steveamena/ManteSistemas/Nomenclatura Engranes.jpeg

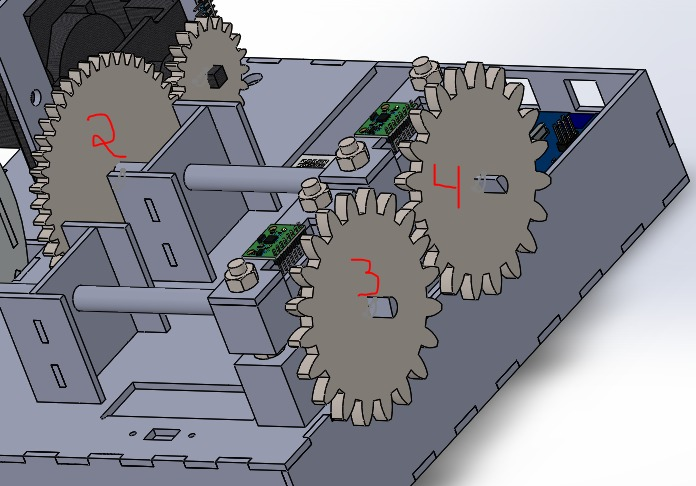
Nomenclatura Engranes.jpeg
