steveamena/ManteSistemas/Protipo_Real.jpg

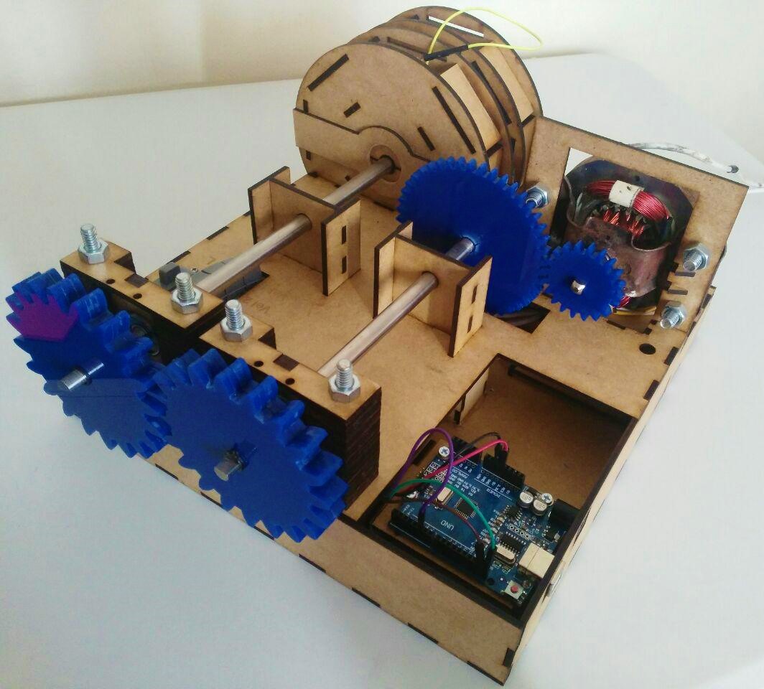
Protipo_Real.jpg
