steveamena/ManteSistemas/README.md

# ManteSistemas
Archivo en git-hub para depositar los diseños de soldworks
