steveamena/ManteSistemas/Control de Compras y amortizacion.xlsx

Sheet: Cálculos
Articulos proyectados comprar |  |  |  |  | Estimación de costos
Artículo | Cant. | Costo/unidad (CRC) | Costo CRC | Comprador | Cantidad | Rubro | Precio/unidad | Precio total | Compra
Dimmer | 1 | 3500 | 3500.00 | D | 1 | Varilla calibrada | 1500 | 1500 | 1
Roles | 6 | 2000 | 12000.00 | D | 3 | Roles 1/4 in | 2500 | 7500 | 1
Jumpers | 16 | 125 | 2000.00 | S | 4 | Acelerómetros | 2850 | 11400 | 1
Tornillos | 1 | 810 | 810.00 | S | 1 | MDF 6 mm 1/4 | 300 | 300 | 1
Acelerómetros | 4 | 2750 | 11000 | S | 1 | Acrílico 6 mm 1/8 | 660 | 660 | 1
Protoboard pequeña | 1 | 2150 | 2150 | S | 1 | Cortes MDF | 4000 | 4000 | 1
Jumpers | 12 | 125 | 1500 | S | 1 | Cortes Acrílico | 800 | 800 | 1
 |  |  |  |  | 4 | Tuercas y tornillos rol | 100 | 400 | 1
 |  |  |  |  | 16 | Tornillos sujeción de sensores | 50 | 800 | 1
 |  |  |  |  | 1 | Cable UTP | 300 | 300 | 1
 |  |  |  |  | 1 | Termocontraíble | 300 | 300 | 1
 |  |  |  |  | 2 | Anillos retención | 200 | 400 | 1
 |  |  |  |  | 1 | Soldadura estaño | 500 | 500 | 1
Total |  |  | 32960.00 |  | 1 | Dimmer | 3500 | 500 | 1
 |  |  |  |  |  |  | Total | 29360 | 1
Amortización de la deuda
Mes | Adicionales | Deuda total | Cuota Mensual | Saldo
abr |  | 29360.00 | 9786.67 | 19573.33
may |  | 19573.33 | 9786.67 | 9786.67
jun |  | 9786.67 | 9786.67 | 0.00

Sheet: Control de pagos
Mes | abr | may | jun
Monto | 0.00 | 0.00 | 0.00
Steve M | 0 | 0 | 0
Diego A | 1 | 1 | 1
 |  |  |  | Grand total
Total | 0.00 | 0.00 | 0.00 | 0.00
