steveamena/ManteSistemas/Base/EnsamblajeBase.SLDASM

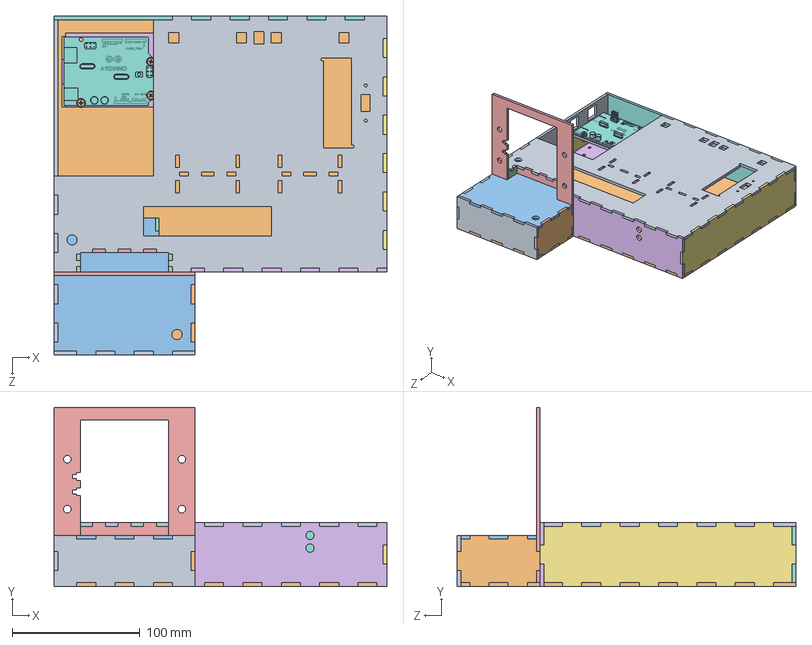
[picture p9: CAD file, 2018-06-08]
Base/EnsamblajeBase.SLDASM
260.0 x 140.0 x 265.0 mm
Base1
Base2
Base4
Bae5_2 x 2
Base6
Base7
Base8
Base9
Base10
Base12
Soporte_Arduino x 2
Lateral x 2
Arduino board
Base11
flat head screw_am x 3
hex thin nut chamfered gradeab_iso x 3
plain washer 10673 type snl_iso x 3
Base3_2
Soporte_a_base x 4
