steveamena/ManteSistemas/Carga/EnsamblajeCarga.SLDASM

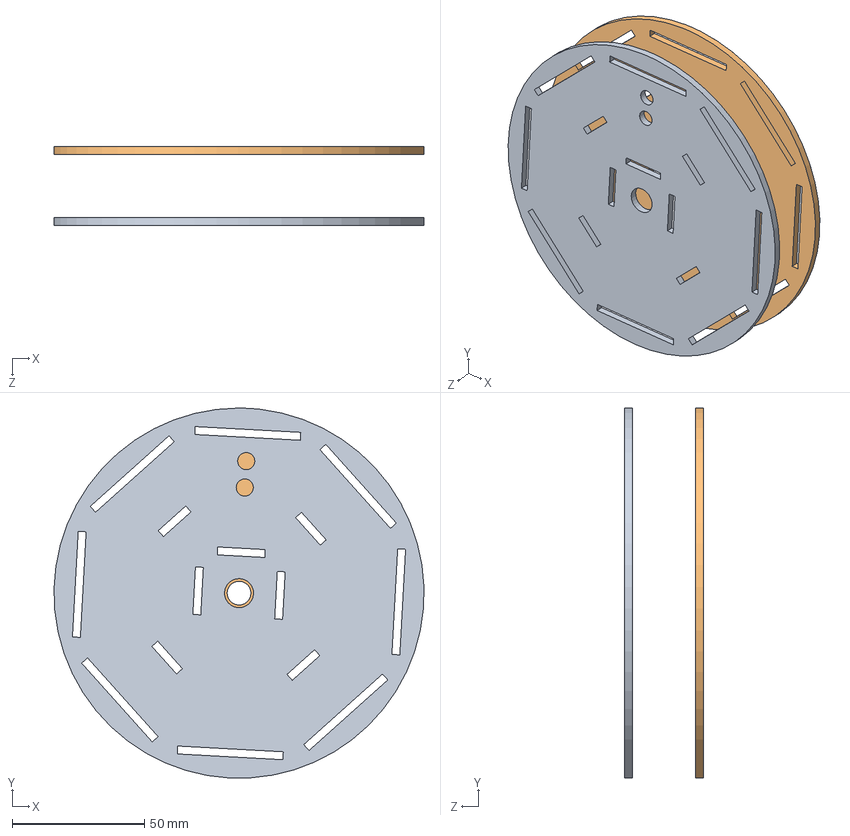
[picture p10: CAD file, 2018-06-08]
Carga/EnsamblajeCarga.SLDASM
139.9 x 139.9 x 30.0 mm
Carga3_1
Carga1
