steveamena/ManteSistemas/EnsamblajeFinal2.SLDASM

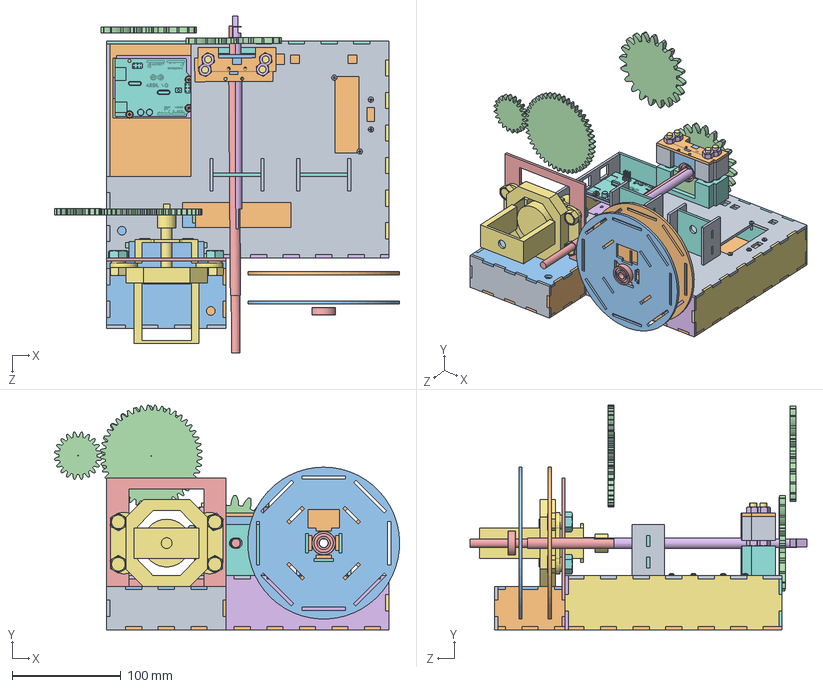
[picture p11: CAD file, 2018-06-08]
EnsamblajeFinal2.SLDASM
318.2 x 207.2 x 310.6 mm
Base1
Base2
Base4
Bae5_2 x 2
Base6
Base7
Base8
Base9
Base10
Base12
Soporte_Arduino x 2
Lateral x 2
Arduino board
Base11
flat head screw_am x 3
hex thin nut chamfered gradeab_iso x 3
plain washer 10673 type snl_iso x 3
Base3_2 x 2
Soporte_a_base x 4
Motor
Pieza_Inferior x 2
Pieza_Superior x 4
Base_Sensor x 2
Central_Pieza x 2
Central_Pieza Inferior x 2
radial ball bearing_68_skf x 3
hex nut_ai x 8
round head square neck bolt_ai x 4
SoporteEje1 x 2
SoporteEje2 x 4
Carga3_1
Carga1
spur gear_am x 4
Eje_Carga
Eje
hex screw_ai x 4
machine screw nut hex_ai x 4
pan head cross recess screw_iso x 4
basic internal retaining ring_am x 3
