steveamena/ManteSistemas/Soporte Arduino/Ensamblaje_Electronica.SLDASM

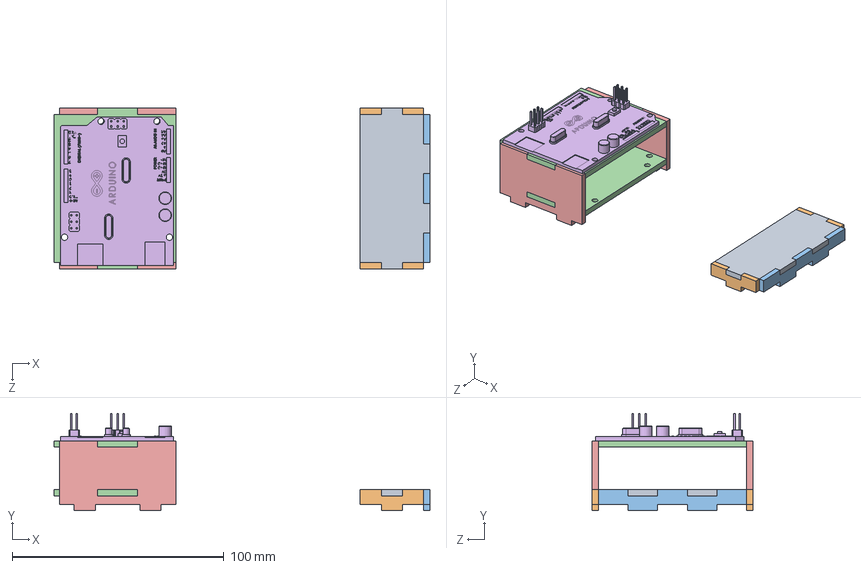
[picture p12: CAD file, 2018-06-08]
Soporte Arduino/Ensamblaje_Electronica.SLDASM
177.5 x 46.0 x 76.0 mm
Superior Derecha
Soporte Frontal x 2
Soporte Lateral
Soporte_Arduino x 2
Lateral x 2
Arduino board
