steveamena/ManteSistemas/Soporte Rol/Soporte_Rol.SLDASM

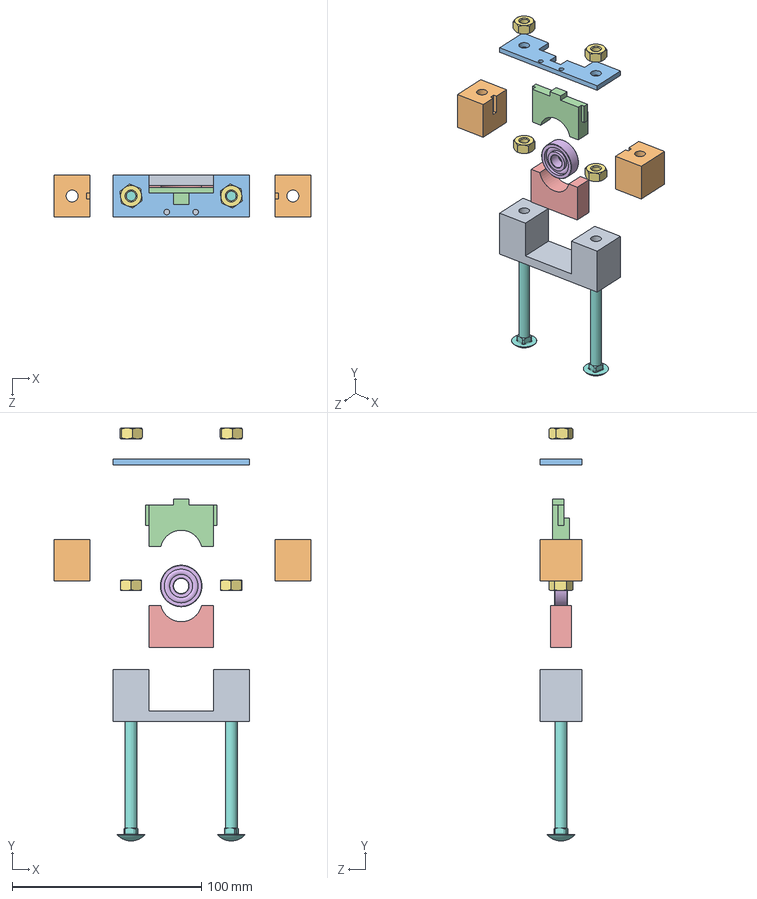
[picture p13: CAD file, 2018-06-08]
Soporte Rol/Soporte_Rol.SLDASM
135.7 x 218.4 x 22.0 mm
Pieza_Inferior
Pieza_Superior x 2
Base_Sensor
Central_Pieza
Central_Pieza Inferior
radial ball bearing_68_skf
hex nut_ai x 4
round head square neck bolt_ai x 2
