steveamena/ManteSistemas/SoporteEje/EnsamblajeSoporteEje.SLDASM

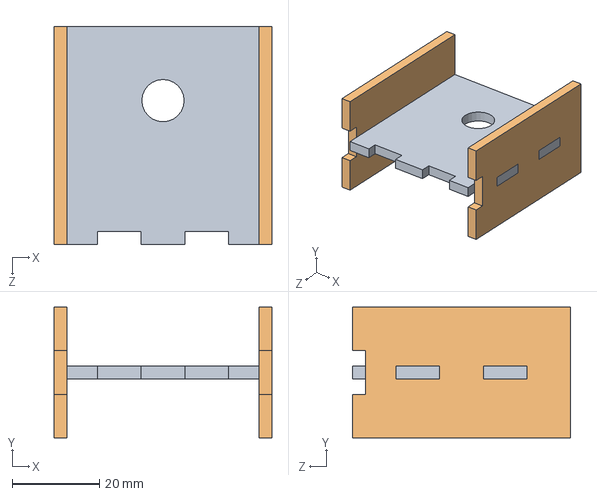
[picture p14: CAD file, 2018-04-15]
SoporteEje/EnsamblajeSoporteEje.SLDASM
50.0 x 30.0 x 50.0 mm
SoporteEje1
SoporteEje2 x 2
