steveamena/ManteSistemas/Soporte Arduino/Soporte Izquierda.SLDASM

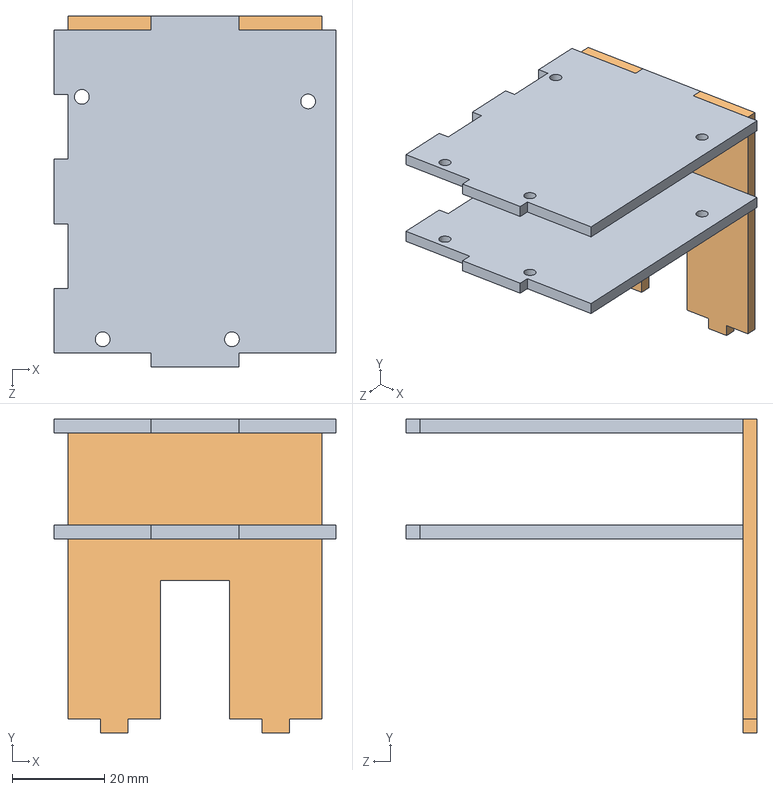
[picture p15: CAD file, 2018-05-15]
Soporte Arduino/Soporte Izquierda.SLDASM
61.0 x 68.0 x 76.0 mm
Soporte_Arduino x 2
Lateral
