steveamena/ManteSistemas/Acelerometro Lateral/Sccel_Lat.SLDASM

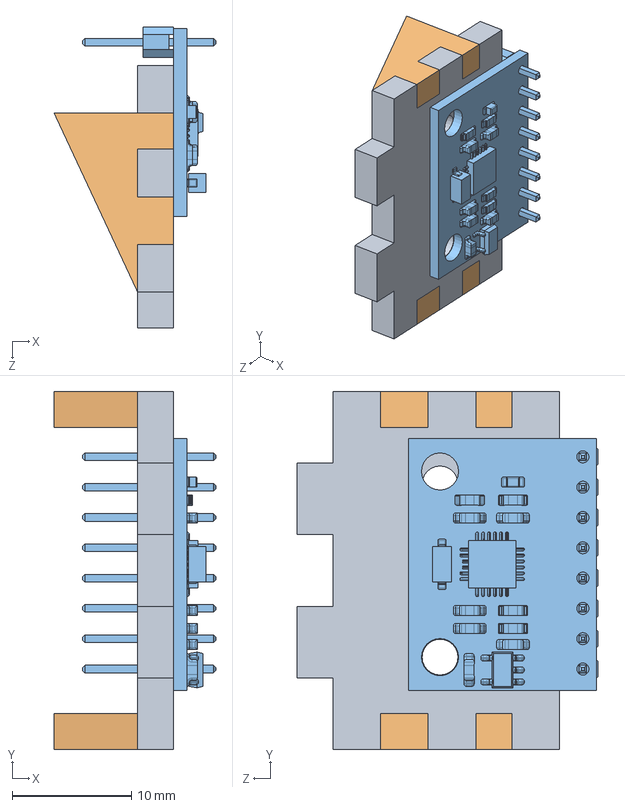
[picture p16: CAD file, 2018-04-23]
Acelerometro Lateral/Sccel_Lat.SLDASM
13.6 x 30.0 x 25.2 mm
Acelerometro_Motor_1
Acelerometro_Motor_2 x 2
Acelerometro
