steveamena/ManteSistemas/EnsamblajeFinal2 - Backup 7-06-2018.SLDASM

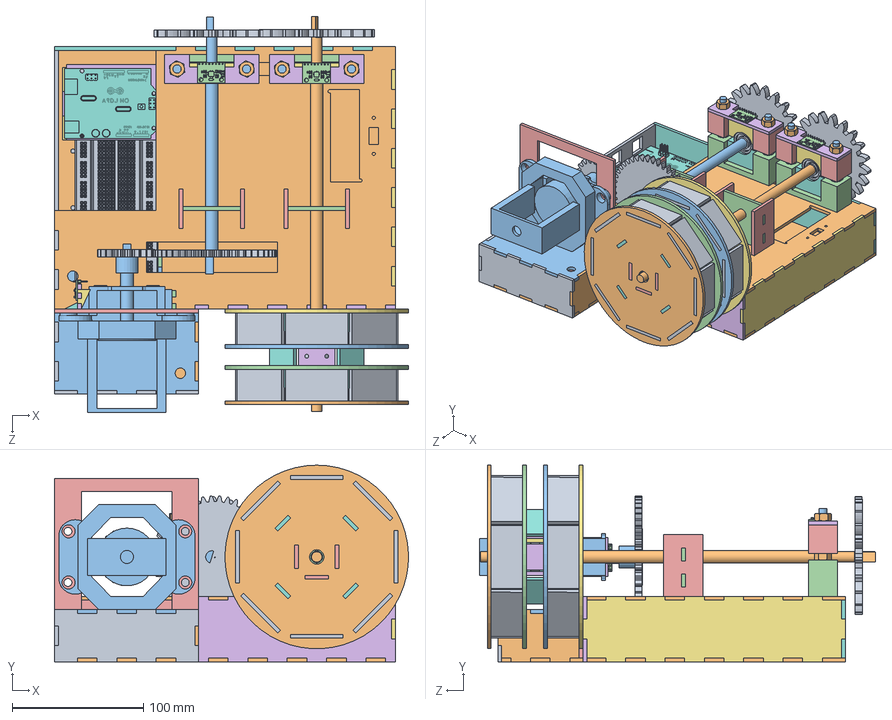
[picture p17: CAD file, 2018-05-24]
EnsamblajeFinal2 - Backup 7-06-2018.SLDASM
270.0 x 150.0 x 302.1 mm
Base1
Base2
Base4
Bae5_2 x 2
Base6
Base7
Base8
Base9
Base10
Base12
Superior Derecha
Soporte Frontal x 2
Soporte Lateral
Soporte_Arduino x 2
Lateral x 2
Arduino board
BreadBoard Large
Base11
Motor
Pieza_Inferior x 2
Pieza_Superior x 4
Base_Sensor x 2
Central_Pieza x 2
Central_Pieza Inferior x 2
radial ball bearing_68_skf x 3
hex nut_ai x 8
round head square neck bolt_ai x 4
SoporteEje1 x 2
SoporteEje2 x 4
Carga2 x 3
Carga3_1
Carga4 x 4
Carga5 x 16
Carga3
Carga1
Carga1_1
Carga6 x 6
Acelerometro_Sujecion
Carga2_Acelerometro
Sujecion_Rol_Lateral x 2
spur gear_am x 4
Eje_Carga
Eje
Acelerometro x 3
Base3_2
Acelerometro_Motor_1
Acelerometro_Motor_2 x 2
Puntal x 2
