steveamena/ManteSistemas/Soporte Arduino/Soporte Derecha.SLDASM

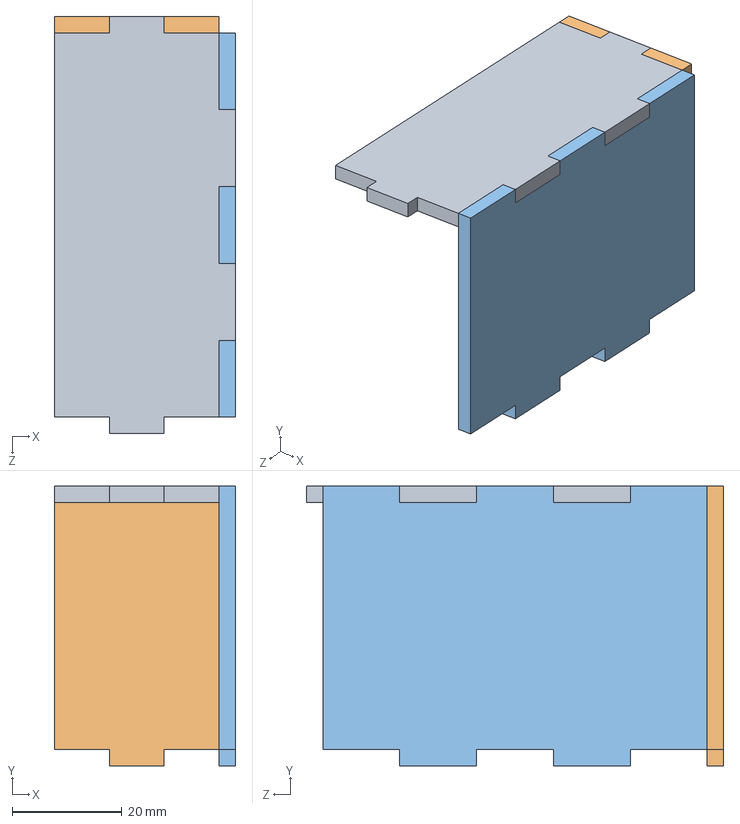
[picture p18: CAD file, 2018-04-15]
Soporte Arduino/Soporte Derecha.SLDASM
33.0 x 51.0 x 76.0 mm
Superior Derecha
Soporte Frontal
Soporte Lateral
