steveamena/ManteSistemas/Carga/EnsamblajeCarga Nuevo.SLDASM

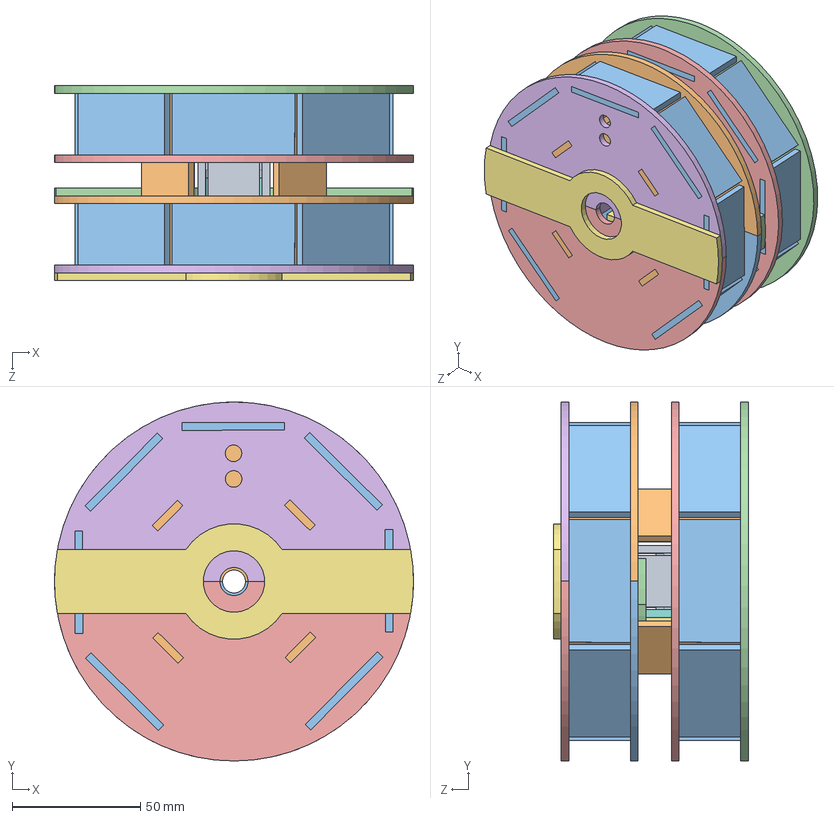
[picture p19: CAD file, 2018-06-08]
Carga/EnsamblajeCarga Nuevo.SLDASM
140.0 x 140.0 x 76.0 mm
Carga2 x 3
Carga4 x 4
Carga5 x 16
Carga3
Carga1_1
Carga6 x 6
Acelerometro_Sujecion
Carga2_Acelerometro
Sujecion_Rol_Lateral x 2
Carga1_CAMBIOS2
Carga1_CAMBIOS1
Soportepiezas2
Carga3_1_CAMBIOS
Carga3_1_CAMBIOS2
Soportepiezas1
