steveamena/ManteSistemas/EnsamblajeFinal.SLDASM

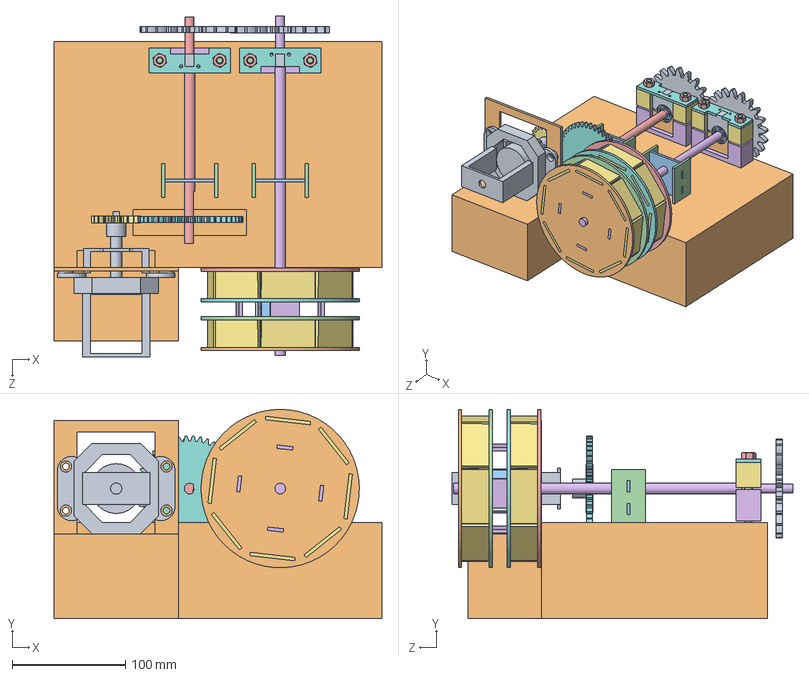
[picture p20: CAD file, 2018-04-15]
EnsamblajeFinal.SLDASM
290.0 x 185.0 x 301.3 mm
Motor
Base
Carga2 x 4
Carga1
Carga3_1
Carga4 x 4
Carga5 x 16
Carga1_1
Acelerometro_Sujecion
Carga3
SoporteEje1 x 2
SoporteEje2 x 4
Eje
Pieza_Inferior x 2
Pieza_Superior x 4
Base_Sensor x 2
Central_Pieza x 2
Central_Pieza Inferior x 2
radial ball bearing_68_skf x 3
hex bolt_ai x 4
hex nut_ai x 8
Eje_Carga
Engrane1
Engrane2
Engrane3y4 x 2
