steveamena/ManteSistemas/Carga/Ensamblaje6.SLDASM

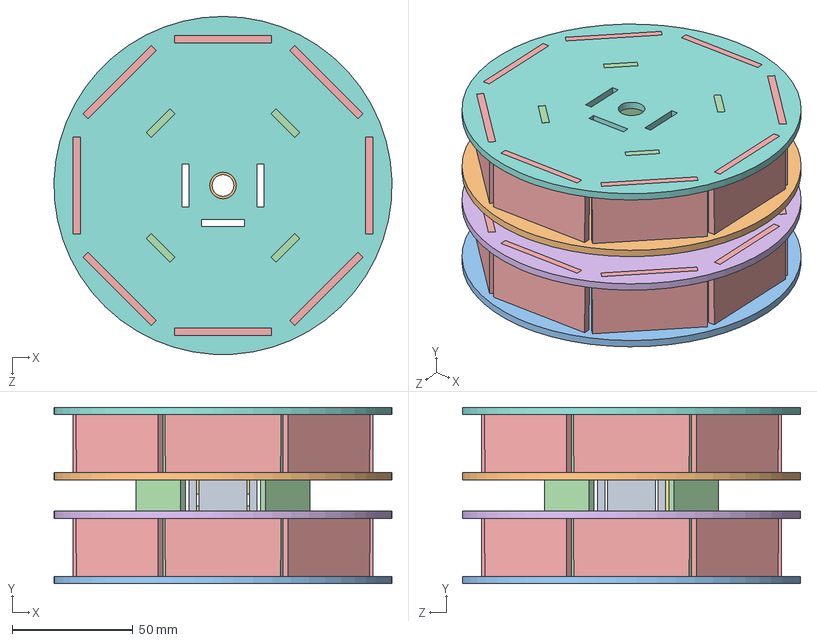
[picture p21: CAD file, 2018-06-08]
Carga/Ensamblaje6.SLDASM
139.9 x 73.0 x 140.0 mm
Carga2 x 4
Carga1
Carga3_1
Carga4 x 4
Carga5 x 16
Carga1_1
Acelerometro_Sujecion
Carga3
