steveamena/ManteSistemas/Acelerometro Lateral/Puntal.SLDPRT

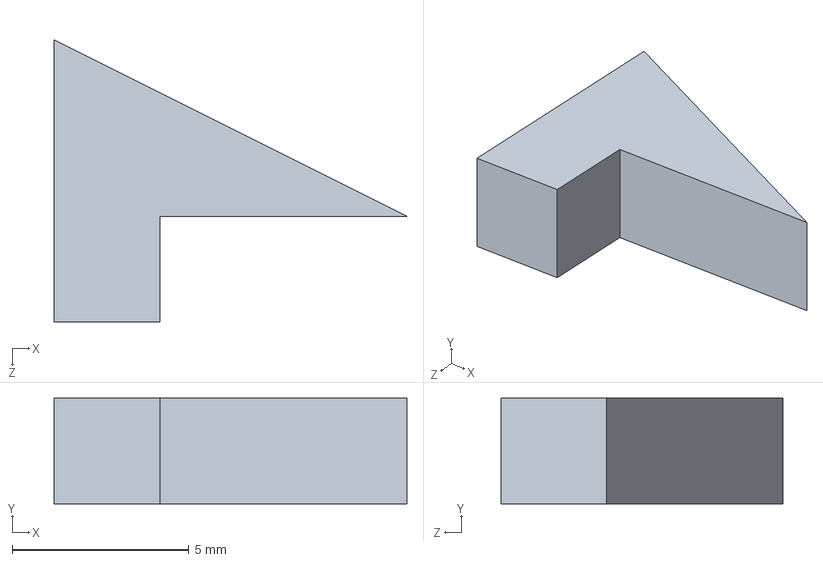
[picture p22: CAD file, 2018-04-23]
Acelerometro Lateral/Puntal.SLDPRT
10.0 x 3.00 x 8.00 mm
