steveamena/ManteSistemas/Soporte Arduino/Arduino/Arduino board.SLDPRT

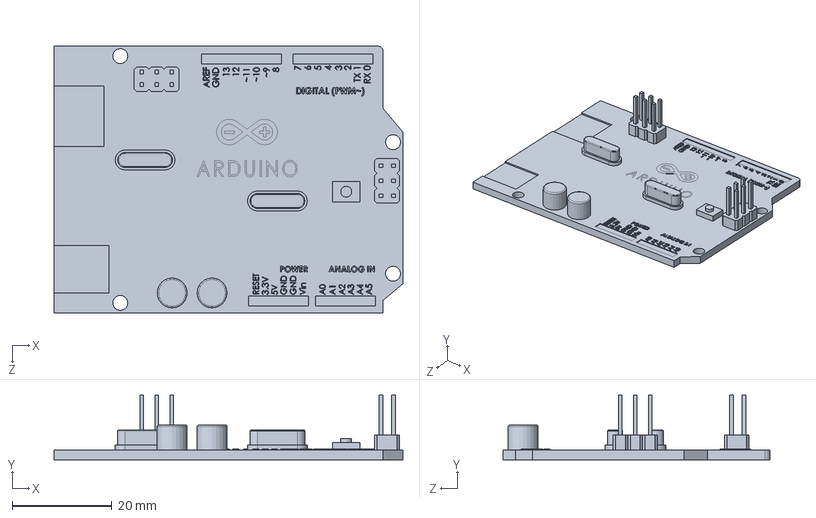
[picture p23: CAD file, 2018-04-09]
Soporte Arduino/Arduino/Arduino board.SLDPRT
70.0 x 13.0 x 53.5 mm
