steveamena/ManteSistemas/Soporte Arduino/Protoboard/BreadBoard Large.SLDPRT

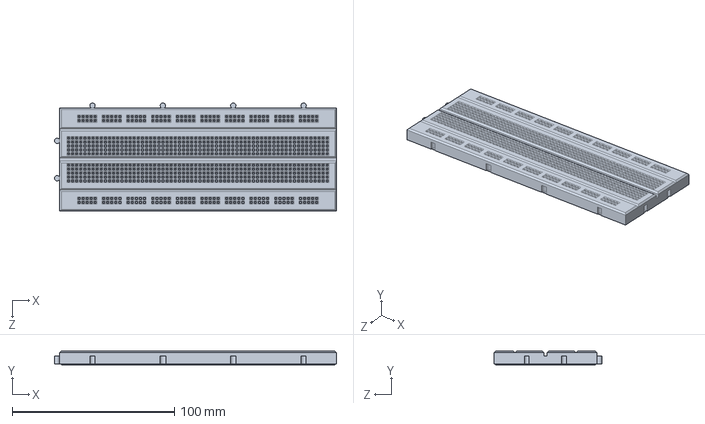
[picture p24: CAD file, 2018-04-09]
Soporte Arduino/Protoboard/BreadBoard Large.SLDPRT
173.7 x 8.50 x 66.6 mm
