steveamena/ManteSistemas/Acelerometro Lateral/Acelerometro_Motor_2.SLDPRT

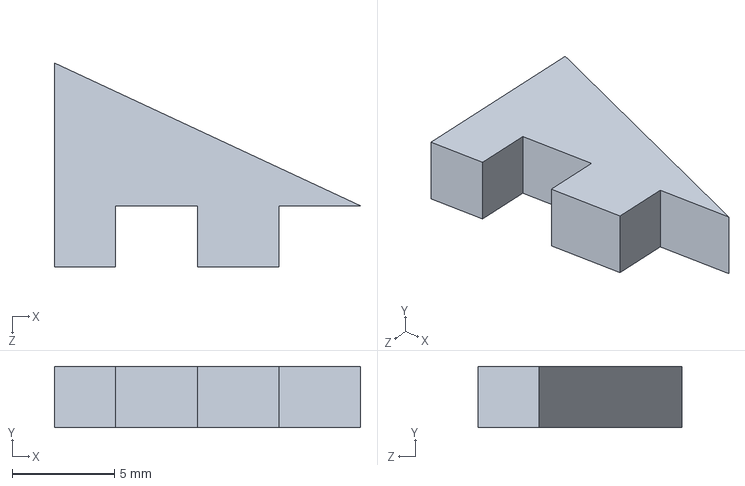
[picture p25: CAD file, 2018-04-23]
Acelerometro Lateral/Acelerometro_Motor_2.SLDPRT
15.0 x 3.00 x 10.0 mm
