steveamena/ManteSistemas/Base/Soporte_a_base.SLDPRT

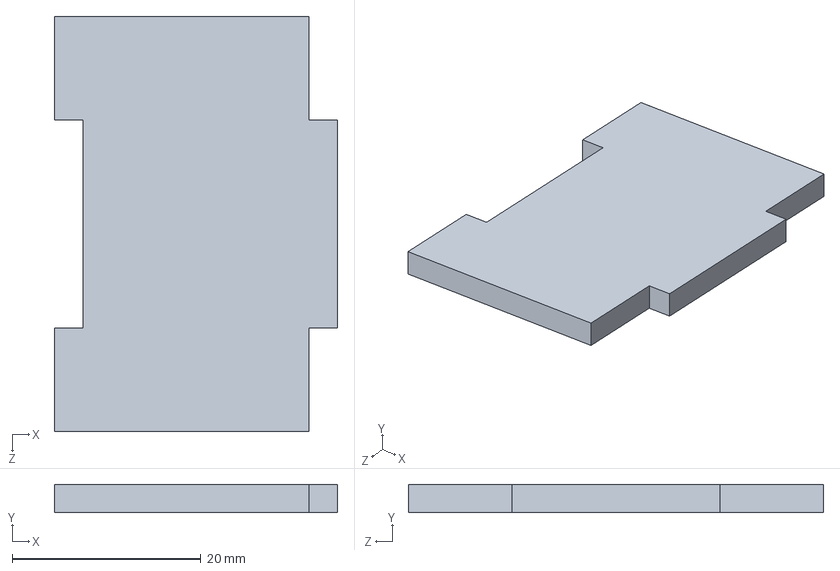
[picture p26: CAD file, 2018-05-24]
Base/Soporte_a_base.SLDPRT
30.0 x 3.00 x 44.0 mm
