steveamena/ManteSistemas/Engrane3_Motor.SLDPRT

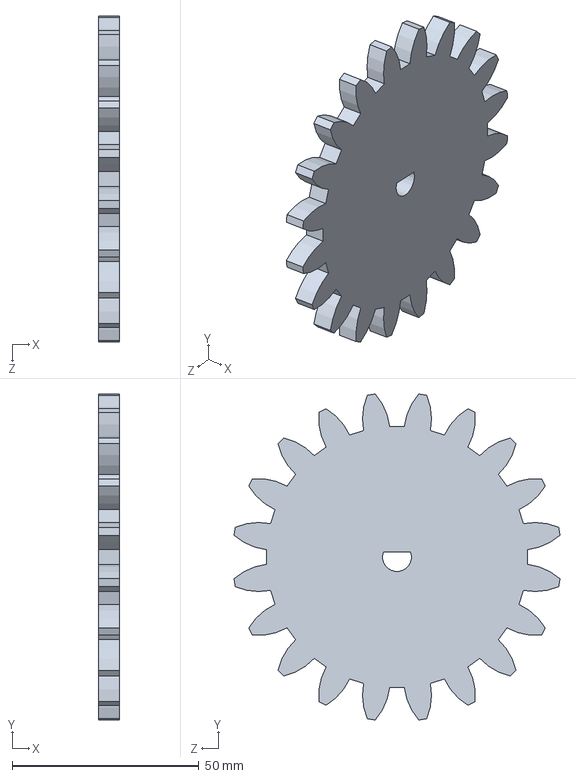
[picture p28: CAD file, 2018-05-24]
Engrane3_Motor.SLDPRT
5.50 x 87.2 x 87.2 mm
