steveamena/ManteSistemas/Soporte Rol/Eje.SLDPRT

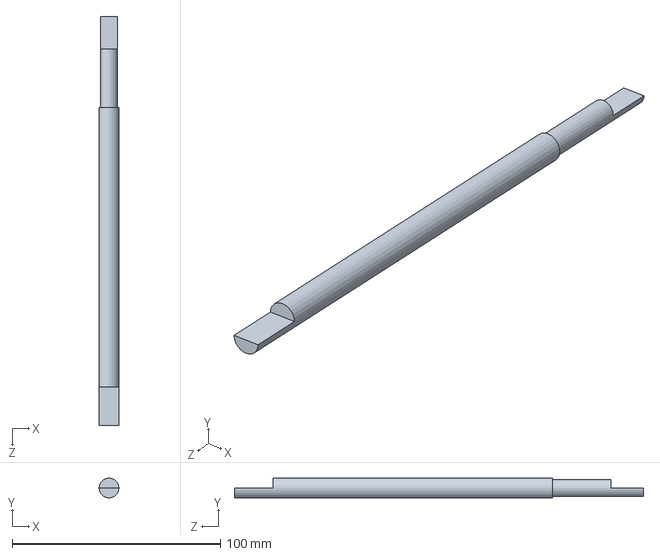
[picture p29: CAD file, 2018-05-04]
Soporte Rol/Eje.SLDPRT
9.53 x 9.53 x 196.2 mm
