steveamena/ManteSistemas/SoporteEje/SoporteEje2.SLDPRT

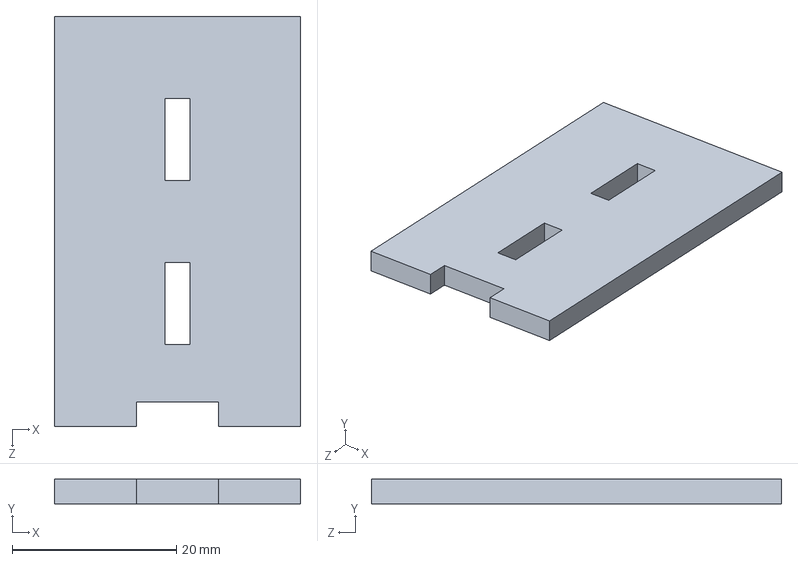
[picture p30: CAD file, 2018-04-15]
SoporteEje/SoporteEje2.SLDPRT
30.0 x 3.00 x 50.0 mm
