steveamena/ManteSistemas/Base/Base11.SLDPRT

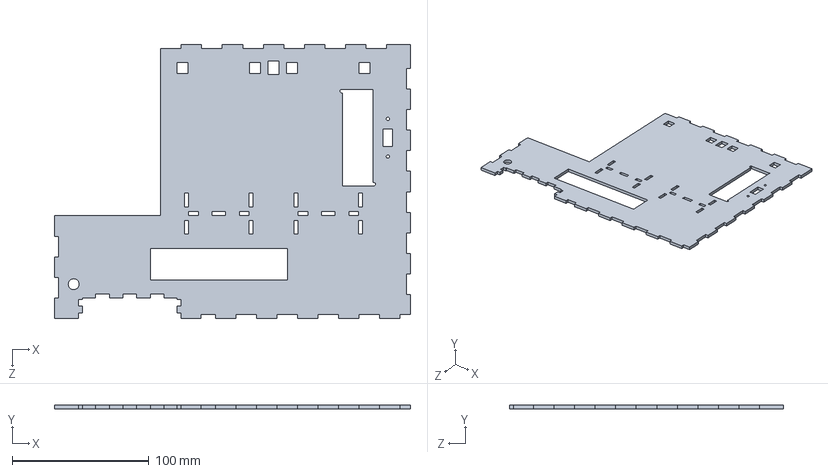
[picture p31: CAD file, 2018-05-09]
Base/Base11.SLDPRT
260.0 x 3.00 x 200.0 mm
