steveamena/ManteSistemas/Carga/Sujecion_Rol_Lateral.SLDPRT

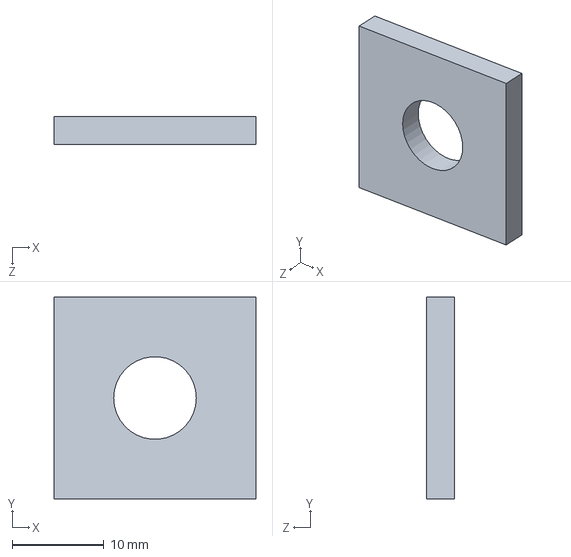
[picture p32: CAD file, 2018-06-08]
Carga/Sujecion_Rol_Lateral.SLDPRT
22.0 x 22.0 x 3.00 mm
