steveamena/ManteSistemas/Soporte Arduino/Soporte_Arduino.SLDPRT

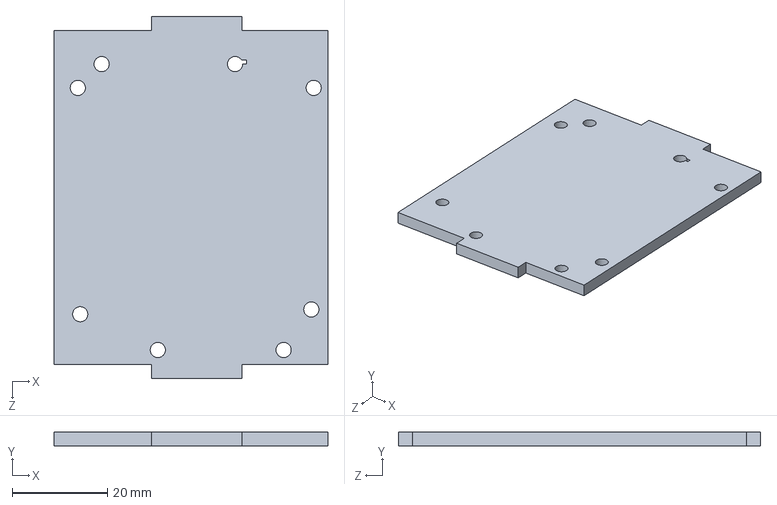
[picture p33: CAD file, 2018-05-09]
Soporte Arduino/Soporte_Arduino.SLDPRT
57.5 x 3.00 x 76.0 mm
