steveamena/ManteSistemas/Soporte Rol/Pieza_Inferior.SLDPRT

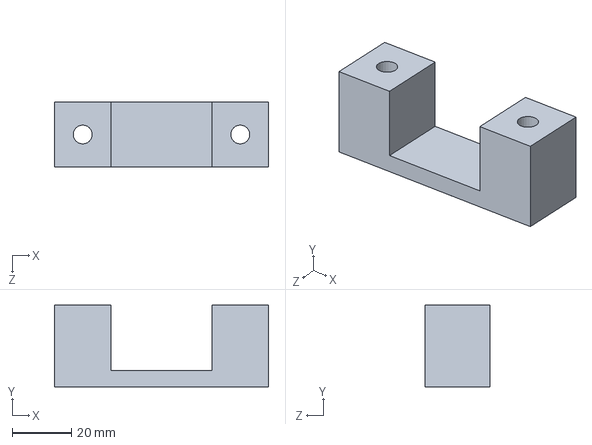
[picture p34: CAD file, 2018-04-23]
Soporte Rol/Pieza_Inferior.SLDPRT
72.0 x 27.5 x 22.0 mm
