steveamena/ManteSistemas/SoporteEje/SoporteEje1.SLDPRT

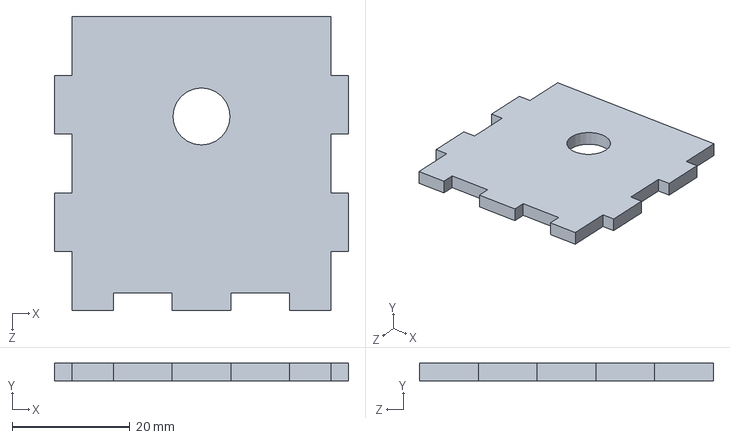
[picture p35: CAD file, 2018-04-15]
SoporteEje/SoporteEje1.SLDPRT
50.0 x 3.00 x 50.0 mm
