steveamena/ManteSistemas/Acelerometro Lateral/Acelerometro_Motor_1.SLDPRT

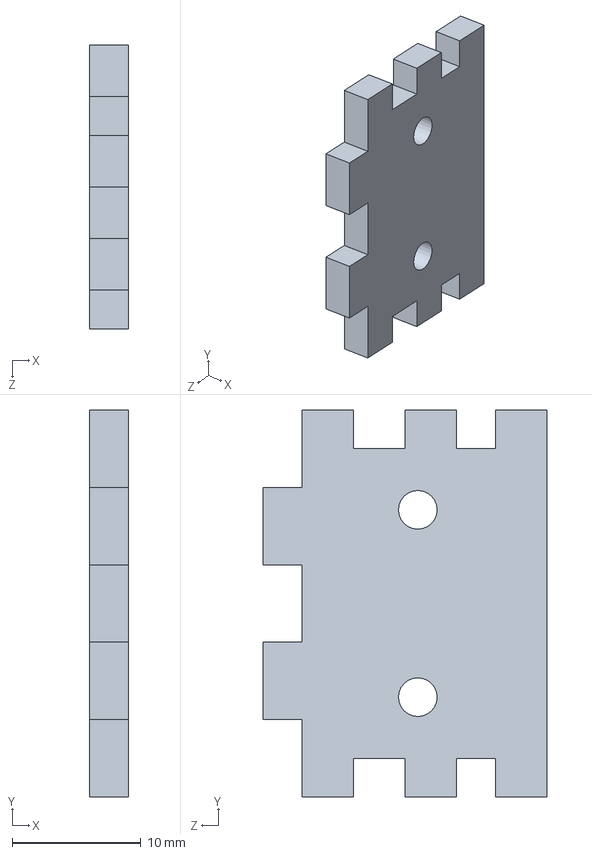
[picture p36: CAD file, 2018-04-23]
Acelerometro Lateral/Acelerometro_Motor_1.SLDPRT
3.00 x 30.0 x 22.0 mm
