steveamena/ManteSistemas/Base/Base4.SLDPRT

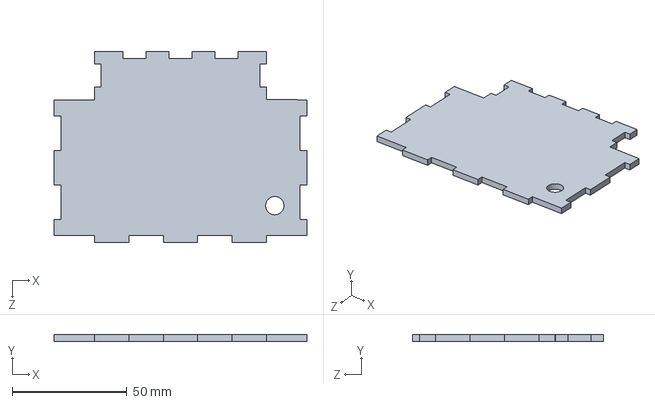
[picture p37: CAD file, 2018-04-26]
Base/Base4.SLDPRT
110.0 x 3.00 x 83.0 mm
