steveamena/ManteSistemas/Carga/Carga6.SLDPRT

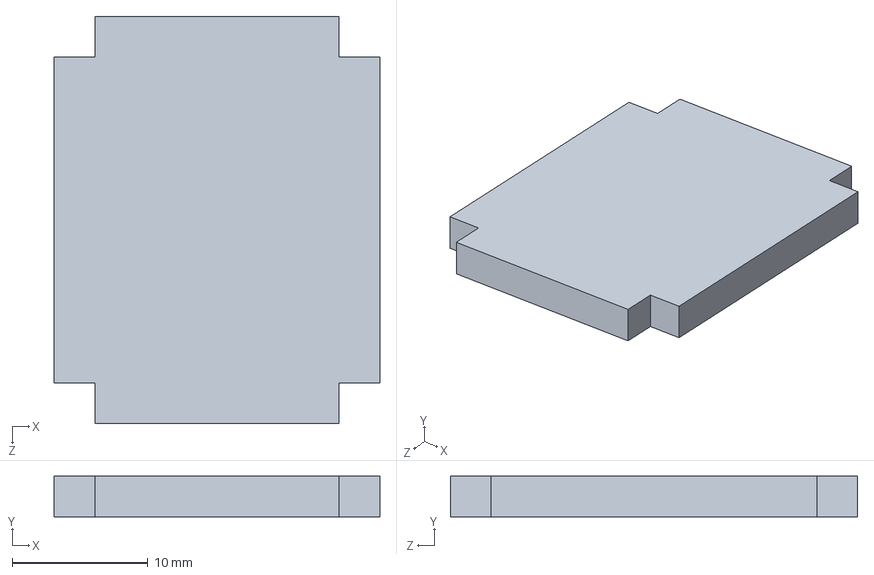
[picture p38: CAD file, 2018-06-08]
Carga/Carga6.SLDPRT
24.0 x 3.00 x 30.0 mm
