steveamena/ManteSistemas/Soporte Arduino/Lateral.SLDPRT

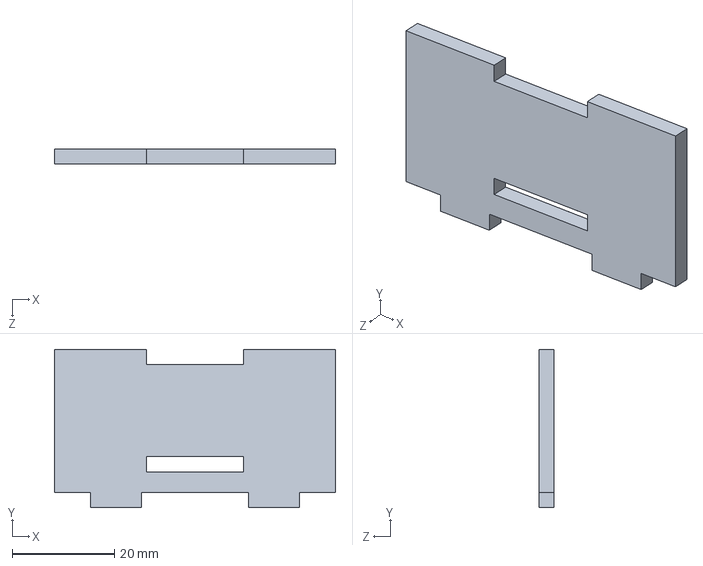
[picture p39: CAD file, 2018-05-09]
Soporte Arduino/Lateral.SLDPRT
55.0 x 31.0 x 3.00 mm
