steveamena/ManteSistemas/Soporte Rol/Central_Pieza.SLDPRT

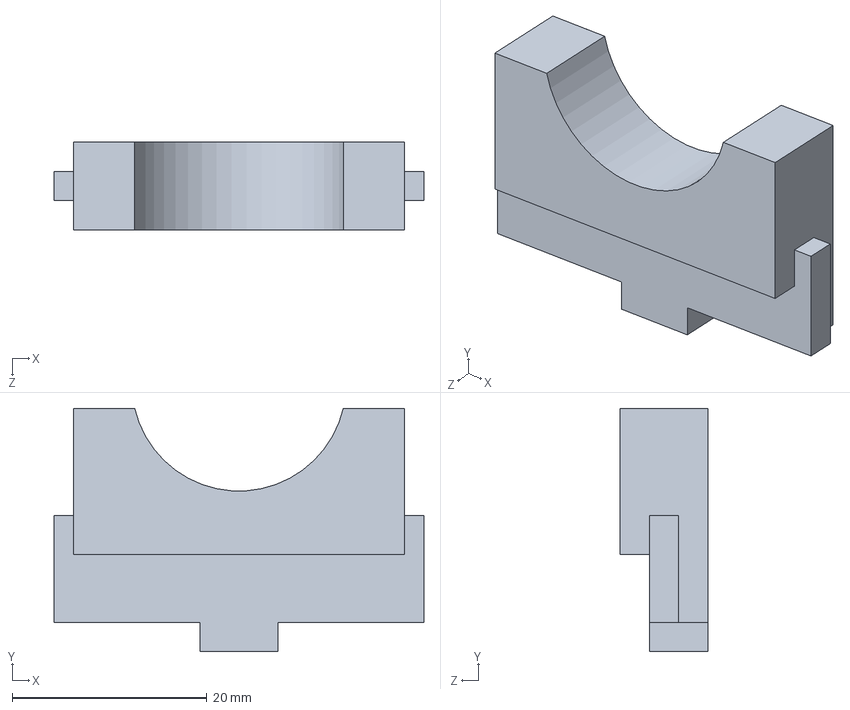
[picture p40: CAD file, 2018-04-17]
Soporte Rol/Central_Pieza.SLDPRT
38.0 x 25.0 x 9.00 mm
