steveamena/ManteSistemas/Base/Base10.SLDPRT

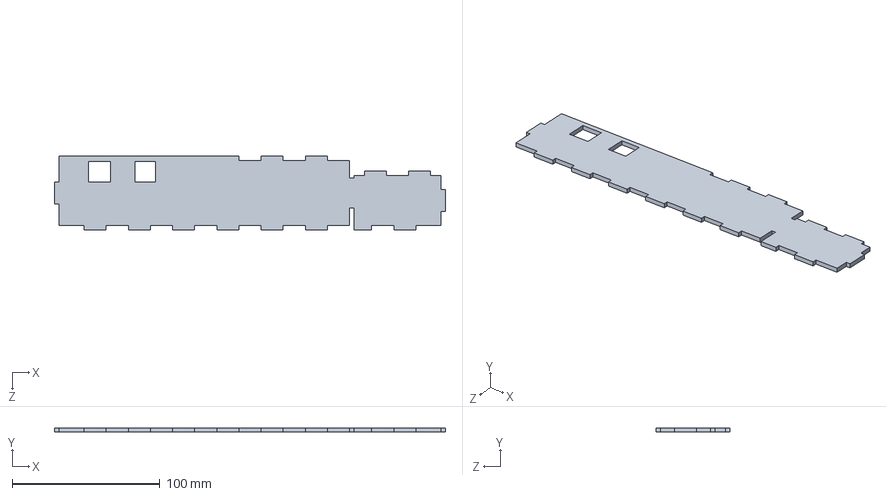
[picture p41: CAD file, 2018-04-26]
Base/Base10.SLDPRT
265.0 x 3.00 x 50.0 mm
