steveamena/ManteSistemas/Carga/Carga2_Acelerometro.SLDPRT

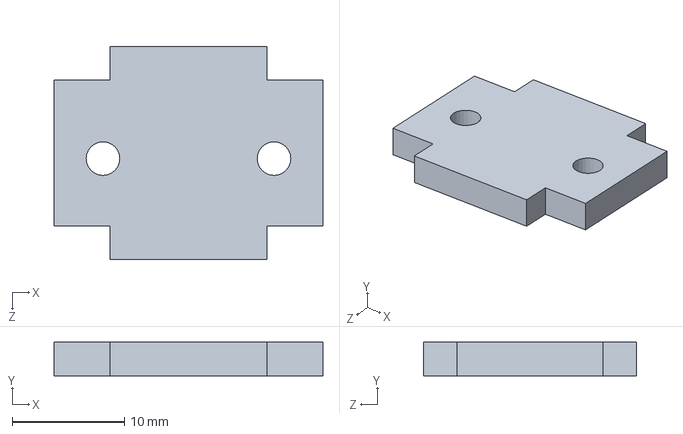
[picture p42: CAD file, 2018-06-08]
Carga/Carga2_Acelerometro.SLDPRT
24.0 x 3.00 x 19.0 mm
