steveamena/ManteSistemas/Engrane2_3_80.SLDPRT

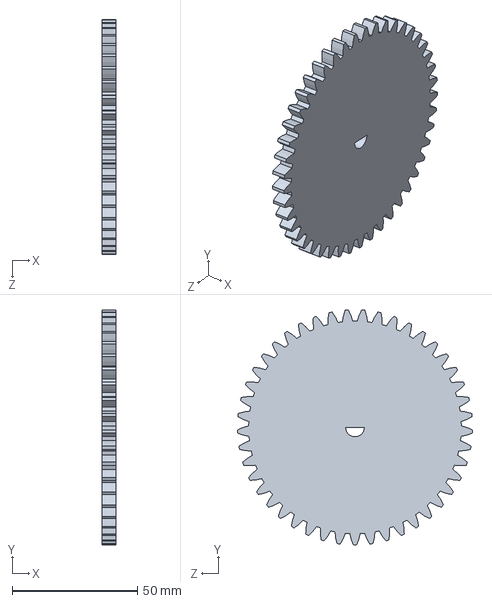
[picture p43: CAD file, 2018-05-24]
Engrane2_3_80.SLDPRT
5.50 x 93.9 x 94.0 mm
