steveamena/ManteSistemas/Soporte Arduino/Soporte Frontal.SLDPRT

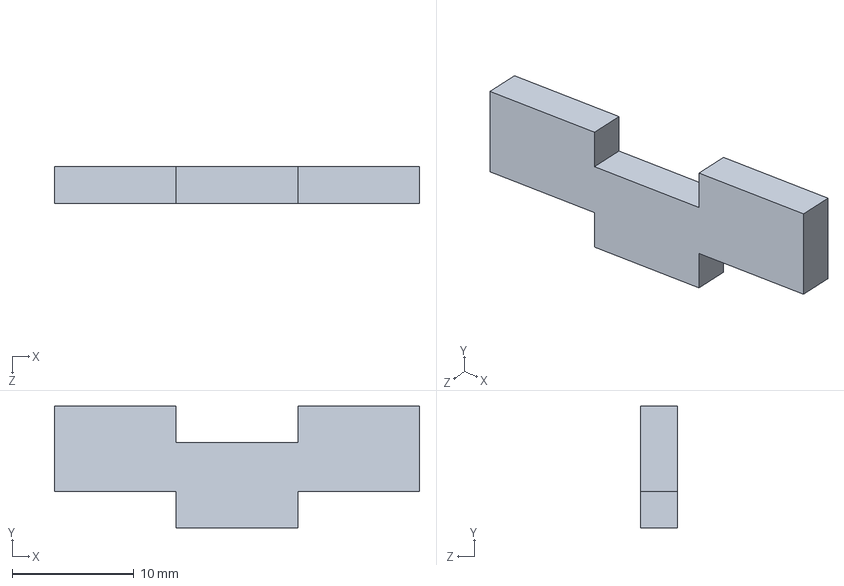
[picture p44: CAD file, 2018-04-15]
Soporte Arduino/Soporte Frontal.SLDPRT
30.0 x 10.0 x 3.00 mm
