steveamena/ManteSistemas/Soporte Rol/Pieza_Superior.SLDPRT

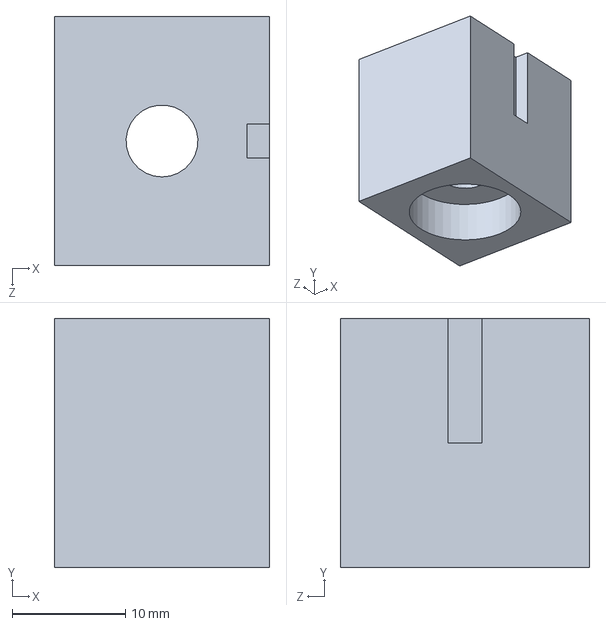
[picture p45: CAD file, 2018-04-17]
Soporte Rol/Pieza_Superior.SLDPRT
19.0 x 22.0 x 22.0 mm
