steveamena/ManteSistemas/AnilloEngranes.SLDPRT

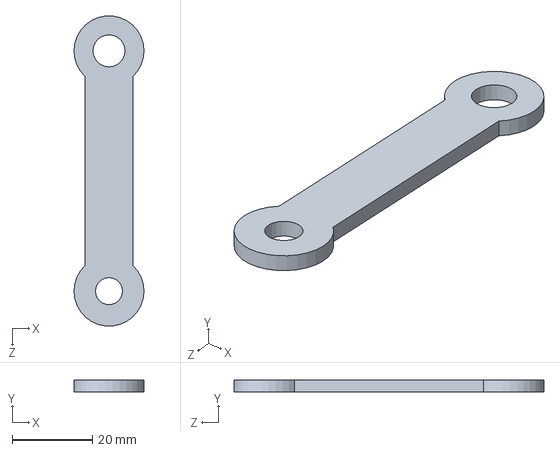
[picture p46: CAD file, 2018-05-15]
AnilloEngranes.SLDPRT
17.5 x 3.00 x 77.4 mm
