steveamena/ManteSistemas/Base/Base3_2.SLDPRT

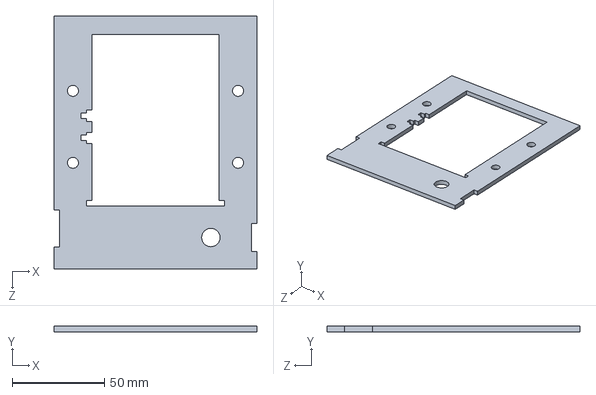
[picture p47: CAD file, 2018-04-25]
Base/Base3_2.SLDPRT
110.0 x 3.00 x 137.0 mm
