steveamena/ManteSistemas/Carga/Soportepiezas2.SLDPRT

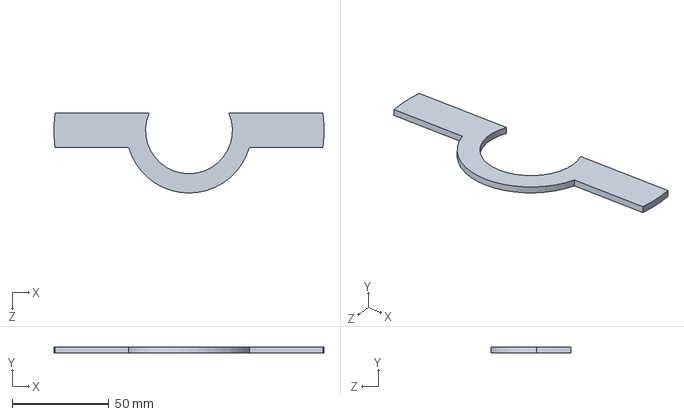
[picture p48: CAD file, 2018-06-08]
Carga/Soportepiezas2.SLDPRT
139.9 x 3.00 x 41.5 mm
