steveamena/ManteSistemas/Soporte Rol/Central_Pieza Inferior.SLDPRT

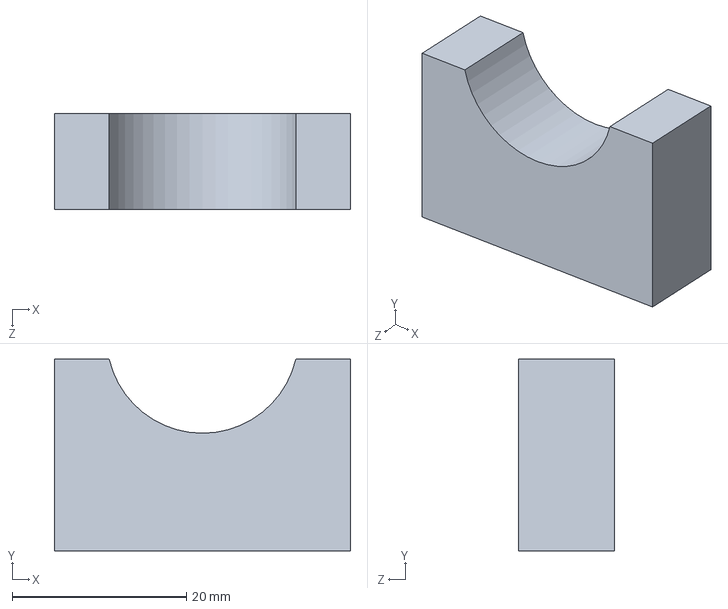
[picture p49: CAD file, 2018-04-17]
Soporte Rol/Central_Pieza Inferior.SLDPRT
34.0 x 22.0 x 11.0 mm
