steveamena/ManteSistemas/Base/Soporte_Botonera.SLDPRT

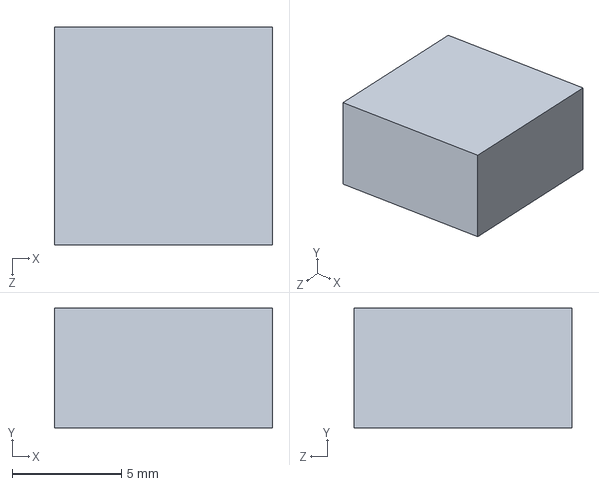
[picture p50: CAD file, 2018-04-24]
Base/Soporte_Botonera.SLDPRT
10.0 x 5.50 x 10.0 mm
