steveamena/ManteSistemas/Soporte Arduino/Soporte Lateral.SLDPRT

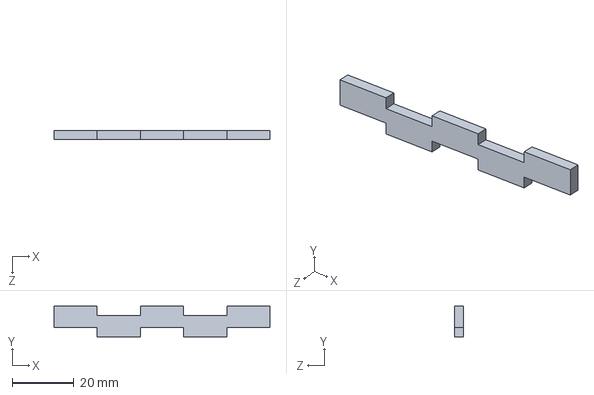
[picture p51: CAD file, 2018-04-15]
Soporte Arduino/Soporte Lateral.SLDPRT
70.0 x 10.0 x 3.00 mm
