steveamena/ManteSistemas/Soporte Rol/Base_Sensor.SLDPRT

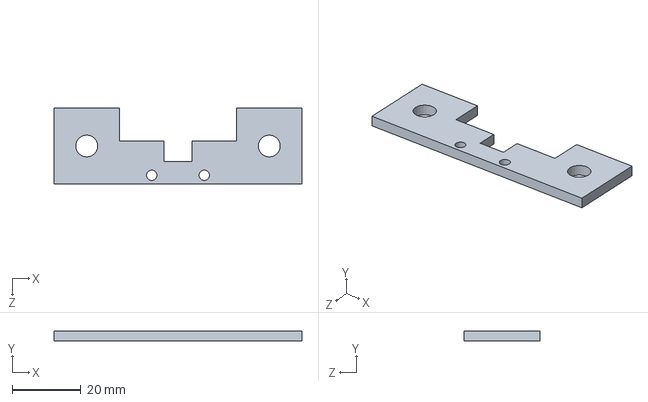
[picture p52: CAD file, 2018-04-17]
Soporte Rol/Base_Sensor.SLDPRT
72.0 x 3.00 x 22.0 mm
