steveamena/ManteSistemas/Base/Base9.SLDPRT

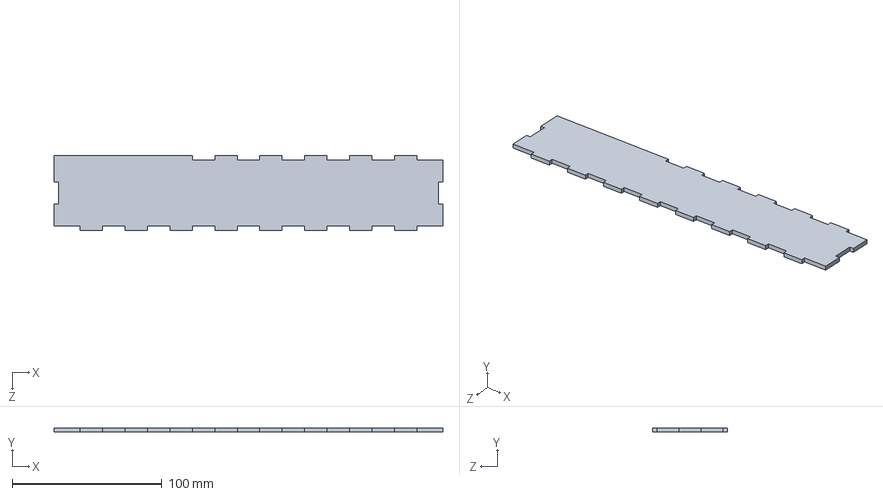
[picture p53: CAD file, 2018-04-23]
Base/Base9.SLDPRT
260.0 x 3.00 x 50.0 mm
