steveamena/ManteSistemas/Carga/Carga1_1.SLDPRT

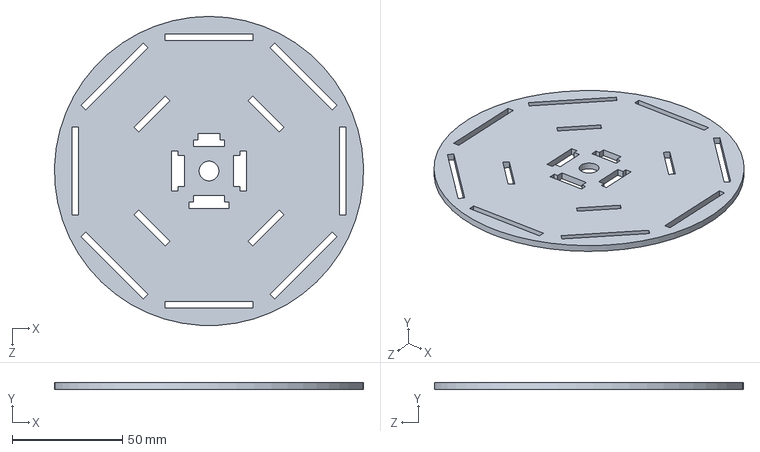
[picture p54: CAD file, 2018-06-08]
Carga/Carga1_1.SLDPRT
139.9 x 3.00 x 140.0 mm
