steveamena/ManteSistemas/Soporte Arduino/Superior Derecha.SLDPRT

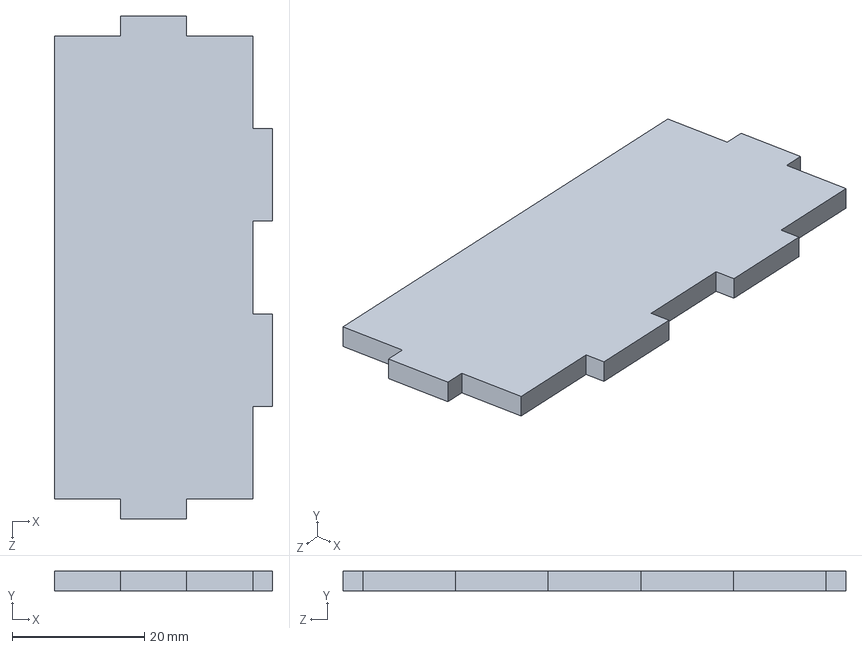
[picture p55: CAD file, 2018-04-09]
Soporte Arduino/Superior Derecha.SLDPRT
33.0 x 3.00 x 76.0 mm
