steveamena/ManteSistemas/Soporte Rol/Cojinete SKF 608.SLDPRT

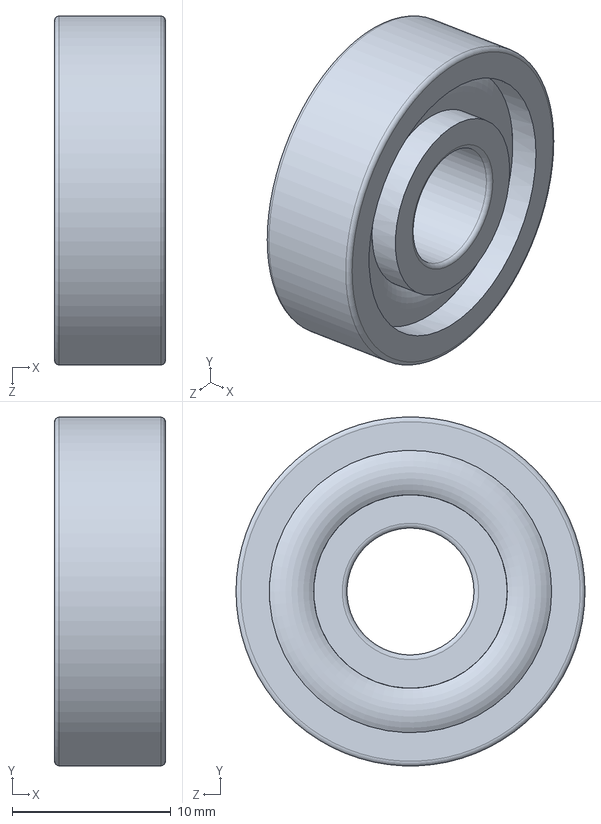
[picture p56: CAD file, 2018-04-09]
Soporte Rol/Cojinete SKF 608.SLDPRT
7.00 x 22.0 x 22.0 mm
