steveamena/ManteSistemas/Base/Base7.SLDPRT

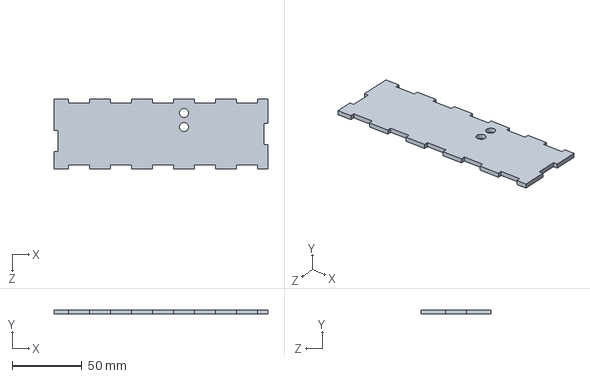
[picture p57: CAD file, 2018-04-15]
Base/Base7.SLDPRT
153.0 x 3.00 x 50.0 mm
