steveamena/ManteSistemas/Eje_Carga.SLDPRT

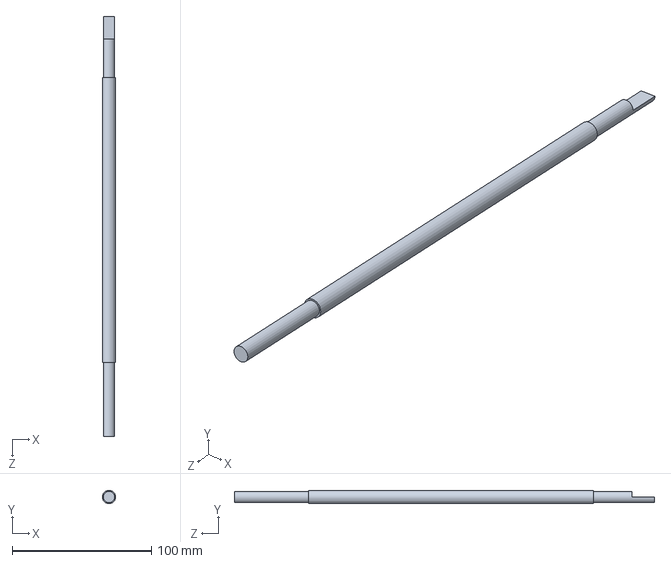
[picture p58: CAD file, 2018-05-04]
Eje_Carga.SLDPRT
9.53 x 9.53 x 301.3 mm
