steveamena/ManteSistemas/Base/Base12.SLDPRT

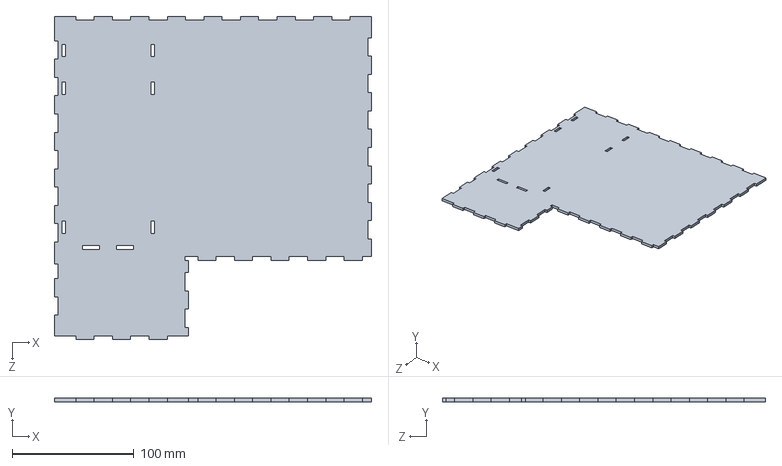
[picture p59: CAD file, 2018-04-15]
Base/Base12.SLDPRT
260.0 x 3.00 x 265.0 mm
