steveamena/ManteSistemas/Carga/Soportepiezas1.SLDPRT

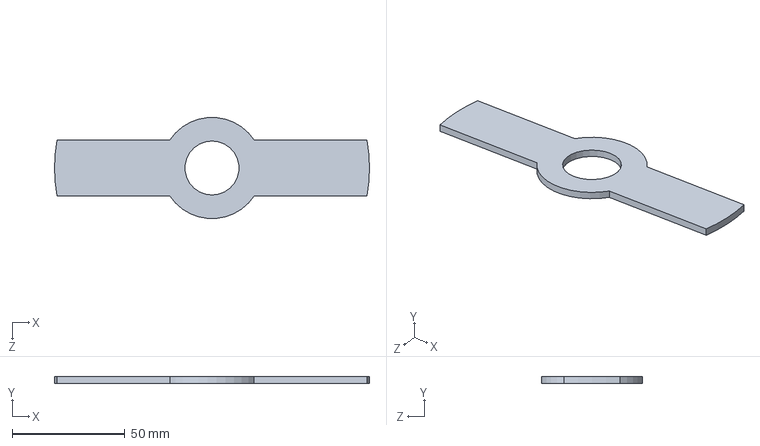
[picture p60: CAD file, 2018-06-08]
Carga/Soportepiezas1.SLDPRT
140.0 x 3.00 x 44.8 mm
