steveamena/ManteSistemas/Engrane1.SLDPRT

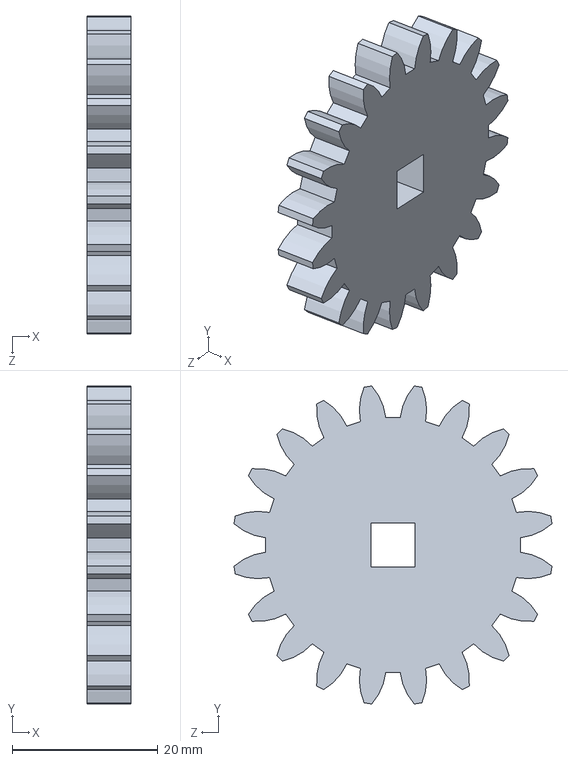
[picture p61: CAD file, 2018-04-15]
Engrane1.SLDPRT
6.00 x 43.6 x 43.6 mm
