steveamena/ManteSistemas/Acelerometro.SLDPRT

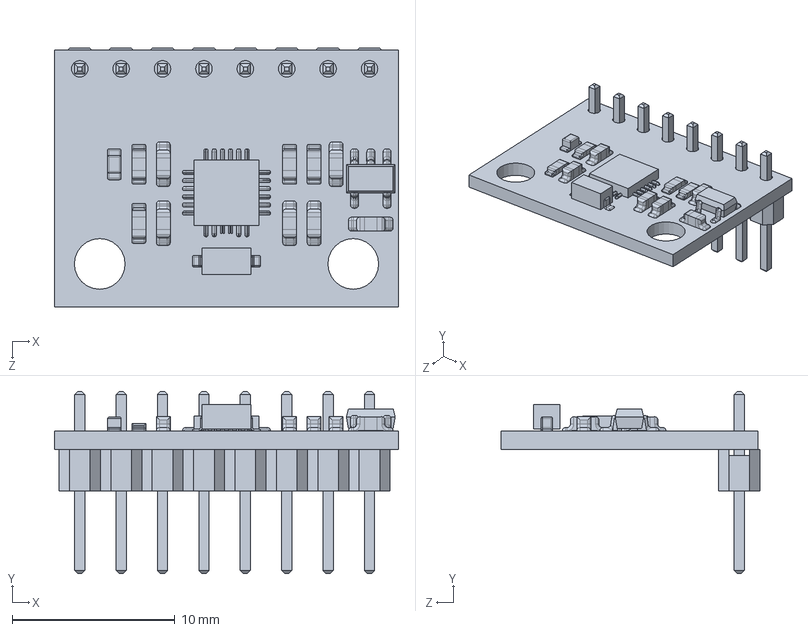
[picture p62: CAD file, 2018-04-15]
Acelerometro.SLDPRT
21.1 x 11.2 x 15.9 mm
