steveamena/ManteSistemas/Base/Base6.SLDPRT

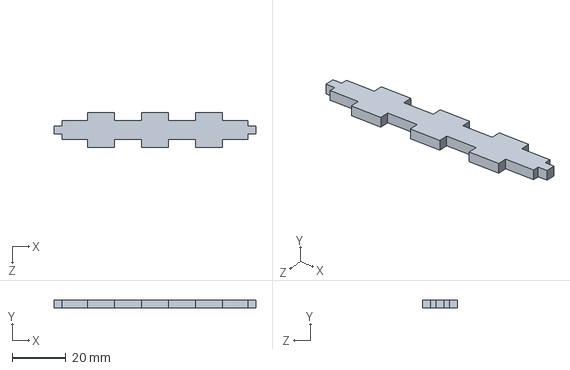
[picture p63: CAD file, 2018-04-15]
Base/Base6.SLDPRT
75.0 x 3.00 x 13.0 mm
