steveamena/ManteSistemas/Carga/Carga1_CAMBIOS2.SLDPRT

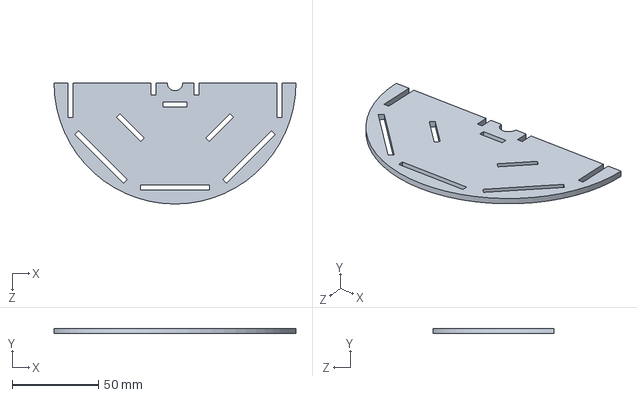
[picture p64: CAD file, 2018-06-08]
Carga/Carga1_CAMBIOS2.SLDPRT
140.0 x 3.00 x 70.0 mm
