steveamena/ManteSistemas/Base/Base3.SLDPRT

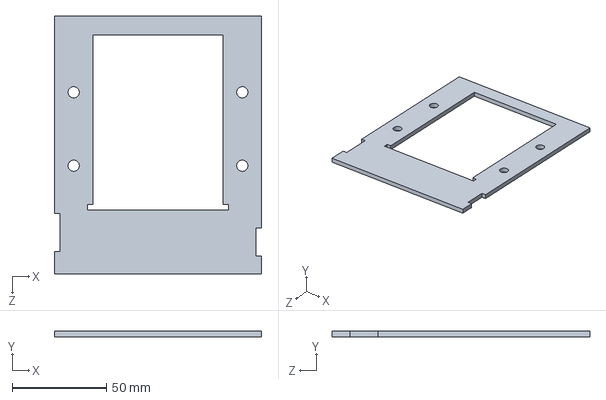
[picture p65: CAD file, 2018-04-15]
Base/Base3.SLDPRT
110.0 x 3.00 x 137.0 mm
