steveamena/ManteSistemas/Motor.SLDPRT

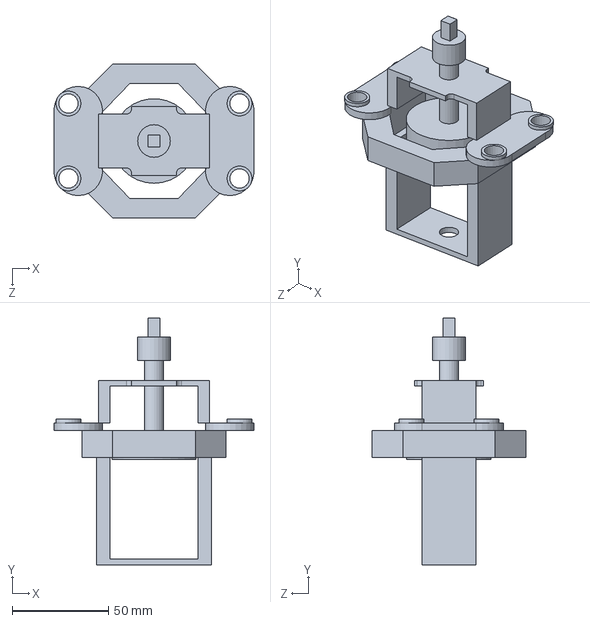
[picture p66: CAD file, 2018-04-15]
Motor.SLDPRT
104.0 x 128.5 x 80.0 mm
