steveamena/ManteSistemas/Base/Base2.SLDPRT

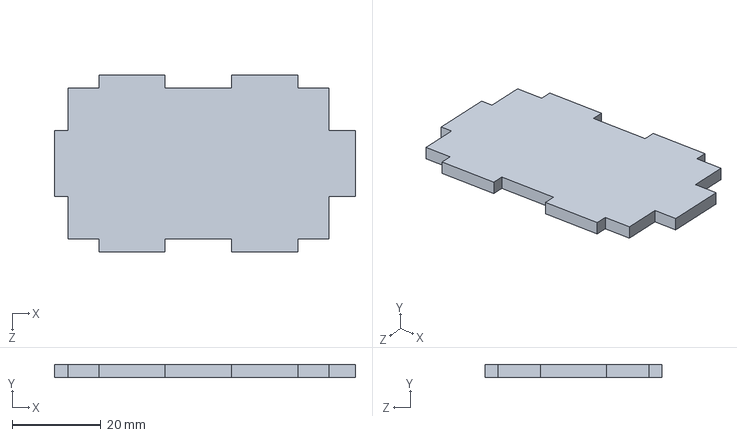
[picture p67: CAD file, 2018-04-15]
Base/Base2.SLDPRT
68.0 x 3.00 x 40.0 mm
