steveamena/ManteSistemas/Carga/Acelerometro_Sujecion.SLDPRT

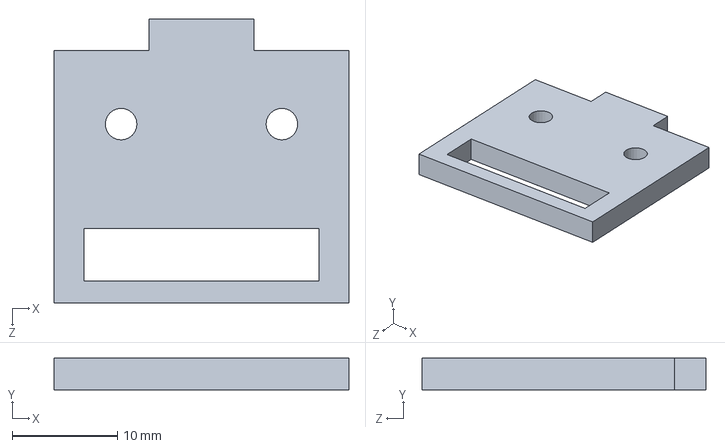
[picture p68: CAD file, 2018-06-08]
Carga/Acelerometro_Sujecion.SLDPRT
28.0 x 3.00 x 27.0 mm
