steveamena/ManteSistemas/Base.SLDPRT

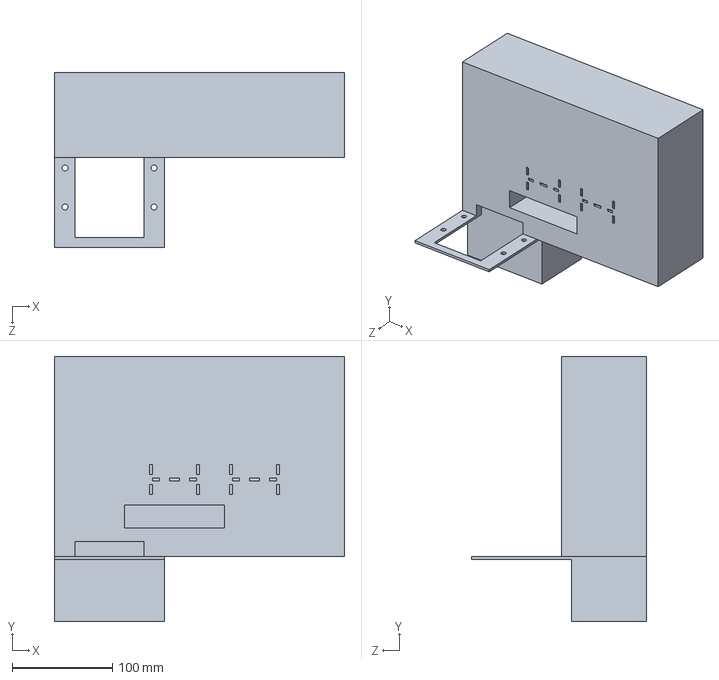
[picture p69: CAD file, 2018-04-15]
Base.SLDPRT
290.0 x 265.0 x 175.0 mm
