steveamena/ManteSistemas/Base/Bae5_2.SLDPRT

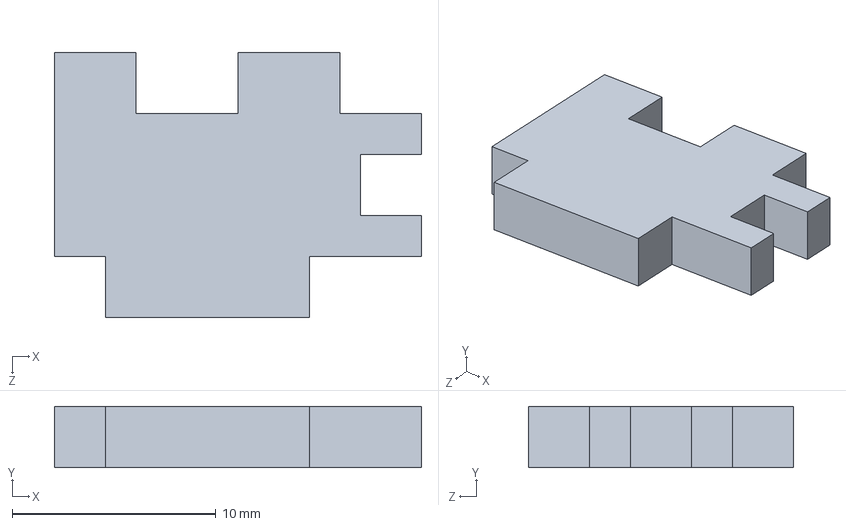
[picture p70: CAD file, 2018-04-15]
Base/Bae5_2.SLDPRT
18.0 x 3.00 x 13.0 mm
