steveamena/ManteSistemas/Anillo_Retencion.SLDPRT

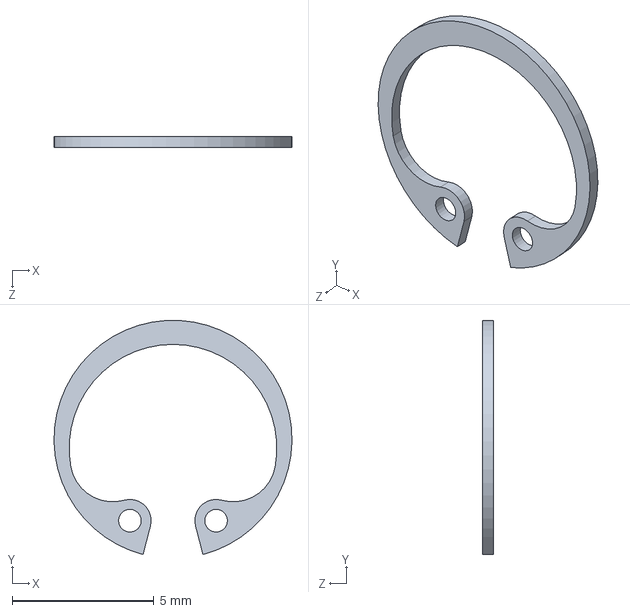
[picture p71: CAD file, 2018-04-02]
Anillo_Retencion.SLDPRT
8.40 x 8.26 x 0.4 mm
