steveamena/ManteSistemas/Base/Base1.SLDPRT

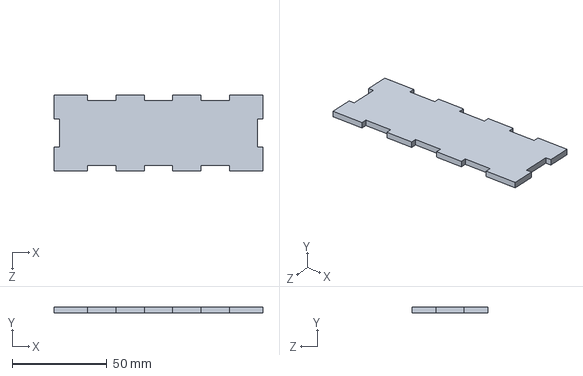
[picture p72: CAD file, 2018-04-15]
Base/Base1.SLDPRT
110.0 x 3.00 x 40.0 mm
