steveamena/ManteSistemas/Carga/Carga4.SLDPRT

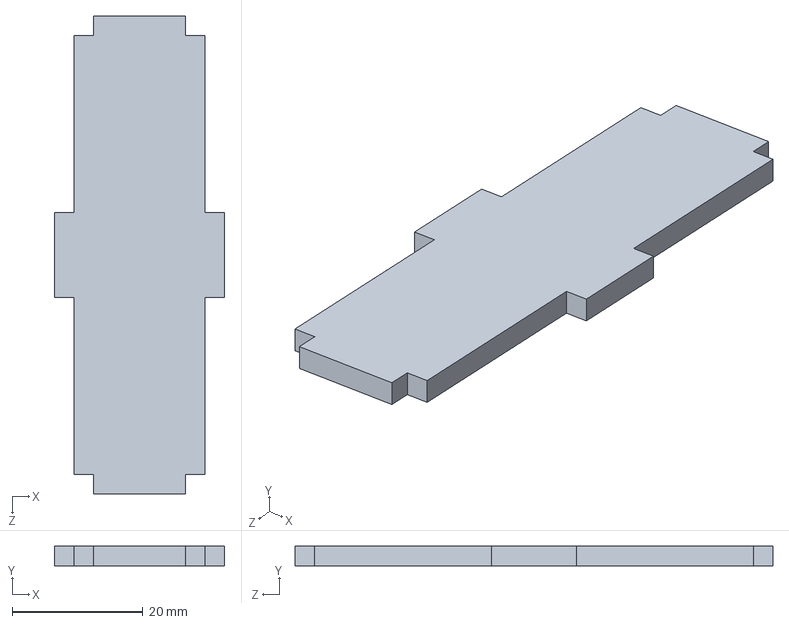
[picture p73: CAD file, 2018-06-08]
Carga/Carga4.SLDPRT
26.0 x 3.00 x 73.0 mm
