steveamena/ManteSistemas/Base/Base8.SLDPRT

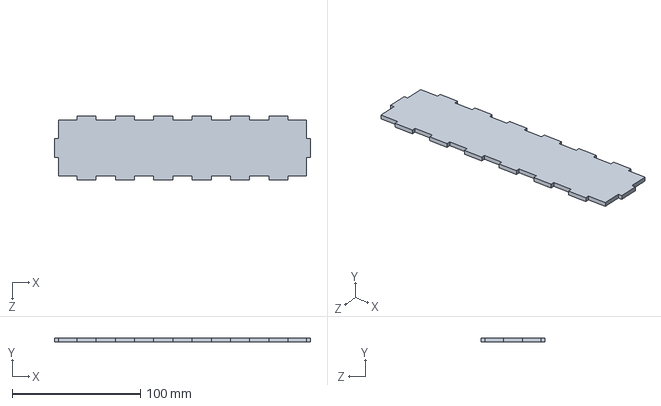
[picture p74: CAD file, 2018-04-15]
Base/Base8.SLDPRT
200.0 x 3.00 x 50.0 mm
