steveamena/ManteSistemas/Carga/Carga5.SLDPRT

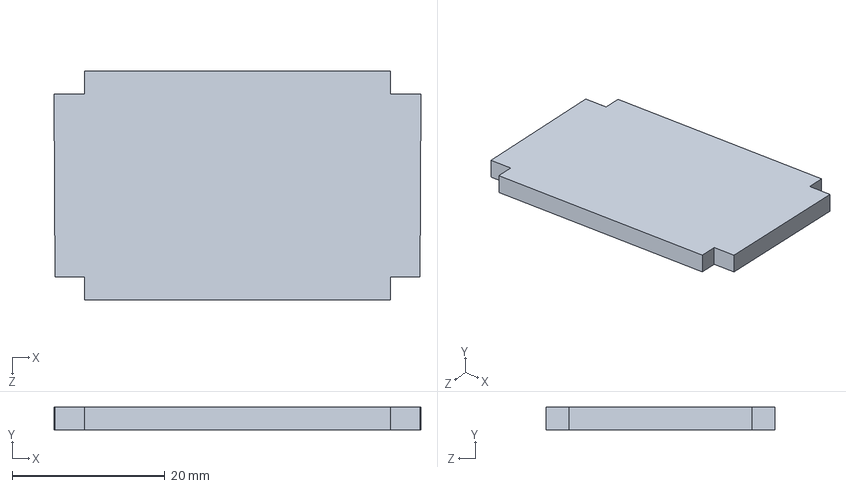
[picture p75: CAD file, 2018-06-08]
Carga/Carga5.SLDPRT
48.0 x 3.00 x 30.0 mm
