steveamena/ManteSistemas/Carga/Carga2.SLDPRT

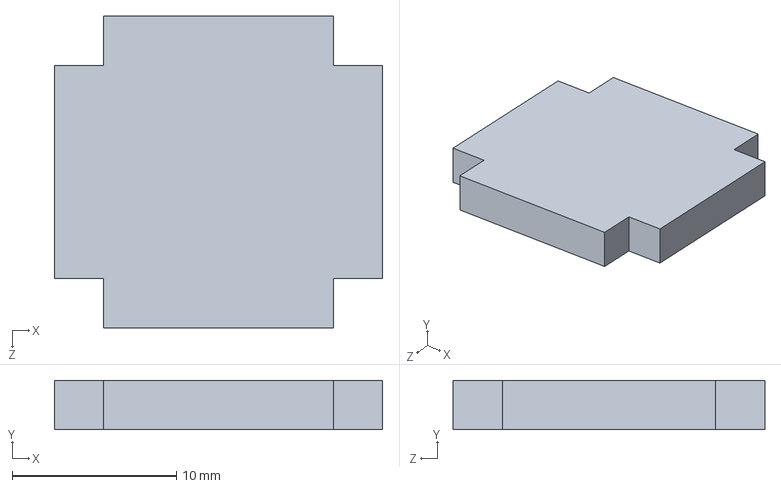
[picture p76: CAD file, 2018-06-08]
Carga/Carga2.SLDPRT
20.0 x 3.00 x 19.0 mm
