steveamena/ManteSistemas/Carga/Carga6_CAMBIO.SLDPRT

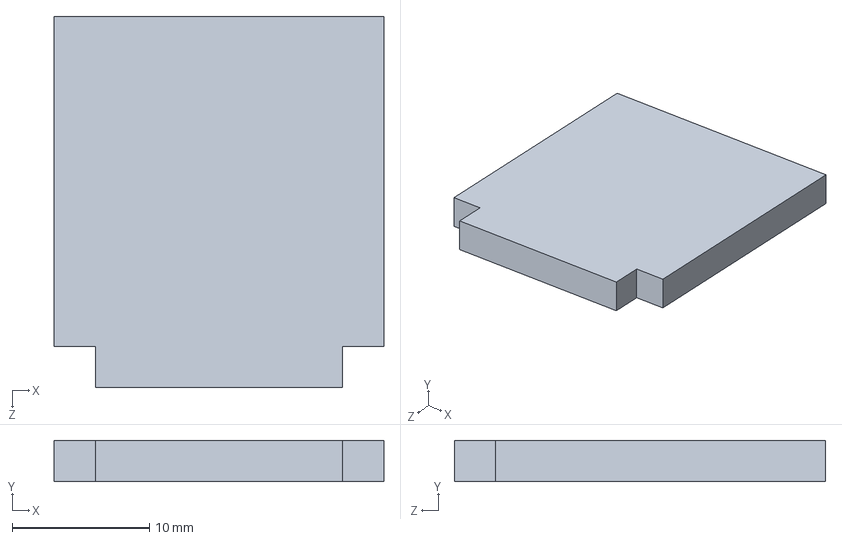
[picture p77: CAD file, 2018-05-24]
Carga/Carga6_CAMBIO.SLDPRT
24.0 x 3.00 x 27.0 mm
