steveamena/ManteSistemas/Carga/Carga1.SLDPRT

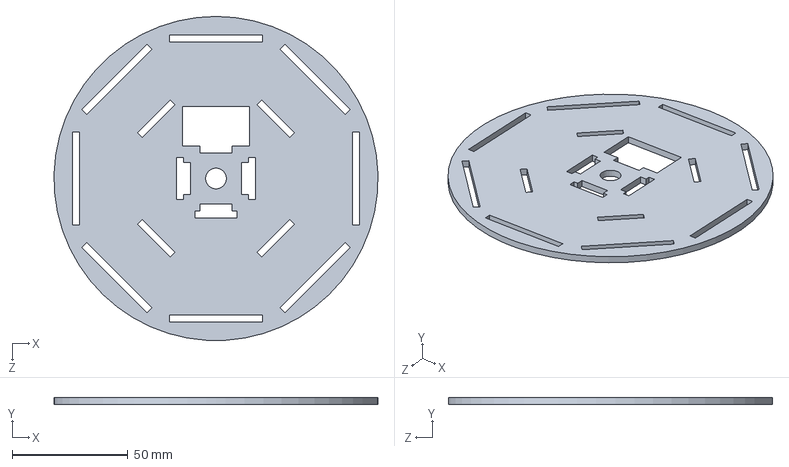
[picture p78: CAD file, 2018-04-15]
Carga/Carga1.SLDPRT
139.9 x 3.00 x 140.0 mm
