steveamena/ManteSistemas/(list of files, cad)

Other CAD files:
Engrane4_Carga.SLDPRT
Carga/Carga3_1_CAMBIOS.SLDPRT
Engrane2.SLDPRT
Engrane3y4.SLDPRT
Carga/Carga1_CAMBIOS1.SLDPRT
Carga/Carga3.SLDPRT
Carga/Carga3_1.SLDPRT
Base/BasePiezas01.SLDDRW
Base/BasePiezas02.SLDDRW
Planos de corte/CorteAcrilico3.SLDDRW
Planos de corte/CorteAcrilico5_5.SLDDRW
Planos de corte/CorteMDF3mm.SLDDRW
Planos de corte/CorteMDF3mmP1.SLDDRW
Planos de corte/CorteMDF3mmP2.SLDDRW
Planos de corte/CorteMDF3mmP3.SLDDRW
Planos de corte/CorteMDF3mm_Carga_01.SLDDRW
Planos de corte/CorteMDF3mm_Carga_02.SLDDRW
Planos de corte/Ejes_Maquinado.SLDDRW
Planos de corte/MDF3mm_Soporte_a_base.SLDDRW
Planos de corte/Planos_Corte_Nuevo.SLDDRW
Planos de corte/Soporte_Rol_Corte.SLDDRW
Planos normados/01_EspecificaciónTécnica.SLDDRW
Planos normados/04_PlanoConjuntoBase.SLDDRW
Planos normados/05_PlanoExplosionadoBase.SLDDRW
Planos normados/4_PlanoConjuntoCarga.SLDDRW
Soporte Rol/06_PlanoConjuntoSoporte_Rol.SLDDRW
Soporte Rol/07_PlanoExplosionadoSoporte_Rol.SLDDRW
