steveamena/ManteSistemas/Experimentos/Tedencia de velocidades.xlsx

Velocidad | 2946 | 2724 | 17038 | 39226 | 43097
Velocidad carga | 1309.333333 | 1210.666667 | 7572.444444 | 17433.77778 | 19154.22222
Amplitud | 1.51 | 1.03 | 5.99 | 2.42 | 5.88
