steveamena/ManteSistemas/Experimentos/Medición de las velocidades.xlsx

Medición de las velocidades
No | Velocidad sin carga | Velocidad con carga | Velocidad 2 | Velocidad 3 | Velocidad 4
1 | 2946 | 2724 | 17038 | 39226 | 43097
2
3
4
5
6
7
8
9
10
