steveamena/ManteSistemas/Experimentos/Experimento lab procesos 4-06-2018/Datos recolectados/Experimento 11.txt

-0.01
-0.00
-0.01
-0.01
-0.00
-0.00
-0.01
-0.01
-0.01
-0.00
-0.00
-0.00
-0.00
-0.00
-0.00
-0.01
-0.01
-0.01
-0.01
-0.00
-0.01
-0.00
-0.00
-0.00
-0.01
-0.00
-0.00
-0.01
-0.00
-0.00
-0.00
-0.00
-0.00
-0.01
-0.01
-0.00
-0.00
-0.01
-0.01
-0.01
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
