steveamena/ManteSistemas/Experimentos/Medición de las masas.xlsx

Medición de las masas | Se midió una masa y se multiplicó por 15
No | Masa | Incertidumbre en la medición
1 | 28.2 | 0.01
2 | 28.2
3 | 28.18
4 | 28.23
5 | 27.94
6 | 28.16
7 | 27.99
8 | 28.21
9 | 28.19
10 | 28.2
Bolsa | 1.46
