steveamena/ManteSistemas/Experimentos/Experimento 3/1 Vel Carga.xlsx

Sheet: sheet1
Cuenta | Tiempo | Untitled
0 | 0 | -11
1 | 0.001 | -11
2 | 0.002 | -11
3 | 0.003 | -11
4 | 0.004 | -11
5 | 0.005 | -11
6 | 0.006 | -11
7 | 0.007 | -0.03
8 | 0.008 | -11
9 | 0.009 | -11
10 | 0.01 | -11
11 | 0.011 | -11
12 | 0.012 | -11
13 | 0.013 | -11
14 | 0.014 | -11
15 | 0.015 | -0.03
16 | 0.016 | -11
17 | 0.017 | -11
18 | 0.018 | -11
19 | 0.019 | -11
20 | 0.02 | -11
21 | 0.021 | -11
22 | 0.022 | -11
23 | 0.023 | -0.03
24 | 0.024 | -11
25 | 0.025 | -11
26 | 0.026 | -11
27 | 0.027 | -11
28 | 0.028 | -11
29 | 0.029 | -11
30 | 0.03 | -11
31 | 0.031 | -0.03
32 | 0.032 | -11
33 | 0.033 | -11
34 | 0.034 | -11
35 | 0.035 | -11
36 | 0.036 | -11
37 | 0.037 | -11
38 | 0.038 | -11
39 | 0.039 | -0.03
40 | 0.04 | -11
41 | 0.041 | -11
42 | 0.042 | -11
43 | 0.043 | -11
44 | 0.044 | -11
45 | 0.045 | -11
46 | 0.046 | -11
47 | 0.047 | -0.03
48 | 0.048 | -11
49 | 0.049 | -11
50 | 0.05 | -11
51 | 0.051 | -11
52 | 0.052 | -11
53 | 0.053 | -0.03
54 | 0.054 | -11
55 | 0.055 | -11
56 | 0.056 | -11
57 | 0.057 | -11
58 | 0.058 | -11
59 | 0.059 | -11
60 | 0.06 | -0.03
61 | 0.061 | -11
62 | 0.062 | -11
63 | 0.063 | -11
64 | 0.064 | -11
65 | 0.065 | -0.03
66 | 0.066 | -11
67 | 0.067 | -11
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
