steveamena/ManteSistemas/Experimentos/Experimento 1/4 Velocidad Sin Carga.xlsx

Untitled
-11
-11
-11
-11
-11
-11
-11
-0.03
-11
-11
-11
-11
-11
-11
-11
-0.03
-11
-11
-11
-11
-11
-11
-11
-0.03
-11
-11
-11
-11
-11
-11
-11
-0.03
-11
-11
-11
-11
-11
-11
-11
-0.02
-11
-11
-11
-11
-11
-11
-11
-0.03
-11
-11
-11
-11
-11
-11
-11
-0.03
-11
-11
-11
-11
-11
-11
-11
-0.03
-11
-11
-11
-11
-11
-11
-11
-0.03
-11
-11
-11
-11
-11
-11
-11
-0.03
-11
-11
-11
-11
-11
-11
-11
-0.03
-11
-11
-11
-11
-11
-11
-11
-0.03
-11
-11
-11
-11
-11
-11
-11
-0.03
-11
-11
-11
-11
-11
-11
-11
-0.03
-11
-11
-11
-11
-11
-11
-11
-0.03
-11
-11
-11
-11
-11
-11
-11
-0.03
-11
-11
-11
-11
-11
-11
-0.04
-11
-11
-11
-11
-11
-11
-11
-0.04
-11
-11
-11
-11
-11
-11
-11
-0.04
-11
-11
-11
-11
-11
-11
-11
-0.03
-11
-11
-11
-11
-11
-11
-11
-0.04
-11
-11
-11
-11
-11
-11
-11
-0.03
-11
-11
-11
-11
-11
-11
-11
-0.03
-11
-11
-11
-11
-11
-11
-11
-0.03
-11
-11
-11
-11
-11
-11
-11
-0.02
-11
-11
-11
-11
-11
-11
-11
-0.03
-11
-11
-11
-11
-11
-11
-11
-0.03
-11
-11
-11
-11
-11
-11
-11
-0.03
-11
-11
-11
-11
-11
-11
-11
-0.03
-11
-11
-11
-11
-11
-11
-11
-0.03
-11
-11
-11
-11
-11
-11
-11
-0.03
-11
-11
-11
-11
-11
-11
-11
-0.03
-11
-11
-11
-11
-11
-11
-11
-0.03
-11
-11
-11
-11
-11
-11
-11
-0.03
-11
-11
-11
-11
-11
-11
-11
-0.04
-11
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
