steveamena/ManteSistemas/Experimentos/Experimento 1/Primera Corrida programa de Mante.xlsx

Segundos - Plot 0 | Acceleración (g) - Plot 0
70.002 | 0.17
70.012 | 0.1
70.022 | 0.43
70.031 | 0.21
70.044 | -0.53
70.057 | 0.02
70.069 | 0.27
70.081 | -0.13
70.094 | -0.73
70.105 | -0.3
70.118 | -0.3
70.129 | -0.19
70.14 | -0.31
70.153 | 0.26
70.165 | 0.22
70.177 | 0.12
70.188 | -0.72
70.202 | 0.81
70.211 | -0.61
70.221 | 0.25
70.231 | 0.08
70.242 | -0.12
70.256 | -0.08
70.269 | 0.18
70.28 | -0.29
70.292 | -0.58
70.304 | -0.14
70.314 | 0.11
70.328 | -0.72
70.34 | 0.54
70.353 | 0.02
70.365 | 0.12
70.375 | -0.39
70.384 | 0.23
70.392 | 0.16
70.404 | 0.21
70.414 | -0.69
70.427 | -0.65
70.438 | -0.15
70.448 | -0.07
70.462 | -0.94
70.474 | 0.3
70.486 | 0.08
70.497 | -0.08
70.51 | -0.14
70.521 | -0.45
70.533 | 0.35
70.545 | 0.05
70.556 | 0.3
70.567 | 0.02
70.579 | -0.11
70.591 | 0.77
70.603 | 0.09
70.615 | -0.17
70.626 | -0.07
70.637 | 0.07
70.65 | -1.18
70.663 | -0.76
70.674 | 0.52
70.685 | -0.07
70.697 | -0.17
70.71 | -0.12
70.723 | 0.14
70.735 | 0.28
70.747 | 0
70.761 | 0.36
70.774 | 0.49
70.785 | 0.5
70.797 | -0.15
70.809 | -0.66
70.819 | 0.32
70.832 | 0.14
70.844 | -0.83
70.857 | 0.11
70.87 | 0.48
70.884 | 0.5
70.897 | -0.48
70.91 | -0.4
70.921 | -0.52
70.931 | -0.14
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
