steveamena/ManteSistemas/Experimentos/Experimento 1/Segunda Velocidad sin Carga.xlsx

Untitled
-11
-11
-11
-11
-11
-11
-11
-11
-0.03
-11
-11
-11
-11
-11
-11
-11
-0.03
-11
-11
-11
-11
-11
-11
-11
-0.03
-11
-11
-11
-11
-11
-11
-11
-0.03
-11
-11
-11
-11
-11
-11
-11
-0.03
-11
-11
-11
-11
-11
-11
-11
-0.04
-11
-11
-11
-11
-11
-11
-11
-0.04
-11
-11
-11
-11
-11
-11
-11
-0.03
-11
-11
-11
-11
-11
-11
-11
-0.04
-11
-11
-11
-11
-11
-11
-11
-0.03
-11
-11
-11
-11
-11
-11
-11
-0.04
-11
-11
-11
-11
-11
-11
-11
-0.03
-11
-11
-11
-11
-11
-11
-11
-0.04
-11
-11
-11
-11
-11
-11
-11
-0.04
-11
-11
-11
-11
-11
-11
-11
-0.03
-11
-11
-11
-11
-11
-11
-11
-0.04
-11
-11
-11
-11
-11
-11
-11
-0.03
-11
-11
-11
-11
-11
-11
-11
-0.03
-11
-11
-11
-11
-11
-11
-11
-0.03
-11
-11
-11
-11
-11
-11
-11
-0.04
-11
-11
-11
-11
-11
-11
-11
-0.03
-11
-11
-11
-11
-11
-11
-11
-0.03
-11
-11
-11
-11
-11
-11
-0.03
-11
-11
-11
-11
-11
-11
-11
-0.03
-11
-11
-11
-11
-11
-11
-11
-0.03
-11
-11
-11
-11
-11
-11
-11
-0.03
-11
-11
-11
-11
-11
-11
-11
-0.03
-11
-11
-11
-11
-11
-11
-11
-0.04
-11
-11
-11
-11
-11
-11
-11
-0.04
-11
-11
-11
-11
-11
-11
-11
-0.03
-11
-11
-11
-11
-11
-11
-11
-0.03
-11
-11
-11
-11
-11
-11
-11
-0.04
-11
-11
-11
-11
-11
-11
-11
-0.03
-11
-11
-11
-11
-11
-11
-11
-0.03
-11
-11
-11
-11
-11
-11
-11
-0.03
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
