steveamena/ManteSistemas/Experimentos/Experimento 2/1 Vel Sin Carga.xlsx

Untitled
-11
-11
-11
-11
-11
-11
-11
0
-11
-11
-11
-11
-11
-11
-11
0
-11
-11
-11
-11
-11
-11
0
-11
-11
-11
-11
-11
-11
-11
0
-11
-11
-11
-11
-11
-11
-11
0
-11
-11
-11
-11
-11
-11
-11
0
-11
-11
-11
-11
-11
-11
-11
0
-11
-11
-11
-11
-11
-11
-11
0
-11
-11
-11
-11
-11
0
-11
-11
-11
-11
-11
-11
-11
0
-11
-11
-11
-11
-11
-11
0
-11
-11
-11
-11
-11
-11
-11
0
-11
-11
-11
-11
-11
-11
-11
0
-11
-11
-11
-11
-11
0
-11
-11
-11
-11
-11
-11
-11
0
-11
-11
-11
-11
-11
-11
-11
0
-11
-11
-11
-11
-11
-11
0
-11
-11
-11
-11
-11
-11
-11
0
-11
-11
-11
-11
-11
-11
-11
0
-11
-11
-11
-11
-11
-11
-11
0
-11
-11
-11
-11
-11
0
-11
-11
-11
-11
-11
-11
0
-11
-11
-11
-11
-11
-11
-11
0
-11
-11
-11
-11
-11
-11
-11
0
-11
-11
-11
-11
-11
-11
0
-11
-11
-11
-11
-11
-11
0
-11
-11
-11
-11
-11
-11
0
-11
-11
-11
-11
-11
-11
0
-11
-11
-11
-11
-11
-11
0
-11
-11
-11
-11
-11
0
-11
-11
-11
-11
-11
-11
-11
0
-11
-11
-11
-11
-11
-11
-11
0
-11
-11
-11
-11
-11
-11
-11
0
-11
-11
-11
-11
-11
-11
-11
0
-11
-11
-11
-11
-11
-11
0
-11
-11
-11
-11
-11
-11
-11
0
-11
-11
-11
-11
-11
-11
0
-11
-11
-11
-11
-11
0
-11
-11
-11
-11
-11
0
-11
-11
-11
-11
-11
-11
-11
0
-11
-11
-11
-11
-11
-11
-11
0
-11
-11
-11
-11
-11
-11
0
-11
-11
-11
-11
-11
0
-11
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
