steveamena/ManteSistemas/Experimentos/Experimento 3/5 Vel Carga.xlsx

Untitled
-11
-11
-11
-11
-11
-11
-11
-11
-0.01
-11
-11
-11
-11
-11
-11
-11
-0.02
-11
-11
-11
-11
-11
-0.02
-11
-11
-11
-11
-11
-0.02
-11
-11
-11
-11
-11
-11
-11
-0.02
-11
-11
-11
-11
-11
-11
-11
-0.01
-11
-11
-11
-11
-11
-11
-0.02
-11
-11
-11
-11
-11
-0.02
-11
-11
-11
-11
-11
-11
-0.02
-11
-11
-11
-11
-11
-11
-11
-0.02
-11
-11
-11
-11
-11
-11
-0.02
-11
-11
-11
-11
-11
-0.02
-11
-11
-11
-11
-11
-0.02
-11
-11
-11
-11
-11
-11
-0.02
-11
-11
-11
-11
-11
-11
-0.02
-11
-11
-11
-11
-11
-11
-0.02
-11
-11
-11
-11
-11
-11
-11
-0.02
-11
-11
-11
-11
-11
-0.02
-11
-11
-11
-11
-11
-0.02
-11
-11
-11
-11
-11
-11
-11
-0.01
-11
-11
-11
-11
-11
-11
-0.01
-11
-11
-11
-11
-11
-0.02
-11
-11
-11
-11
-11
-11
-0.01
-11
-11
-11
-11
-11
-11
-11
-0.02
-11
-11
-11
-11
-11
-0.02
-11
-11
-11
-11
-11
-11
-0.02
-11
-11
-11
-11
-11
-0.02
-11
-11
-11
-11
-11
-11
-11
-0.02
-11
-11
-11
-11
-11
-11
-0.02
-11
-11
-11
-11
-11
-11
-0.01
-11
-11
-11
-11
-11
-11
-0.01
-11
-11
-11
-11
-11
-11
-11
-0.02
-11
-11
-11
-11
-11
-11
-11
-0.02
-11
-11
-11
-11
-11
-11
-0.02
-11
-11
-11
-11
-11
-11
-0.02
-11
-11
-11
-11
-11
-11
-11
-0.01
-11
-11
-11
-11
-11
-11
-0.01
-11
-11
-11
-11
-11
-11
-0.01
-11
-11
-11
-11
-11
-11
-0.02
-11
-11
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
