steveamena/ManteSistemas/Experimentos/Experimento lab procesos 4-06-2018/Datos recolectados/Resultados_Soltura.png

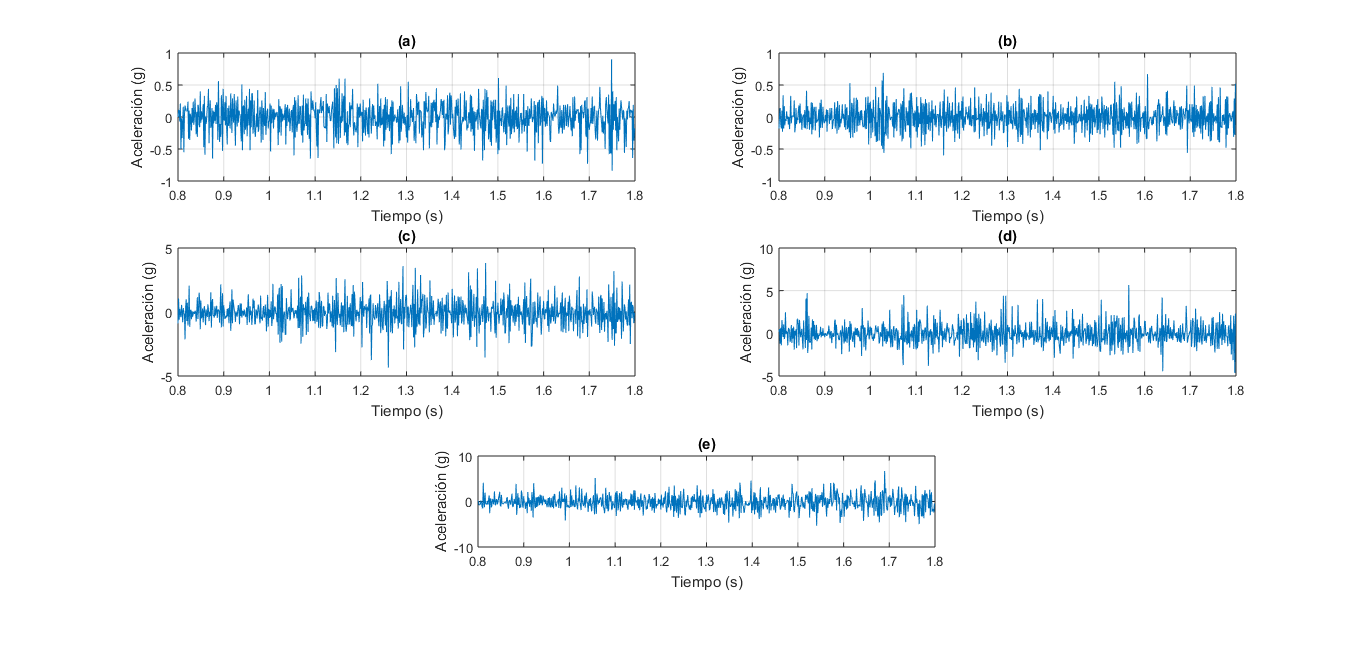
Experimentos/Experimento lab procesos 4-06-2018/Datos recolectados/Resultados_Soltura.png
