steveamena/ManteSistemas/Planos normados/04_PlanoConjuntoBase.PDF

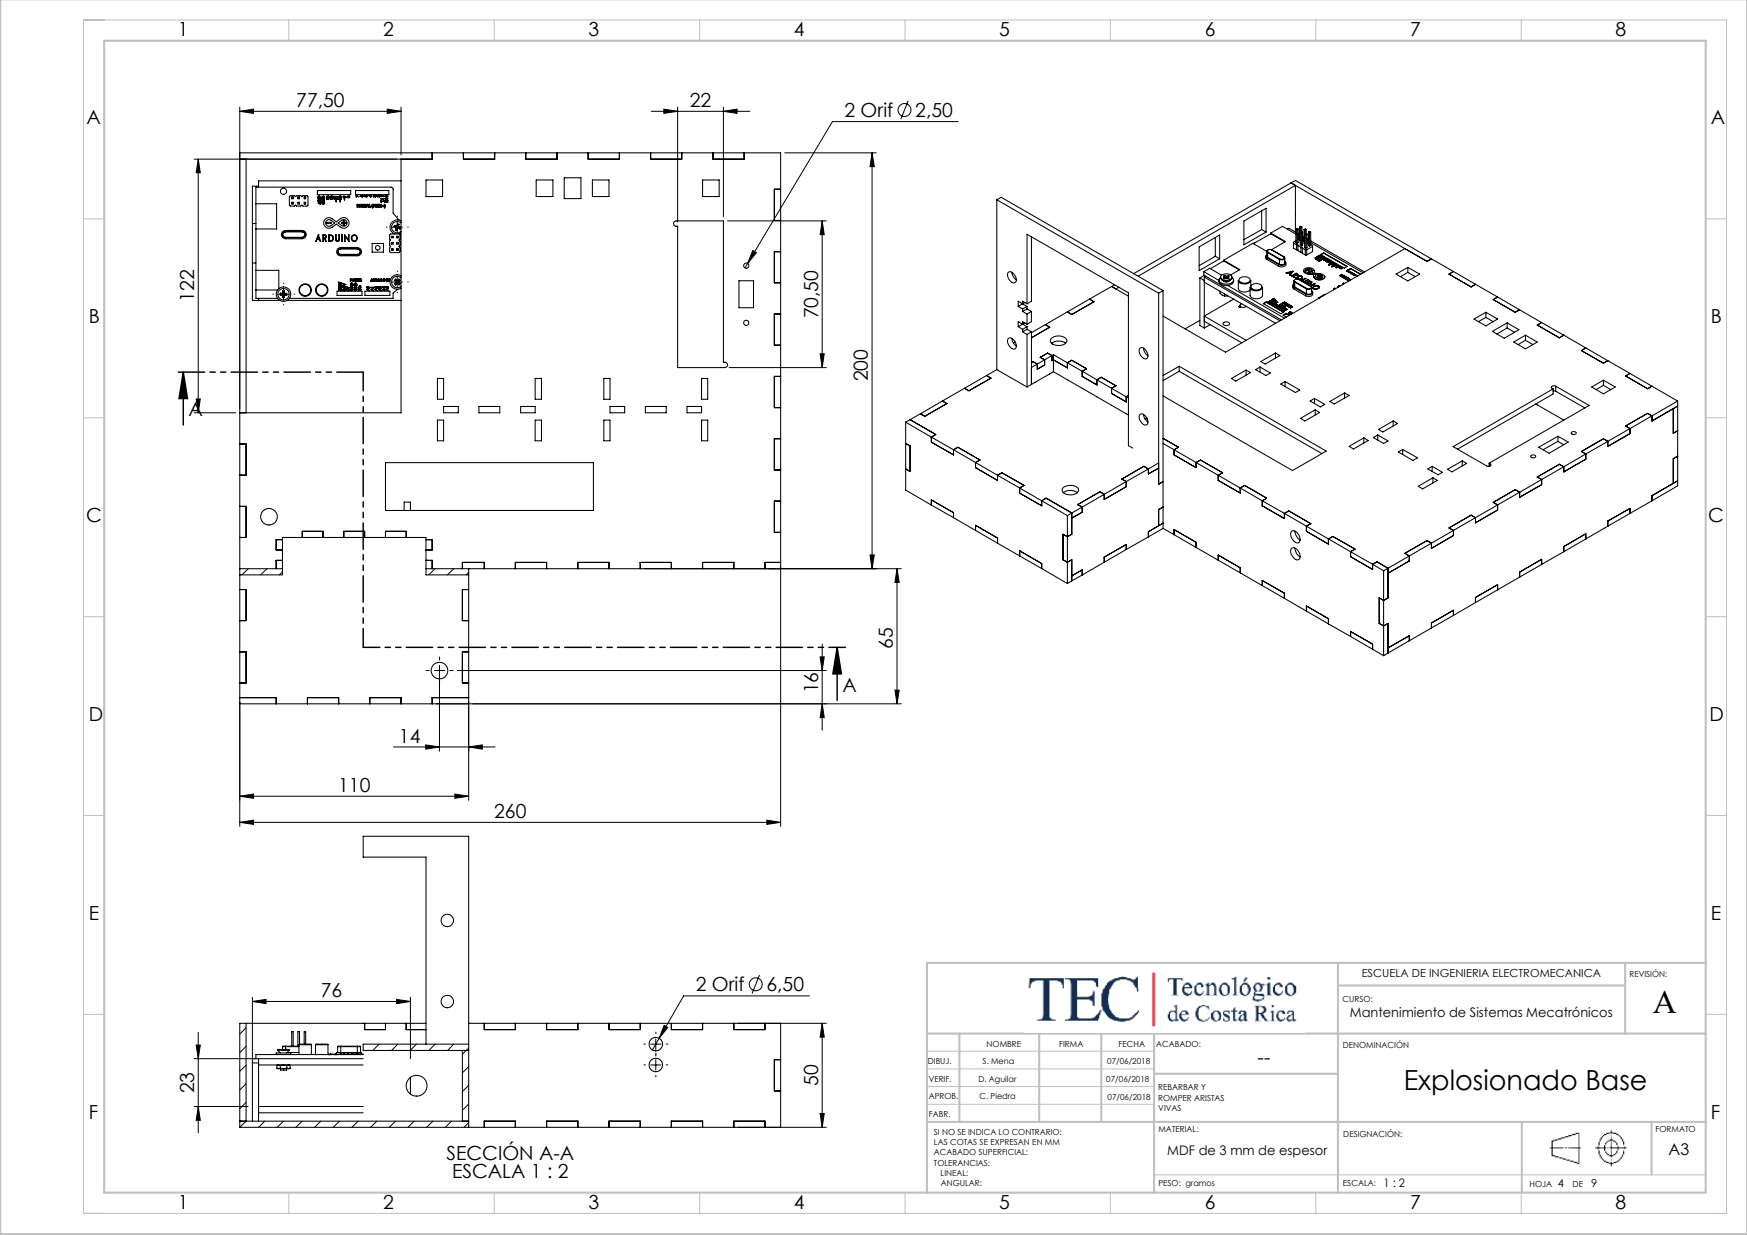
[picture p81: page 1]
2 Orif 2,50; 2 Orif 6,50 76; SECCIÓN A-A ESCALA 1 : 2; REBARBAR Y ROMPER ARISTAS

ESCUELA DE INGENIERIA ELECTROMECANICA
Mantenimiento de Sistemas Mecatrónicos

NOMBRE | FIRMA | FECHA | ACABADO: -- | DENOMINACIÓN Explosionado Base

DIBUJ. | S. Mena | | 07/06/2018
VERIF. | D. Aguilar | | 07/06/2018
APROB. | C. Piedra | | 07/06/2018
FABR.
SI NO SE INDICA LO CONTRARIO: LAS COTAS SE EXPRESAN EN MM ACABADO SUPERFICIAL: TOLERANCIAS: LINEAL: ANGULAR: | MATERIAL: MDF de 3 mm de espesor | | | FORMATO DESIGNACIÓN: A3

PESO: gramos | 1 : 2 ESCALA: | 4 9 HOJA DE
