steveamena/ManteSistemas/Planos normados/06_PlanoConjuntoSoporte_Rol.PDF

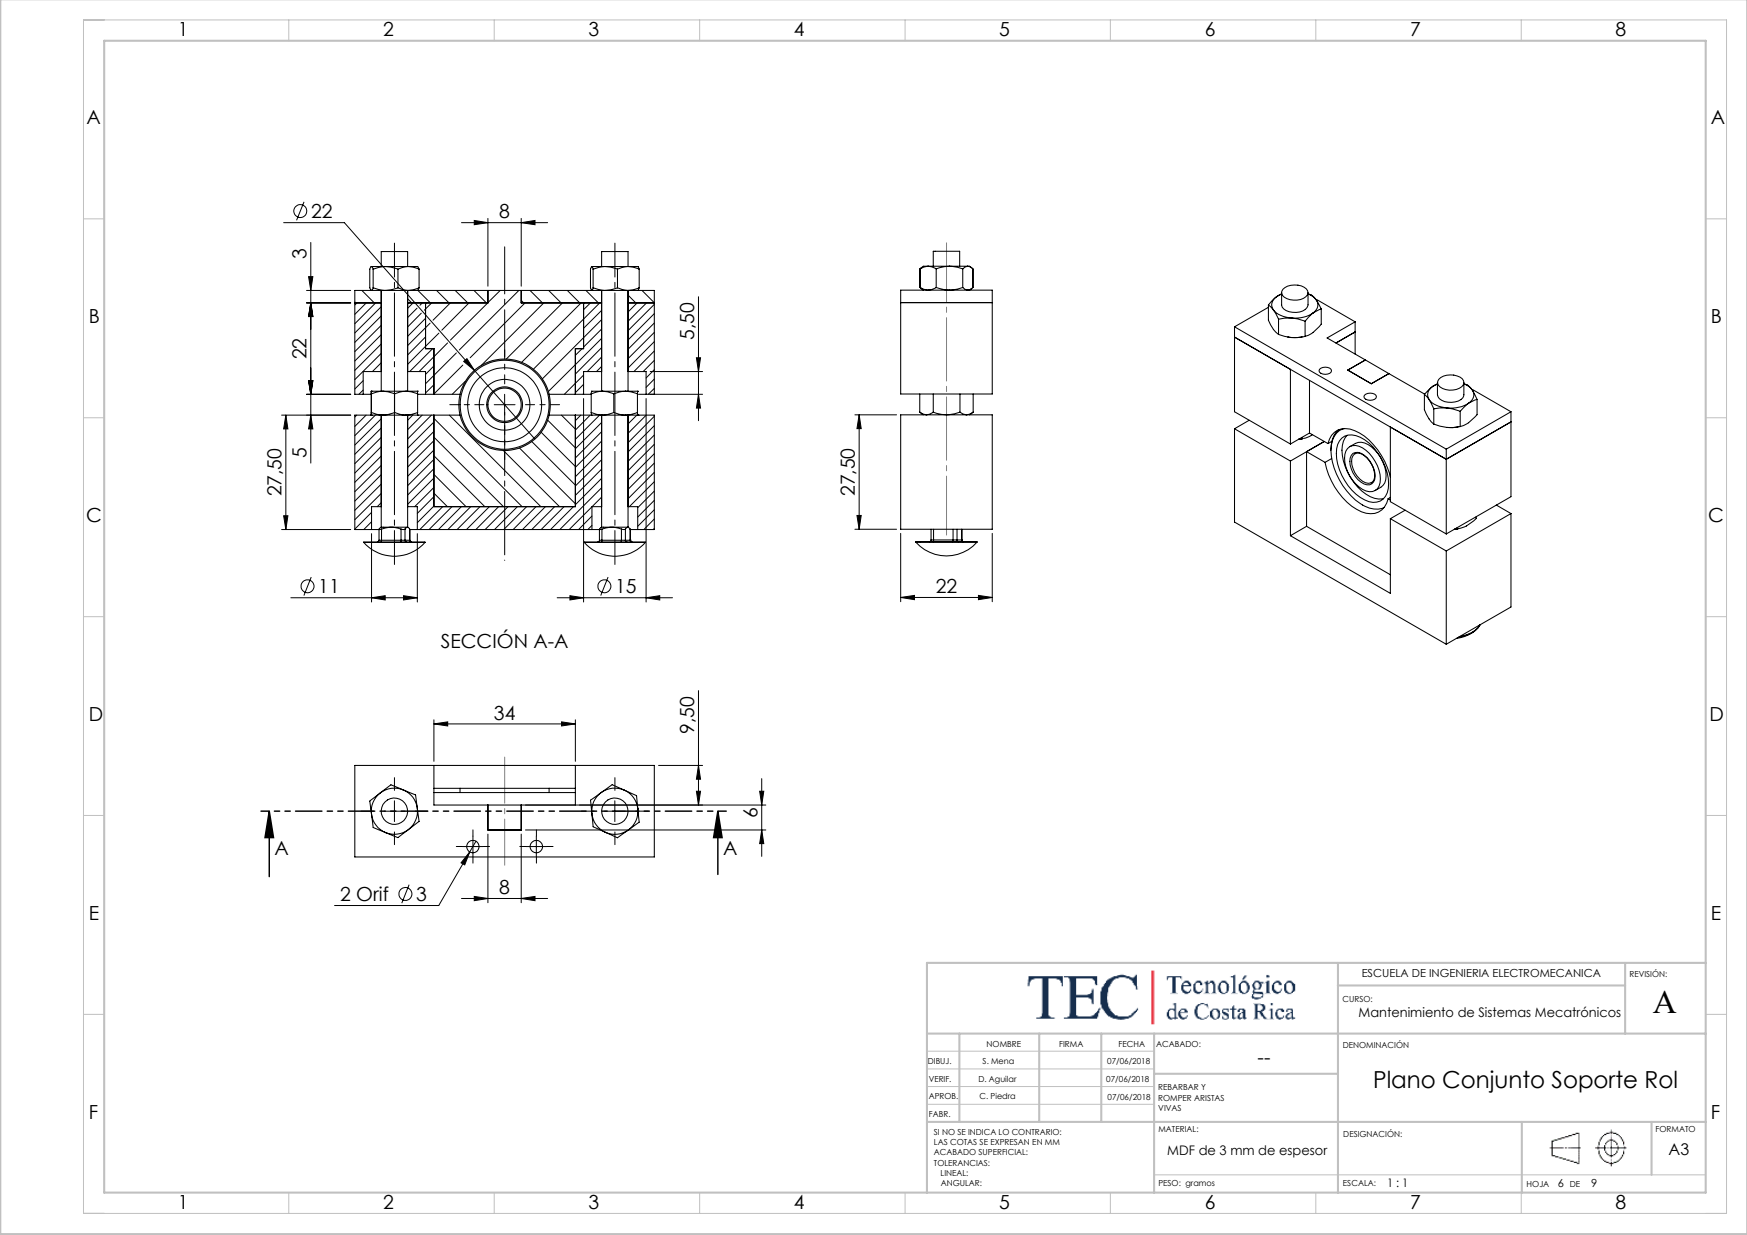
[picture p82: page 1]
2 Orif 3; SECCIÓN A-A; REBARBAR Y ROMPER ARISTAS

ESCUELA DE INGENIERIA ELECTROMECANICA
Mantenimiento de Sistemas Mecatrónicos

NOMBRE | FIRMA | FECHA | ACABADO: -- | DENOMINACIÓN Plano Conjunto Soporte Rol

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

PESO: gramos | 1 : 1 ESCALA: | HOJA 6 DE 9
