steveamena/ManteSistemas/Planos normados/07_PlanoExplosionadoSoporte_Rol.PDF

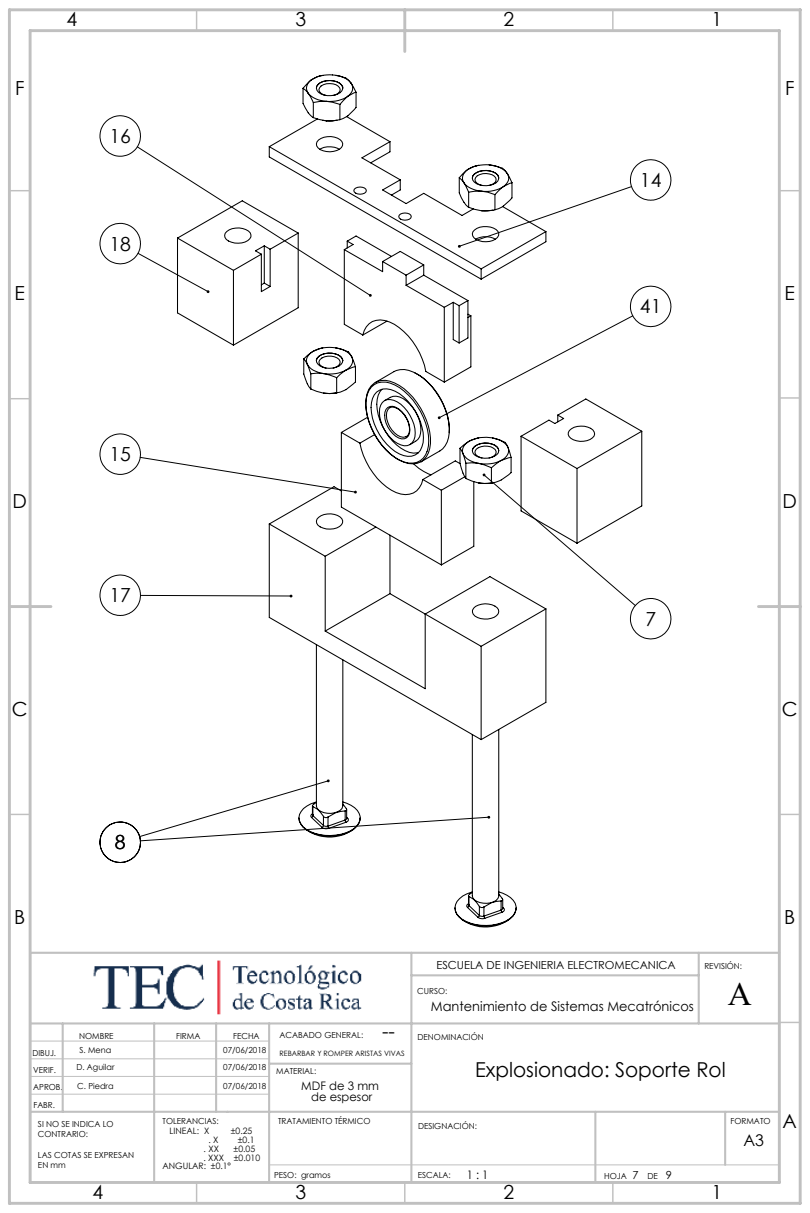
[picture p83: page 1]

ESCUELA DE INGENIERIA ELECTROMECANICA
Mantenimiento de Sistemas Mecatrónicos

NOMBRE | FIRMA | FECHA | --ACABADO GENERAL: REBARBAR Y ROMPER ARISTAS VIVAS | DENOMINACIÓN

DIBUJ. | S. Mena | | 07/06/2018
VERIF. | D. Aguilar
APROB. | C. Piedra | | 07/06/2018
FABR.
SI NO SE INDICA LO CONTRARIO: LAS COTAS SE EXPRESAN EN mm | TOLERANCIAS: LINEAL: X ±0.25 . X ±0.1 . XX ±0.05 . XXX ±0.010 ANGULAR: ±0.1° | TRATAMIENTO TÉRMICO | DESIGNACIÓN: | | FORMATO A3

Explosionado: Soporte Rol 07/06/2018

MATERIAL:
MDF de 3 mm
de espesor

PESO: gramos | ESCALA: 1 : 1 | HOJA 7 DE 9
