steveamena/ManteSistemas/Planos normados/08_PlanoConjuntoCarga.PDF

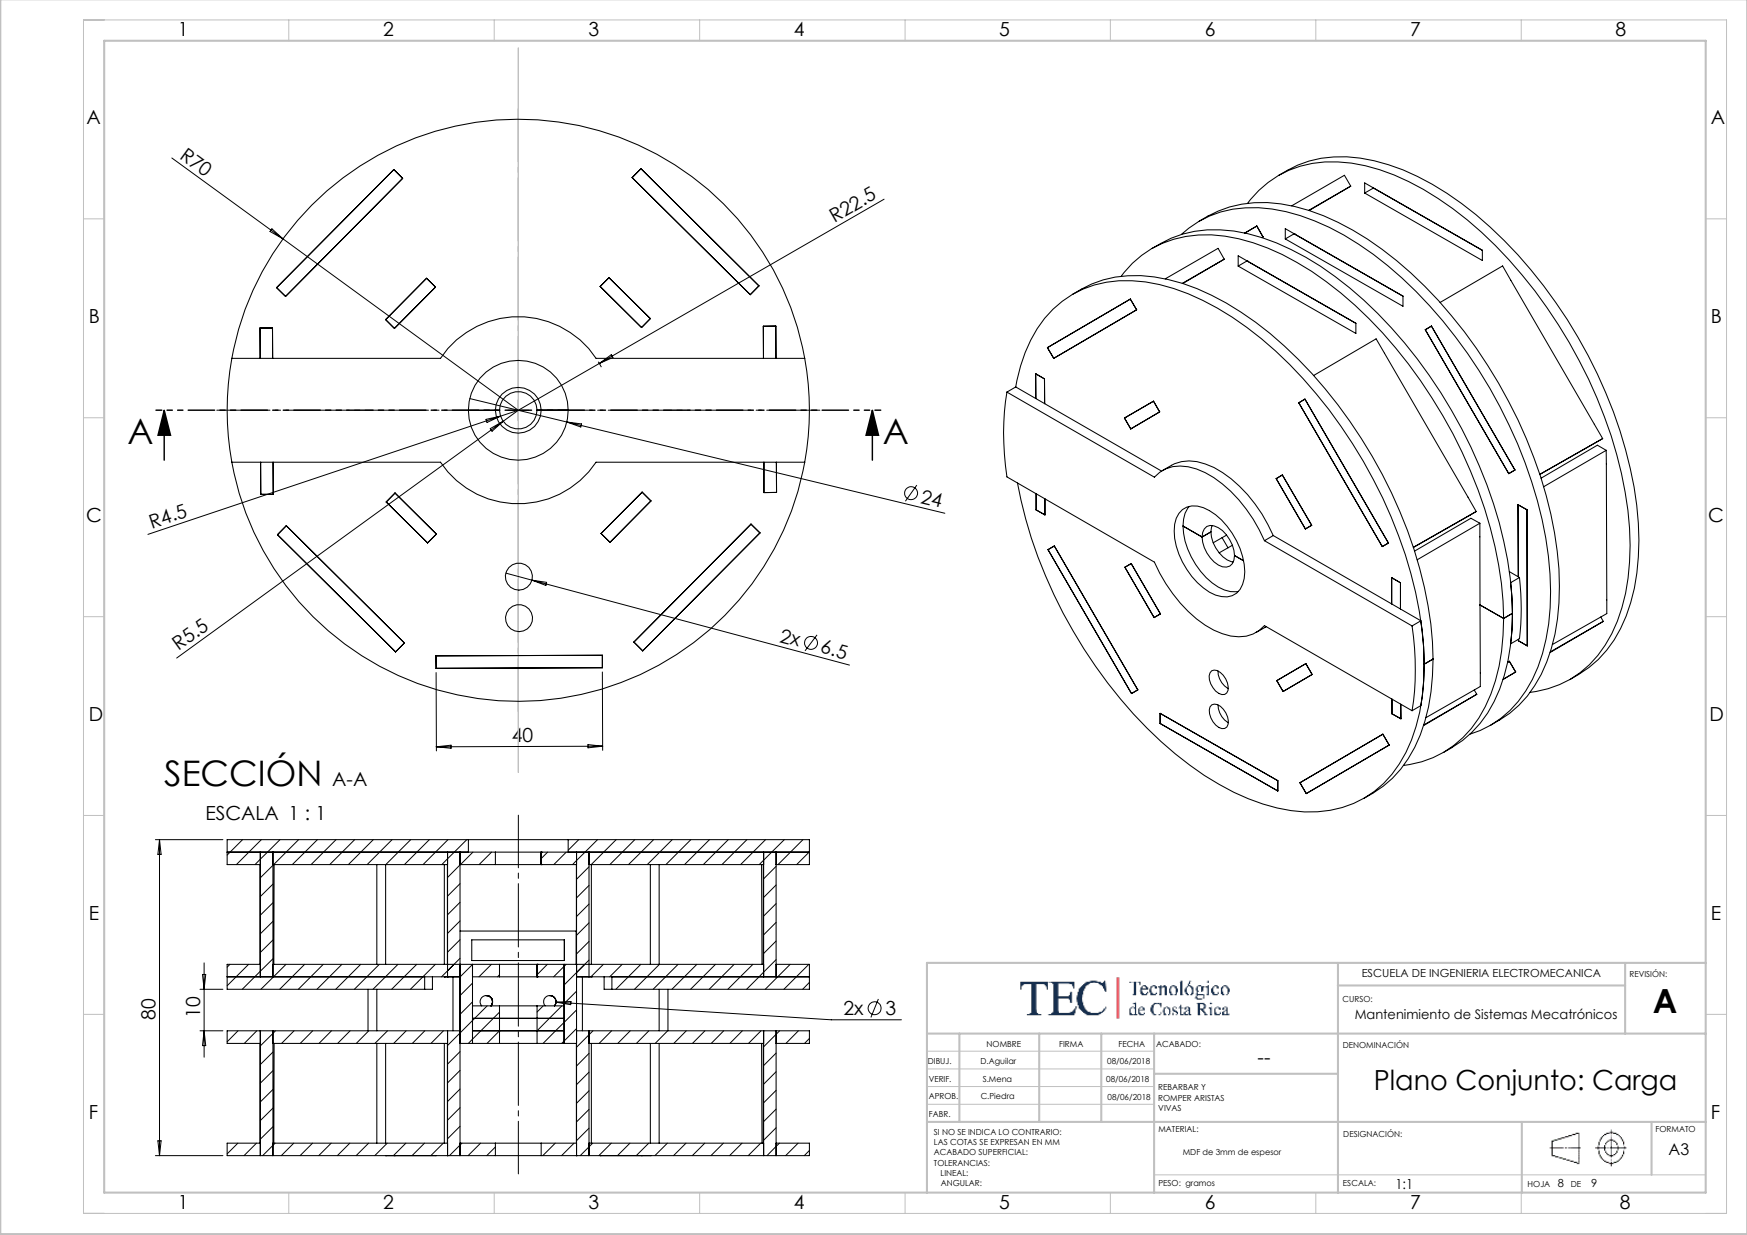
[picture p84: page 1]
SECCIÓN A-A; ESCALA 1 : 1; REBARBAR Y ROMPER ARISTAS

ESCUELA DE INGENIERIA ELECTROMECANICA
Mantenimiento de Sistemas Mecatrónicos

NOMBRE | FIRMA | FECHA | ACABADO: -- | DENOMINACIÓN Plano Conjunto: Carga

DIBUJ. | D.Aguilar | | 08/06/2018
VERIF. | S.Mena | | 08/06/2018
APROB. | C.Piedra | | 08/06/2018
FABR.
SI NO SE INDICA LO CONTRARIO: LAS COTAS SE EXPRESAN EN MM ACABADO SUPERFICIAL: TOLERANCIAS: LINEAL: ANGULAR: | MATERIAL: MDF de 3mm de espesor | | | FORMATO DESIGNACIÓN: A3

PESO: gramos | 1:1 ESCALA: | HOJA 8 DE 9
