steveamena/ManteSistemas/Planos normados/Conjunto de Planos.pdf

1 | 2 | 3 | 4 | 5 | 6 | 7 | 8

A

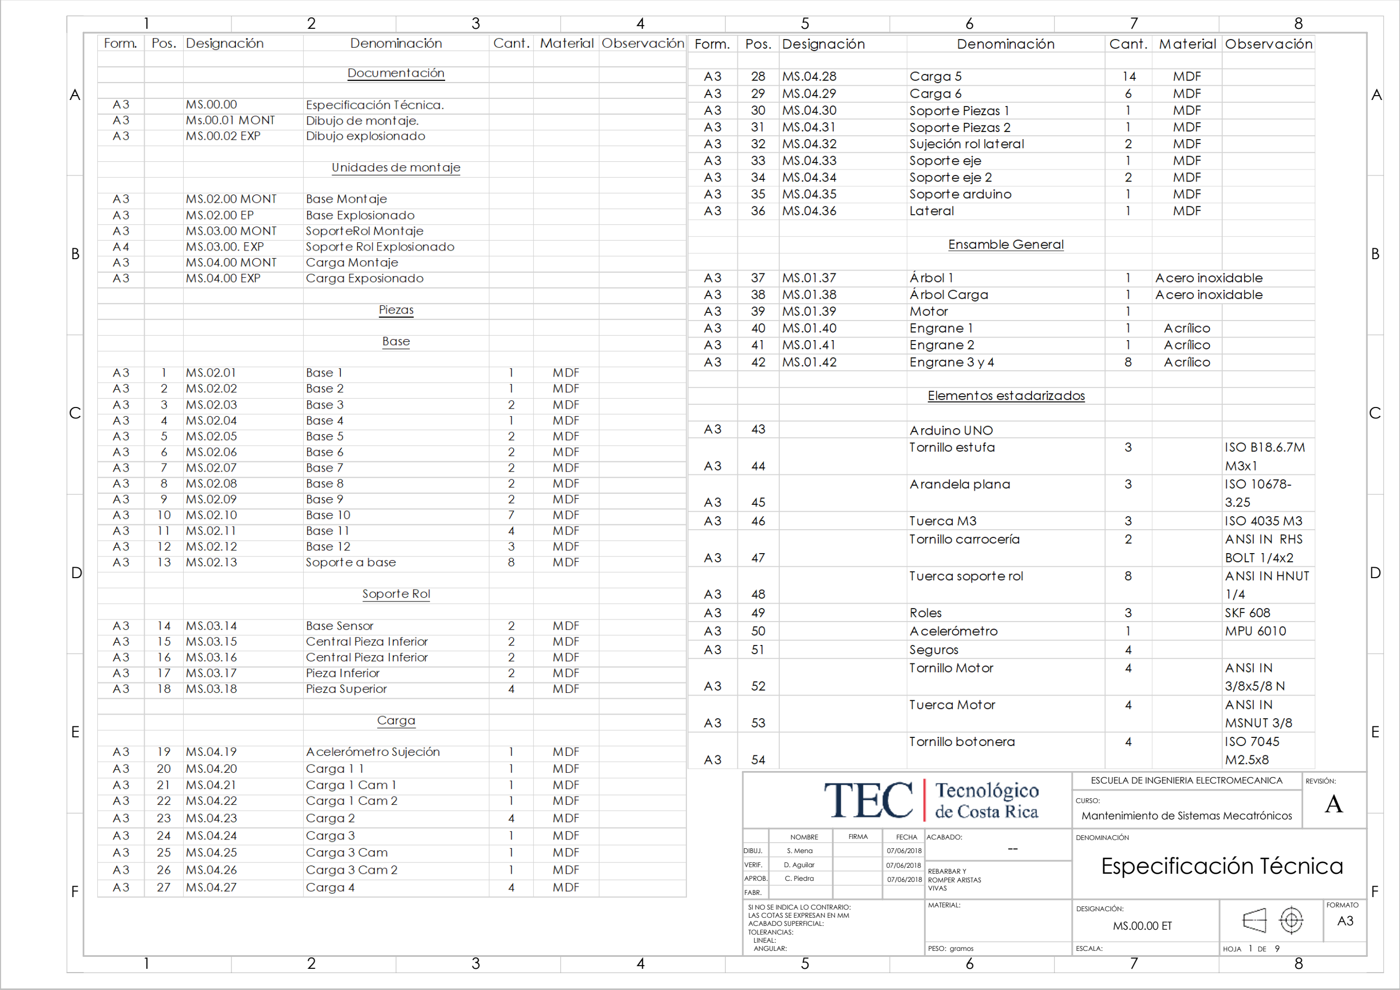
[picture p85: page 1]

| NOMBRE | FIRMA | FECHA | ACABADO: -- | DENOMINACIÓN Especificación Técnica
DIBUJ. | S. Mena | | 07/06/2018
VERIF. | D. Aguilar | | 07/06/2018
APROB. | C. Piedra | | 07/06/2018
FABR.
SI NO SE INDICA LO CONTRARIO: LAS COTAS SE EXPRESAN EN MM ACABADO SUPERFICIAL: TOLERANCIAS: LINEAL: ANGULAR: | MATERIAL: | MS.00.00 ET | | FORMATO DESIGNACIÓN: A3
| PESO: gramos | ESCALA: | HOJA DE

## Mantenimiento de Sistemas Mecatrónicos

REVISIÓN:

REBARBAR Y
ROMPER ARISTAS
VIVAS
CURSO: | A

## ESCUELA DE INGENIERIA ELECTROMECANICA

B | B
C | C
D | D
E | E

F

A

F

A

B | B

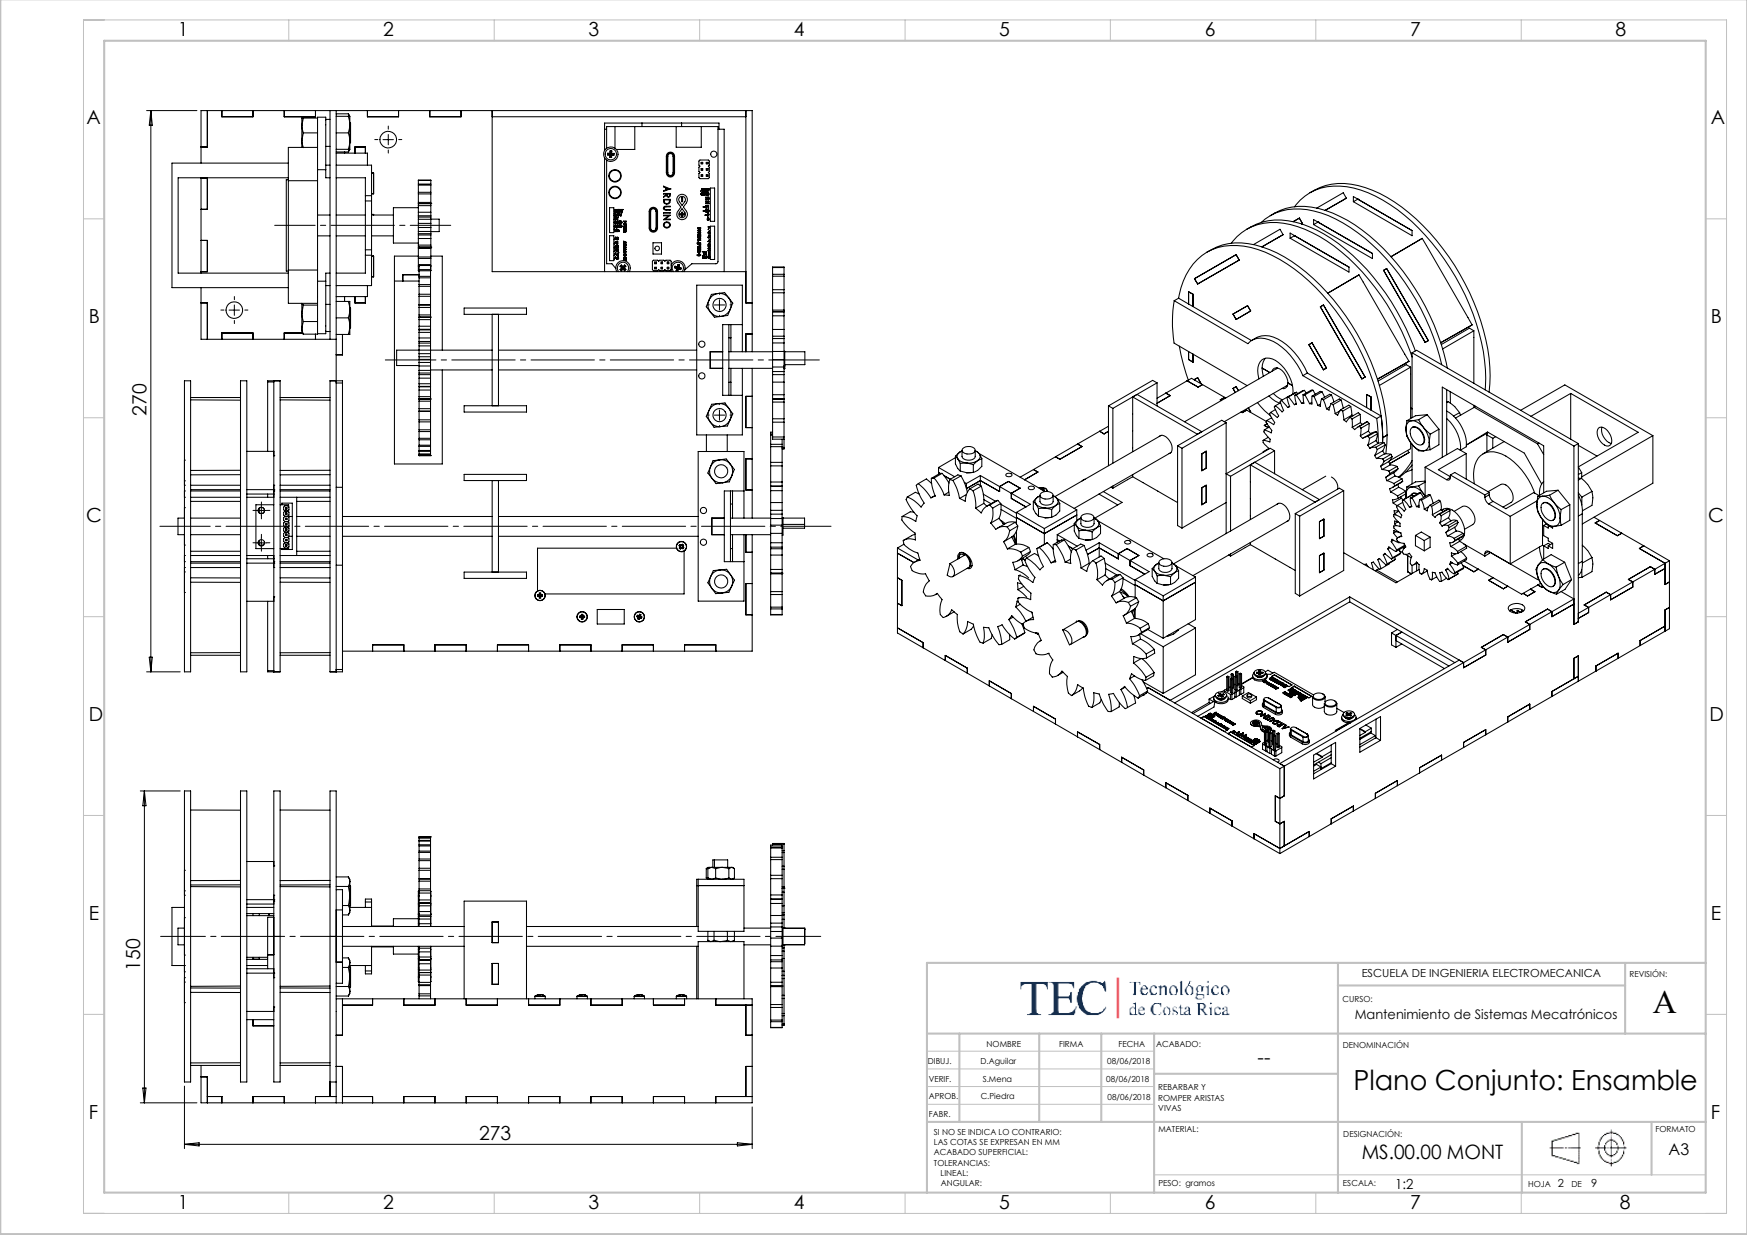
[picture p86: page 2]
REVISIÓN:; REBARBAR Y ROMPER ARISTAS VIVAS; CURSO:

ESCUELA DE INGENIERIA ELECTROMECANICA
Mantenimiento de Sistemas Mecatrónicos

NOMBRE | FIRMA | FECHA | ACABADO: -- | DENOMINACIÓN Plano Conjunto: Ensamble

DIBUJ. | D.Aguilar | | 08/06/2018
VERIF. | S.Mena | | 08/06/2018
APROB. | C.Piedra | | 08/06/2018
FABR.

MATERIAL: | MS.00.00 MONT | | FORMATO DESIGNACIÓN:

1:2 | HOJA DE

41

37

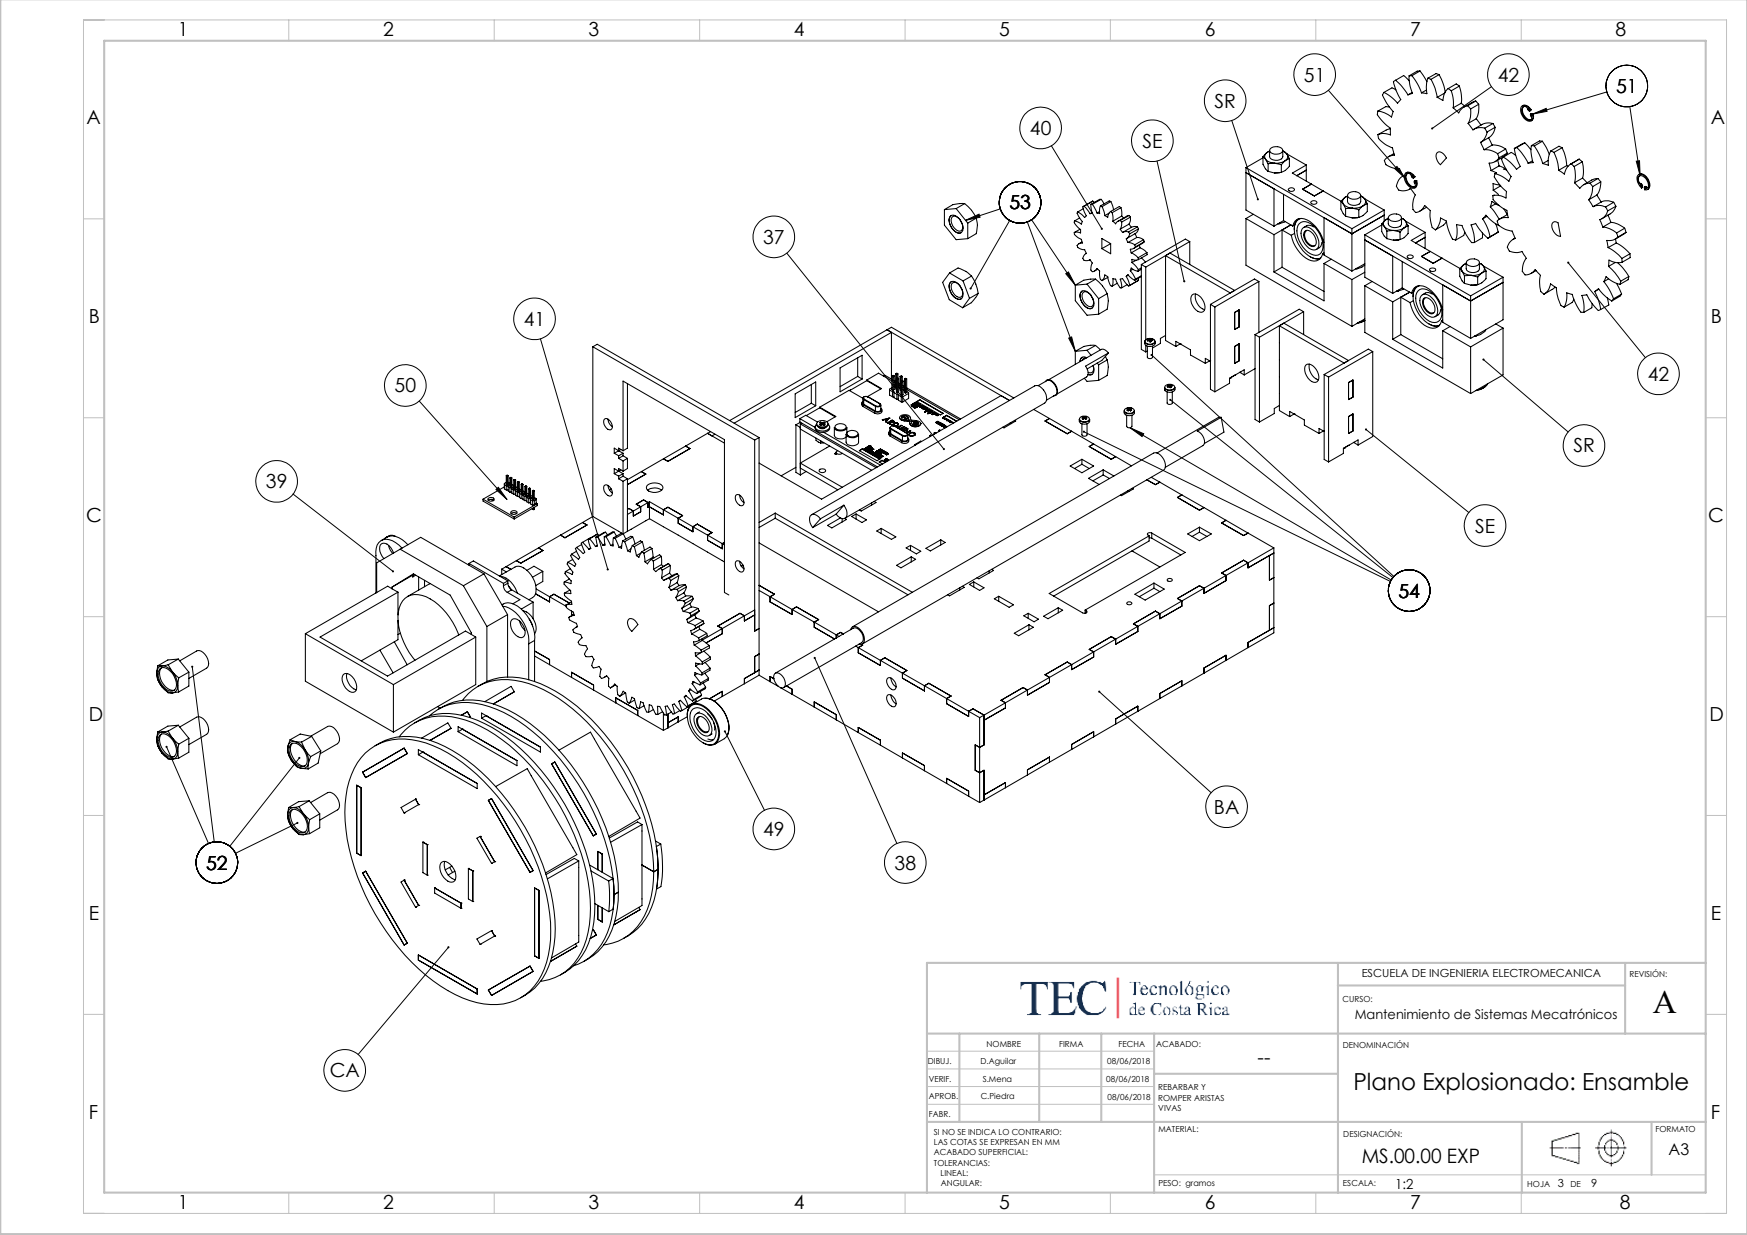
[picture p87: page 3]
REVISIÓN:; REBARBAR Y ROMPER ARISTAS VIVAS; CURSO:

ESCUELA DE INGENIERIA ELECTROMECANICA
Mantenimiento de Sistemas Mecatrónicos

NOMBRE | FIRMA | FECHA | ACABADO: -- | DENOMINACIÓN Plano Explosionado: Ensamble

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

MATERIAL: | MS.00.00 EXP | | FORMATO DESIGNACIÓN:

1:2 | HOJA DE

77,50

22

2 Orif 2,50; 2 Orif 6,50 76; SECCIÓN A-A ESCALA 1 : 2; REVISIÓN:; REBARBAR Y ROMPER ARISTAS VIVAS; CURSO:

ESCUELA DE INGENIERIA ELECTROMECANICA
Mantenimiento de Sistemas Mecatrónicos

NOMBRE | FIRMA | FECHA | ACABADO: -- | DENOMINACIÓN Explosionado Base

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

MATERIAL: MDF de 3 mm de espesor | | | FORMATO DESIGNACIÓN: A3

1 : 2 | HOJA DE

10

15

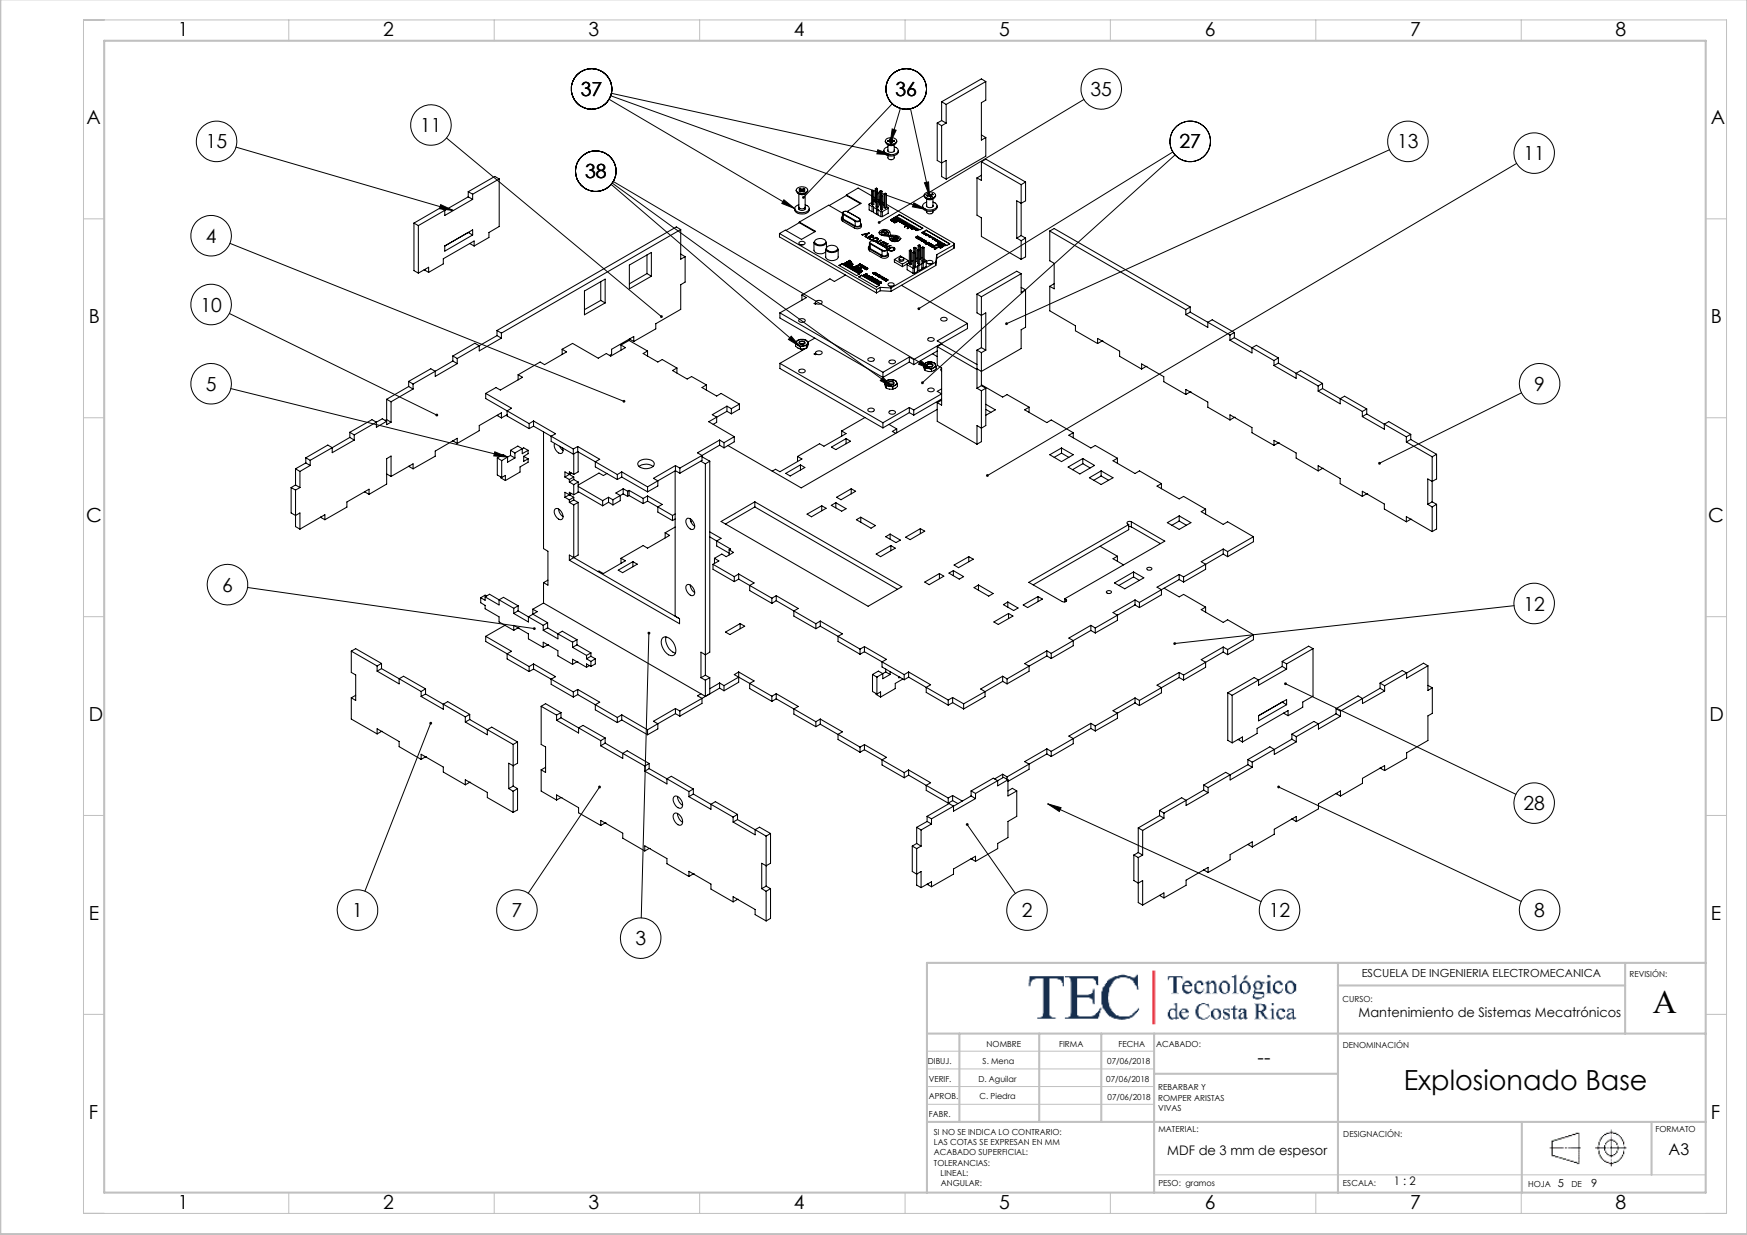
[picture p88: page 5]
REVISIÓN:; REBARBAR Y ROMPER ARISTAS VIVAS; CURSO:

ESCUELA DE INGENIERIA ELECTROMECANICA
Mantenimiento de Sistemas Mecatrónicos

NOMBRE | FIRMA | FECHA | ACABADO: -- | DENOMINACIÓN Explosionado Base

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

MATERIAL: MDF de 3 mm de espesor | | | FORMATO DESIGNACIÓN: A3

1 : 2 | HOJA DE

22
8

2 Orif 3; SECCIÓN A-A; REVISIÓN:; REBARBAR Y ROMPER ARISTAS VIVAS; CURSO:

ESCUELA DE INGENIERIA ELECTROMECANICA
Mantenimiento de Sistemas Mecatrónicos

NOMBRE | FIRMA | FECHA | ACABADO: -- | DENOMINACIÓN Plano Conjunto Soporte Rol

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

MATERIAL: MDF de 3 mm de espesor | | | FORMATO DESIGNACIÓN: A3

1 : 1 | HOJA DE

18

16

CURSO:; REVISIÓN:

ESCUELA DE INGENIERIA ELECTROMECANICA
Mantenimiento de Sistemas Mecatrónicos

NOMBRE | FIRMA | FECHA | --ACABADO GENERAL: REBARBAR Y ROMPER ARISTAS VIVAS | DENOMINACIÓN

DIBUJ. | S. Mena | | 07/06/2018
VERIF. | D. Aguilar
APROB. | C. Piedra | | 07/06/2018
FABR.
SI NO SE INDICA LO CONTRARIO: LAS COTAS SE EXPRESAN EN mm | TOLERANCIAS: LINEAL: X ±0.25 . X ±0.1 . XX ±0.05 . XXX ±0.010 ANGULAR: ±0.1° | TRATAMIENTO TÉRMICO | DESIGNACIÓN: | | FORMATO

Explosionado: Soporte Rol ⁰⁷/06/2018

MATERIAL:
MDF de 3 mm
de espesor

1 : 1 | HOJA DE

A

B

SECCIÓN A-A; ESCALA 1 : 1; REVISIÓN:; REBARBAR Y ROMPER ARISTAS VIVAS; CURSO:

ESCUELA DE INGENIERIA ELECTROMECANICA
Mantenimiento de Sistemas Mecatrónicos

NOMBRE | FIRMA | FECHA | ACABADO: -- | DENOMINACIÓN Plano Conjunto: Carga

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

MATERIAL: MDF de 3mm de espesor | | | FORMATO DESIGNACIÓN:

1:1 | HOJA DE

27

29

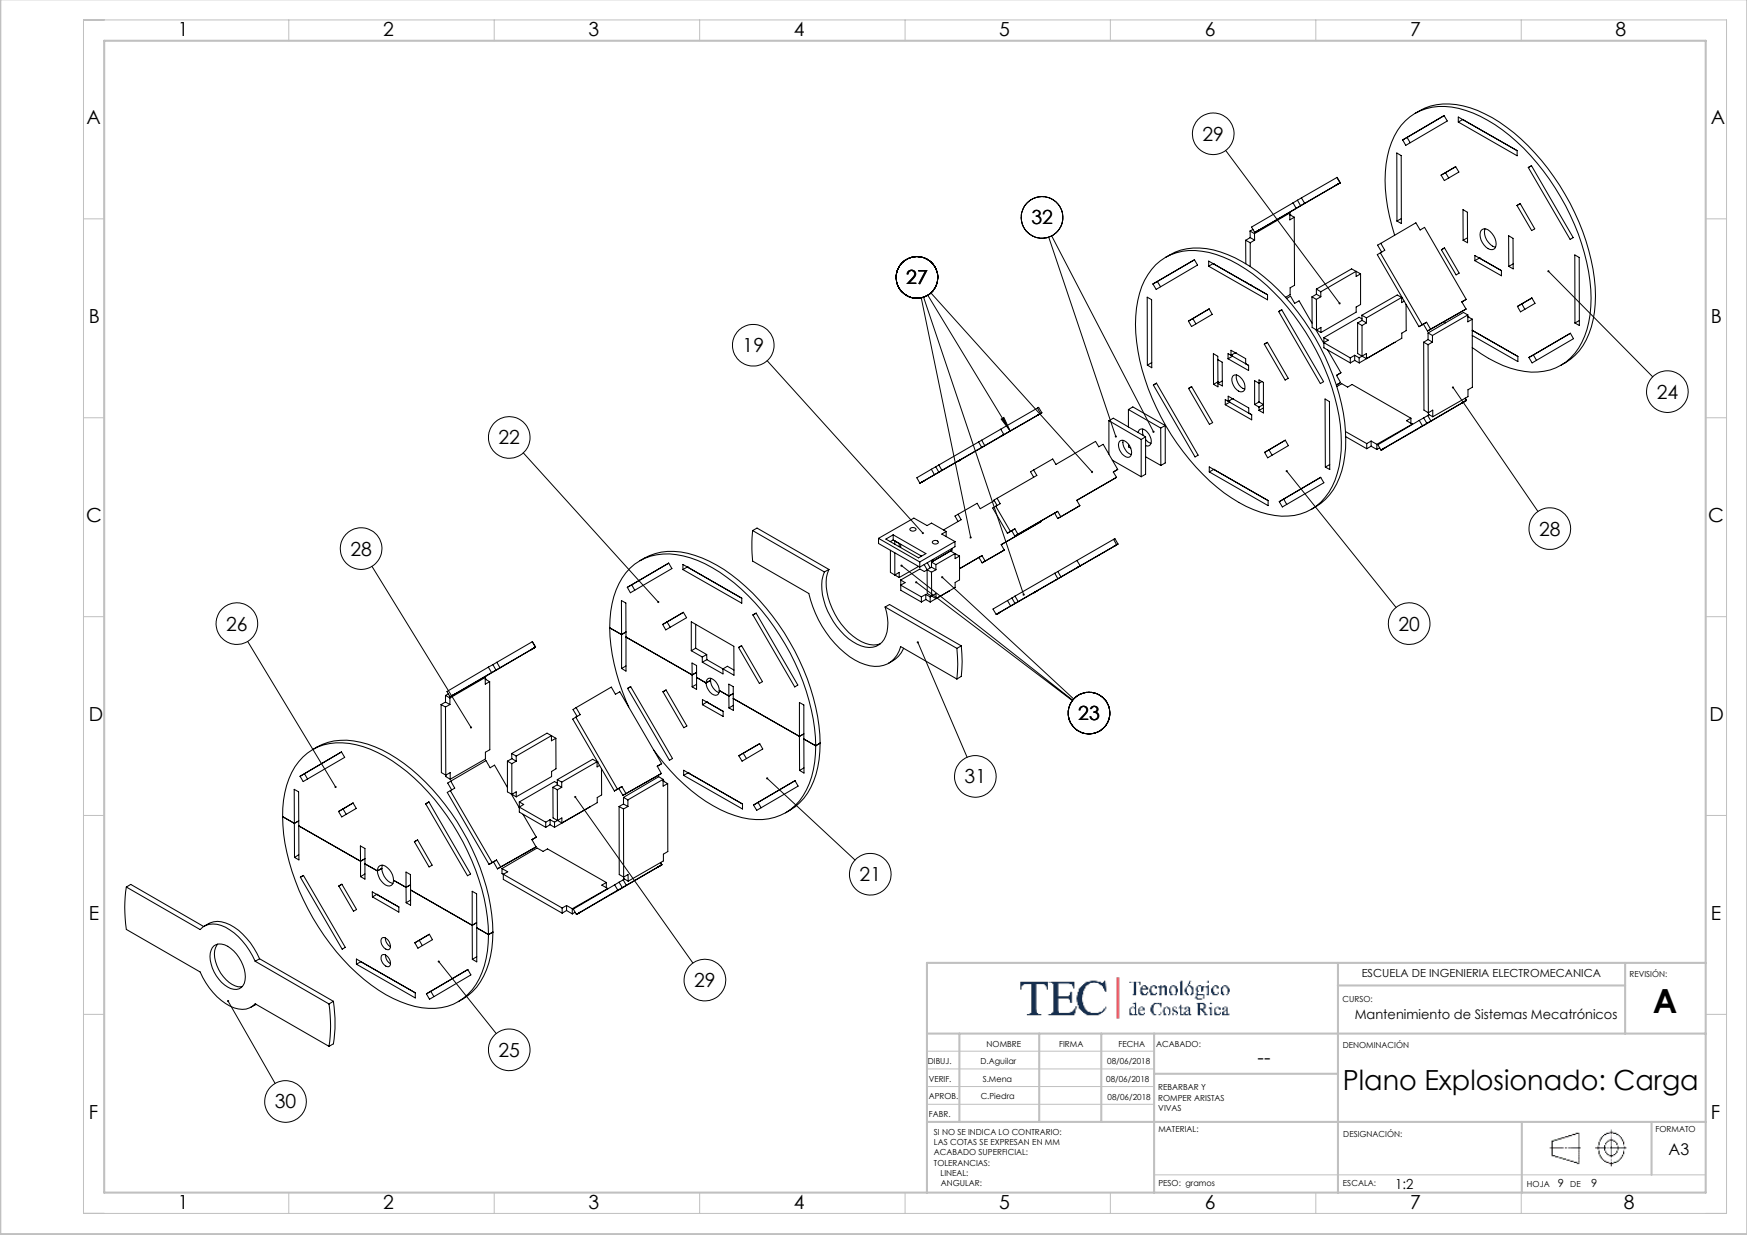
[picture p89: page 9]
Plano Explosionado: Carga; REVISIÓN:; REBARBAR Y ROMPER ARISTAS VIVAS; CURSO:

ESCUELA DE INGENIERIA ELECTROMECANICA
Mantenimiento de Sistemas Mecatrónicos

NOMBRE | FIRMA | FECHA | ACABADO: -- | DENOMINACIÓN

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

MATERIAL: | | | FORMATO DESIGNACIÓN:

1:2 | HOJA DE
