steveamena/ManteSistemas/Planos de corte/Ejes_Maquinado.pdf

43,61

301,26 <MOD⁻DIAM>8 | <MOD⁻DIAM>9,53 4 <MOD⁻DIAM>8

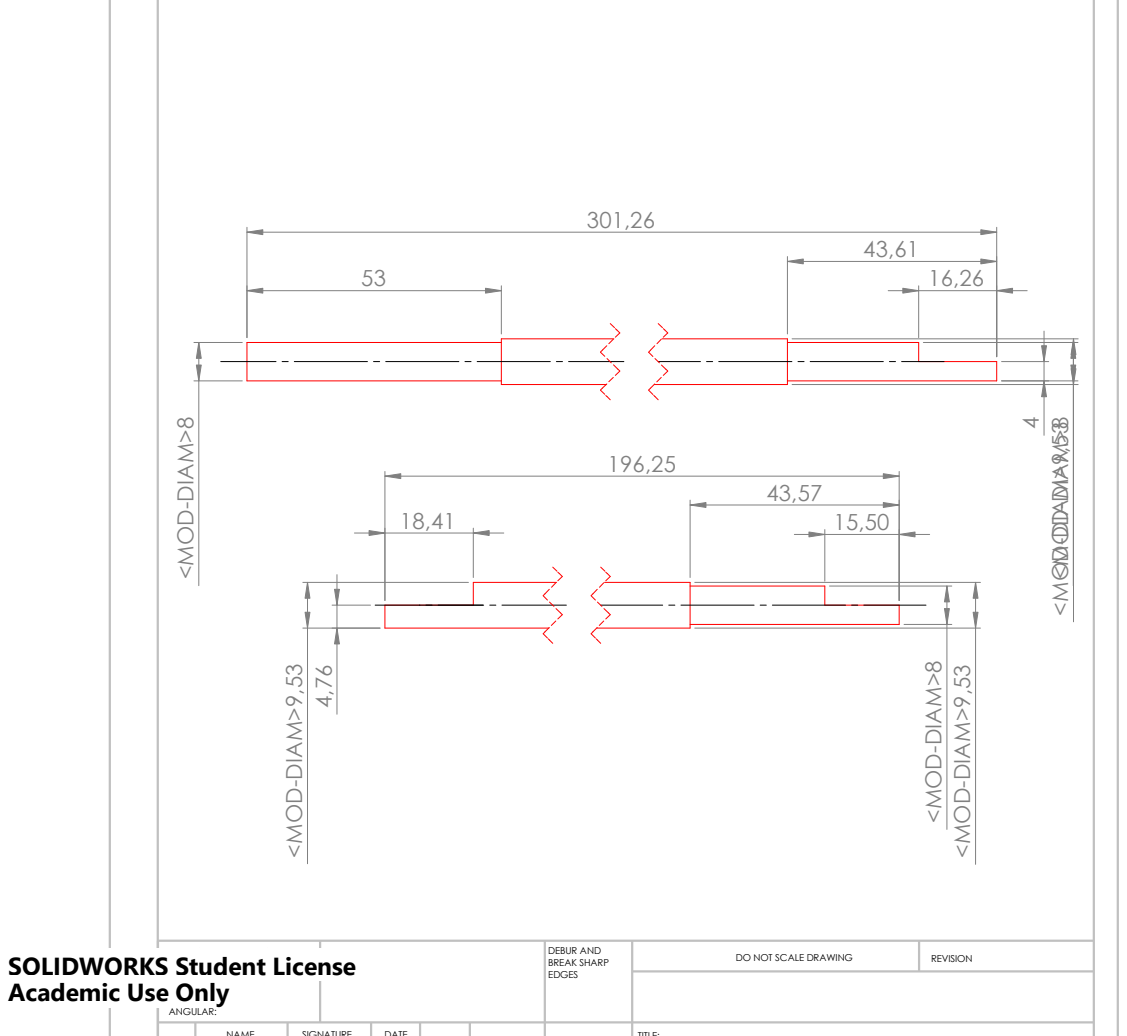
[picture p90: page 1]
TITLE:; DO NOT SCALE DRAWING; REVISION; NAME; SIGNATURE; DATE; EDGES; FINISH:; BREAK SHARP; DEBUR AND; ANGULAR:; LINEAR:; <MOD⁻DIAM>8; 15,50 <MOD⁻DIAM>9,53 4,76; <MOD⁻DIAM>9,53

SOLIDWORKS Student License
Academic Use Only

UNLESS OTHERWISE SPECIFIED:
DIMENSIONS ARE IN MILLIMETERS
SURFACE FINISH:
TOLERANCES:
