steveamena/ManteSistemas/Planos de corte/CorteMDF3mmP2.PDF

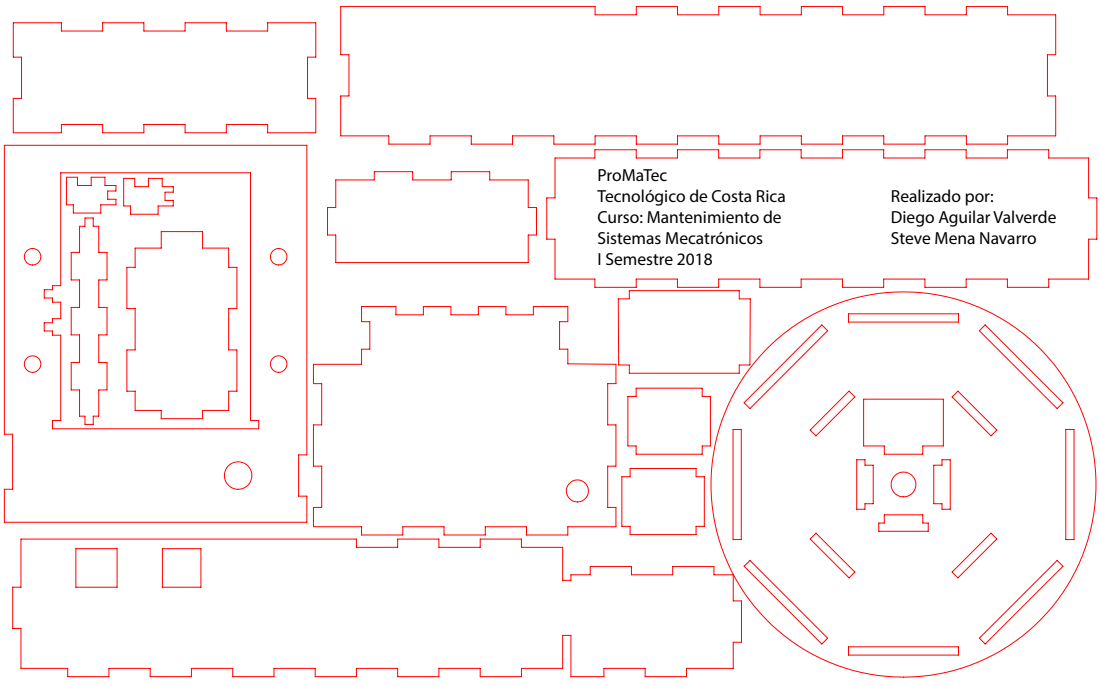
[picture p91: page 1]

ProMaTec
Tecnológico de Costa Rica
Curso: Mantenimiento de
Sistemas Mecatrónicos
I Semestre 2018

Realizado por:
Diego Aguilar Valverde
Steve Mena Navarro
