steveamena/ManteSistemas/Planos de corte/CorteMDF3mm.PDF

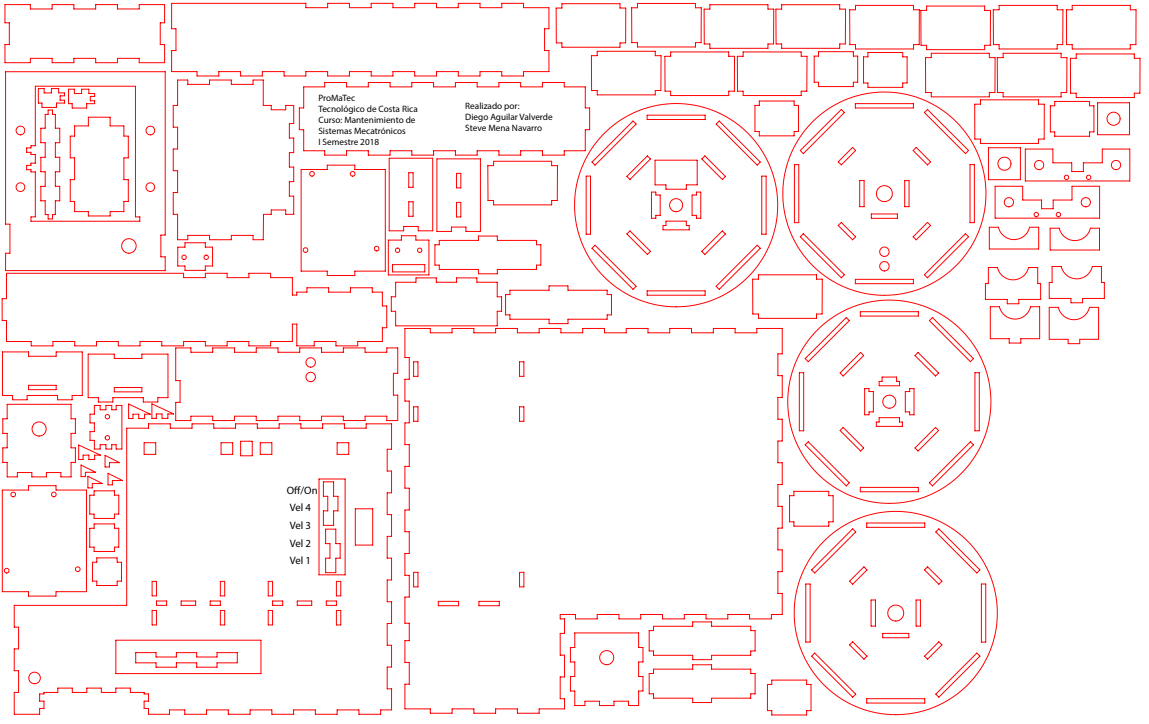
[picture p92: page 1]
Vel 4 Vel 3 Vel 2 Vel 1

ProMaTec
Tecnológico de Costa Rica
Curso: Mantenimiento de
Sistemas Mecatrónicos
I Semestre 2018

Realizado por:
Diego Aguilar Valverde
Steve Mena Navarro
