steveamena/ManteSistemas/Planos de corte/MDF3mm_Soporte_a_base.PDF

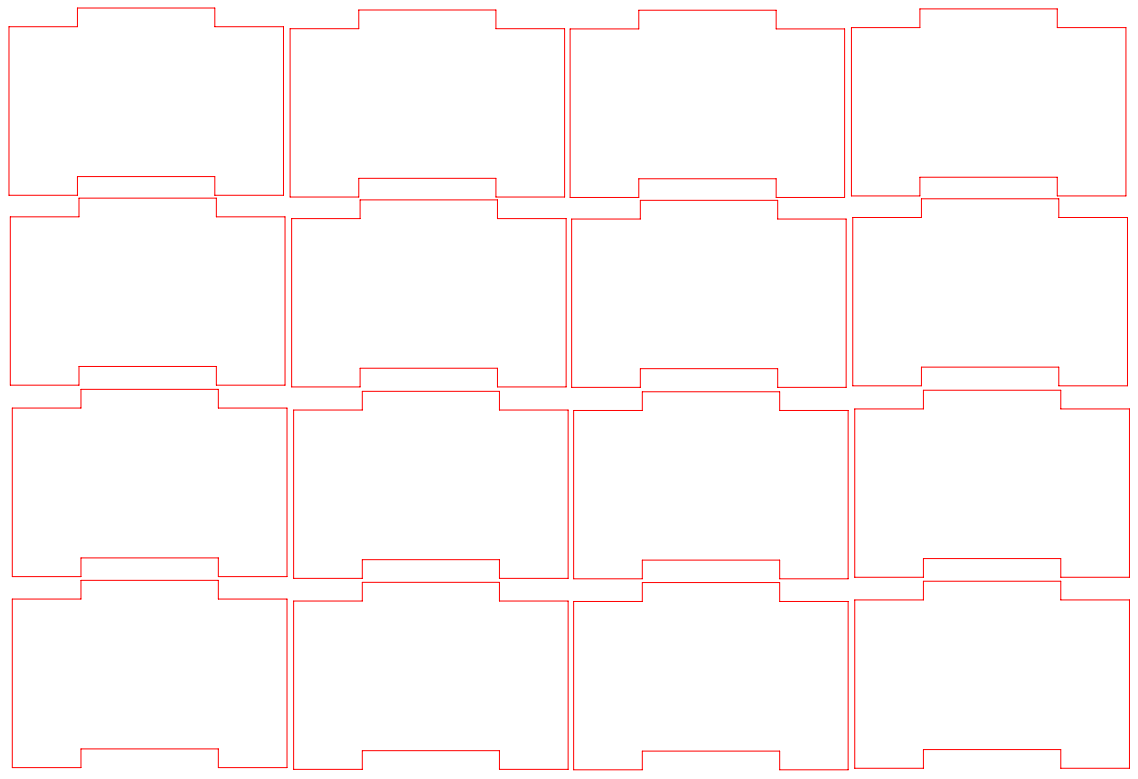
[picture p93: page 1]
