steveamena/ManteSistemas/Planos de corte/CorteAcrilico3_80.PDF

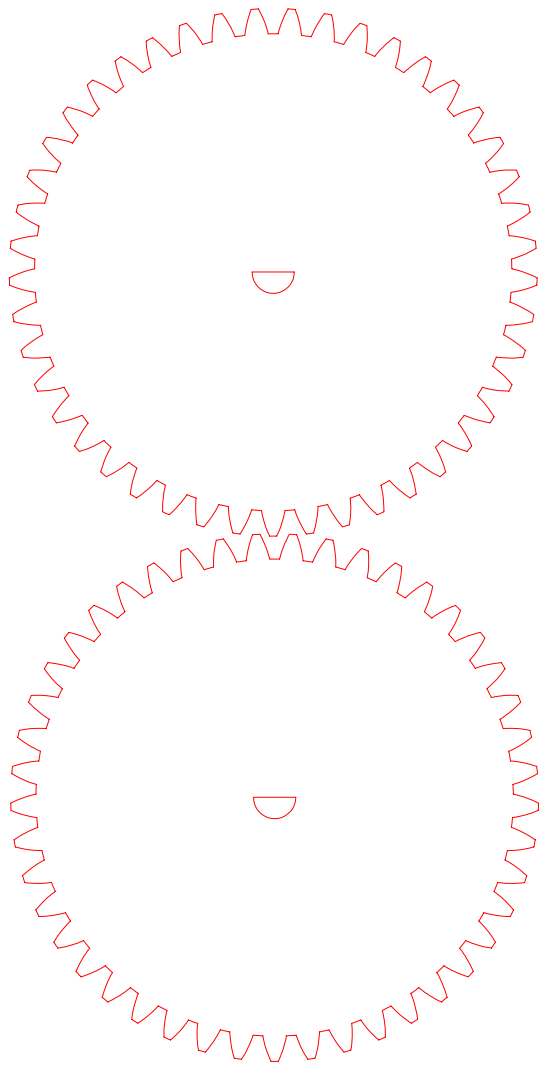
[picture p94: page 1]
