steveamena/ManteSistemas/Planos de corte/CorteAcrilico3_Engranes34.PDF

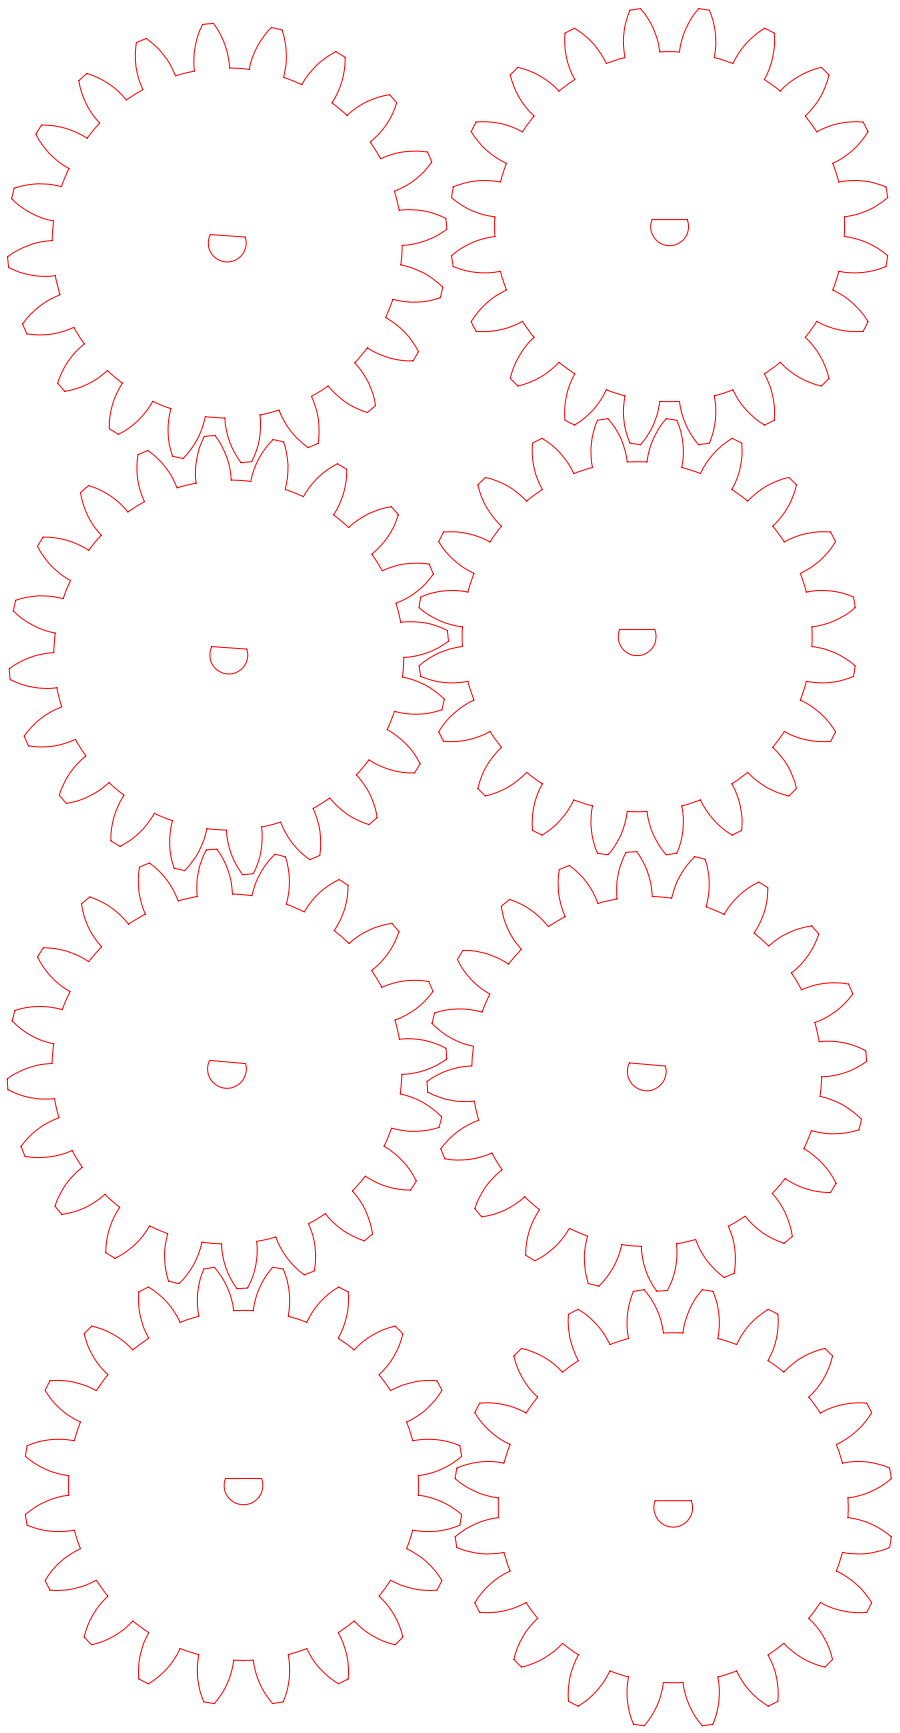
[picture p95: page 1]
