steveamena/ManteSistemas/Planos de corte/CorteMDF3mm_Carga_01.PDF

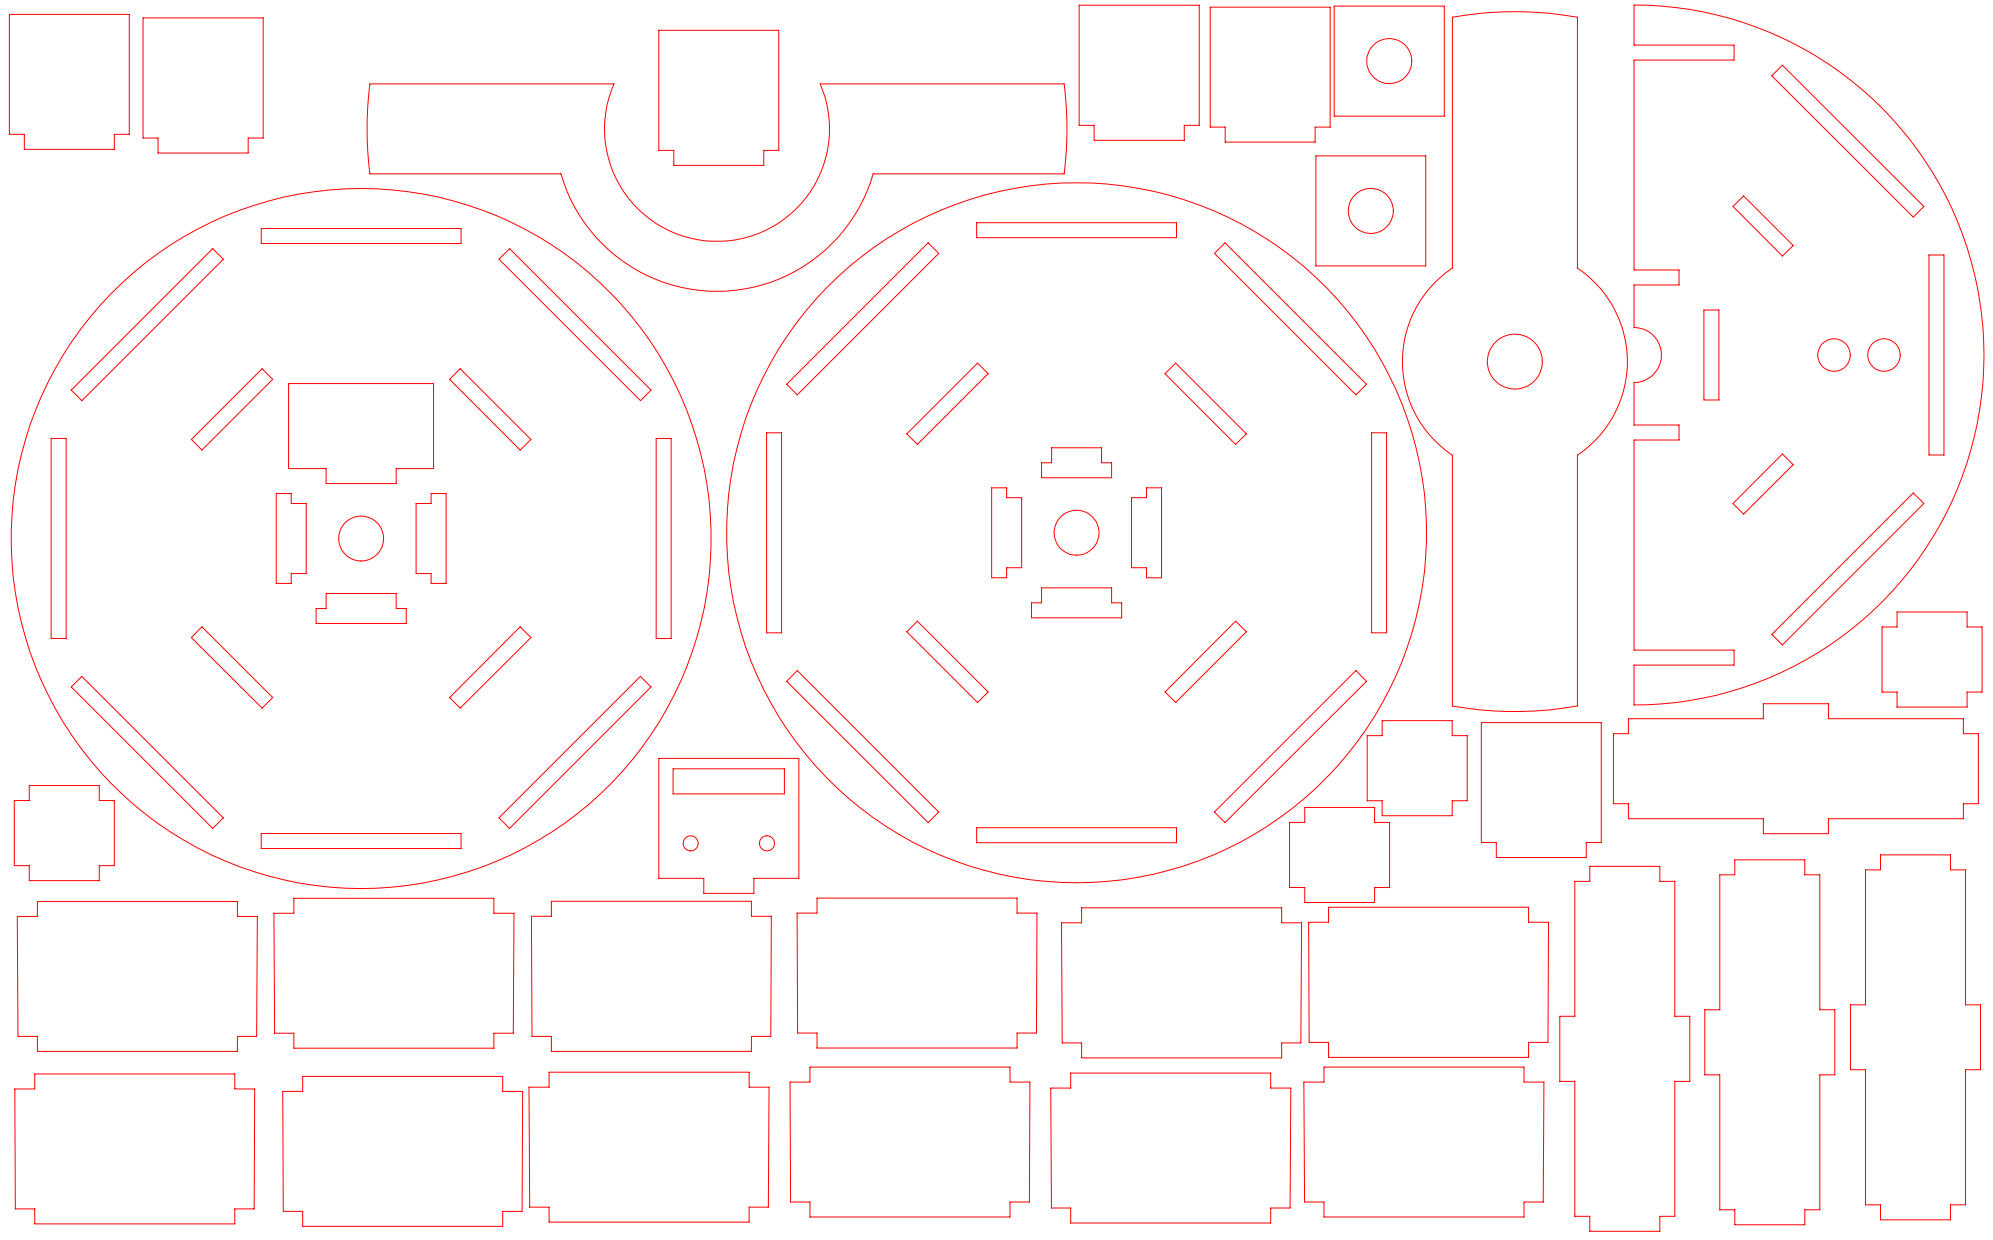
[picture p96: page 1]
