steveamena/ManteSistemas/Planos de corte/CorteMDF3mm_Carga_02.PDF

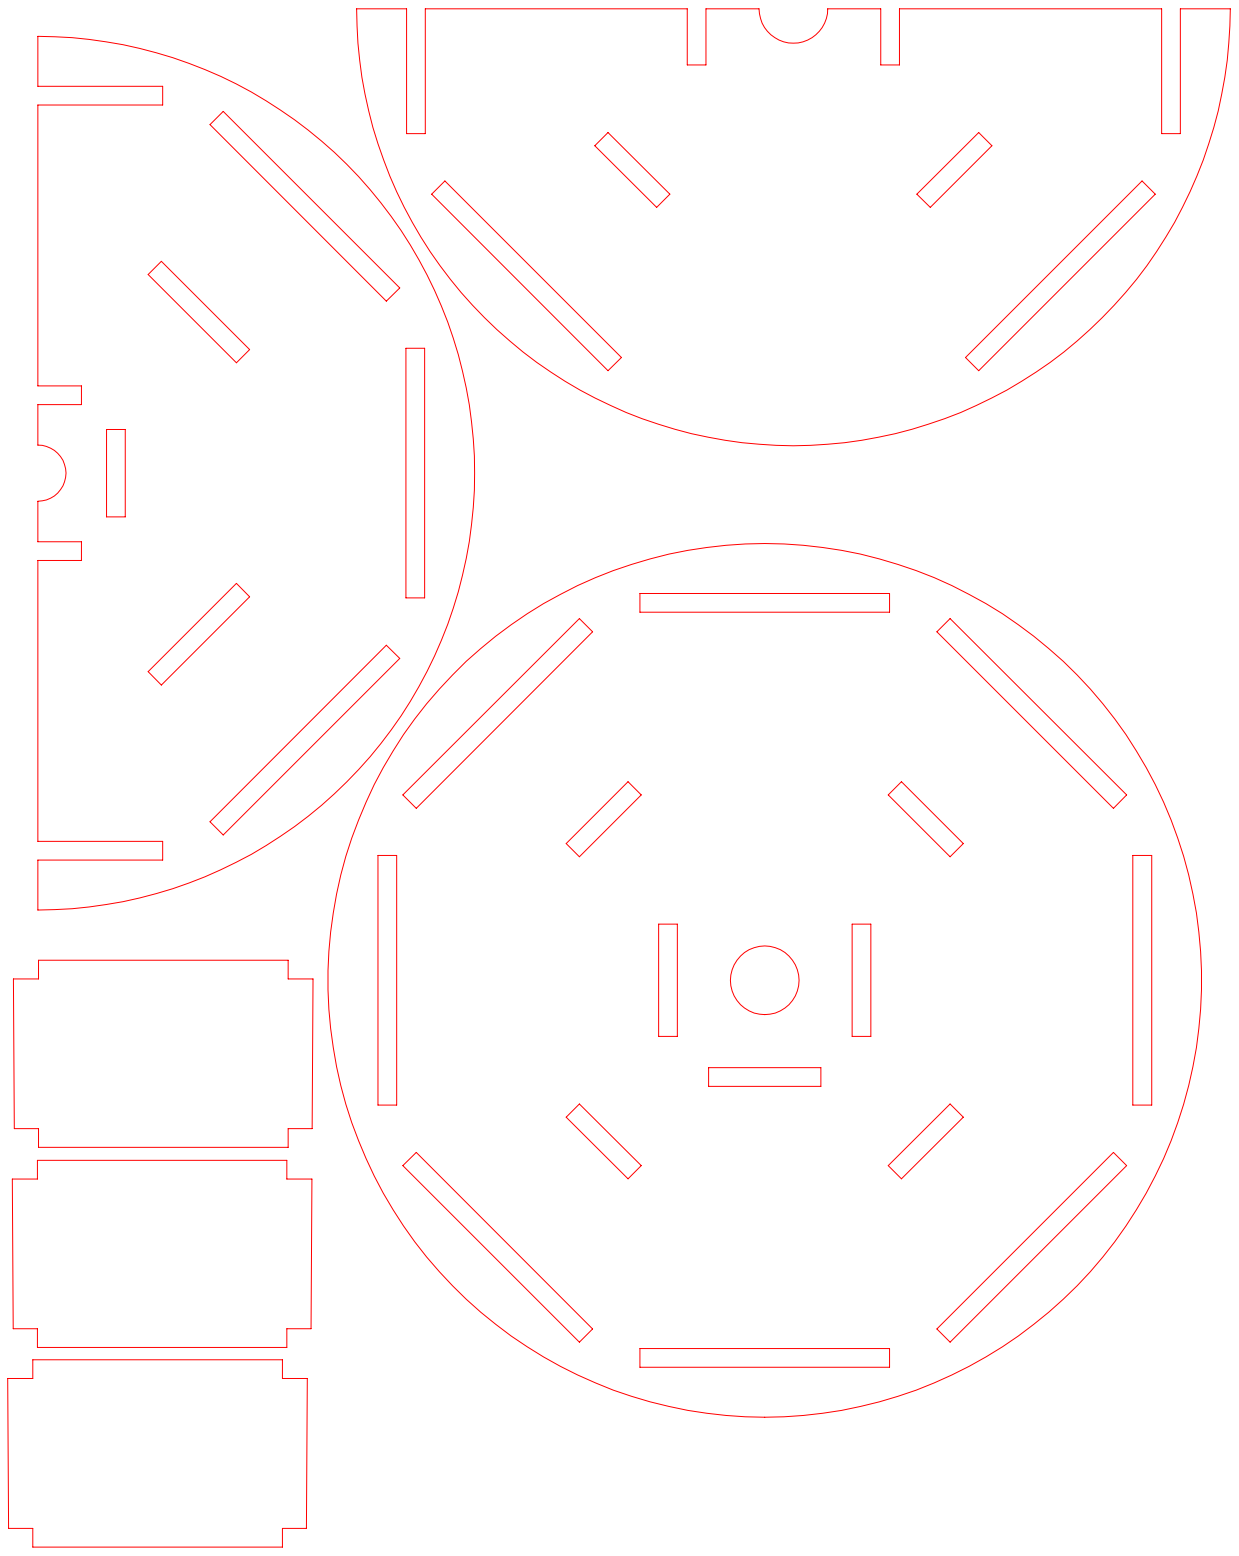
[picture p97: page 1]
