steveamena/ManteSistemas/Planos de corte/CorteAcrilico3.PDF

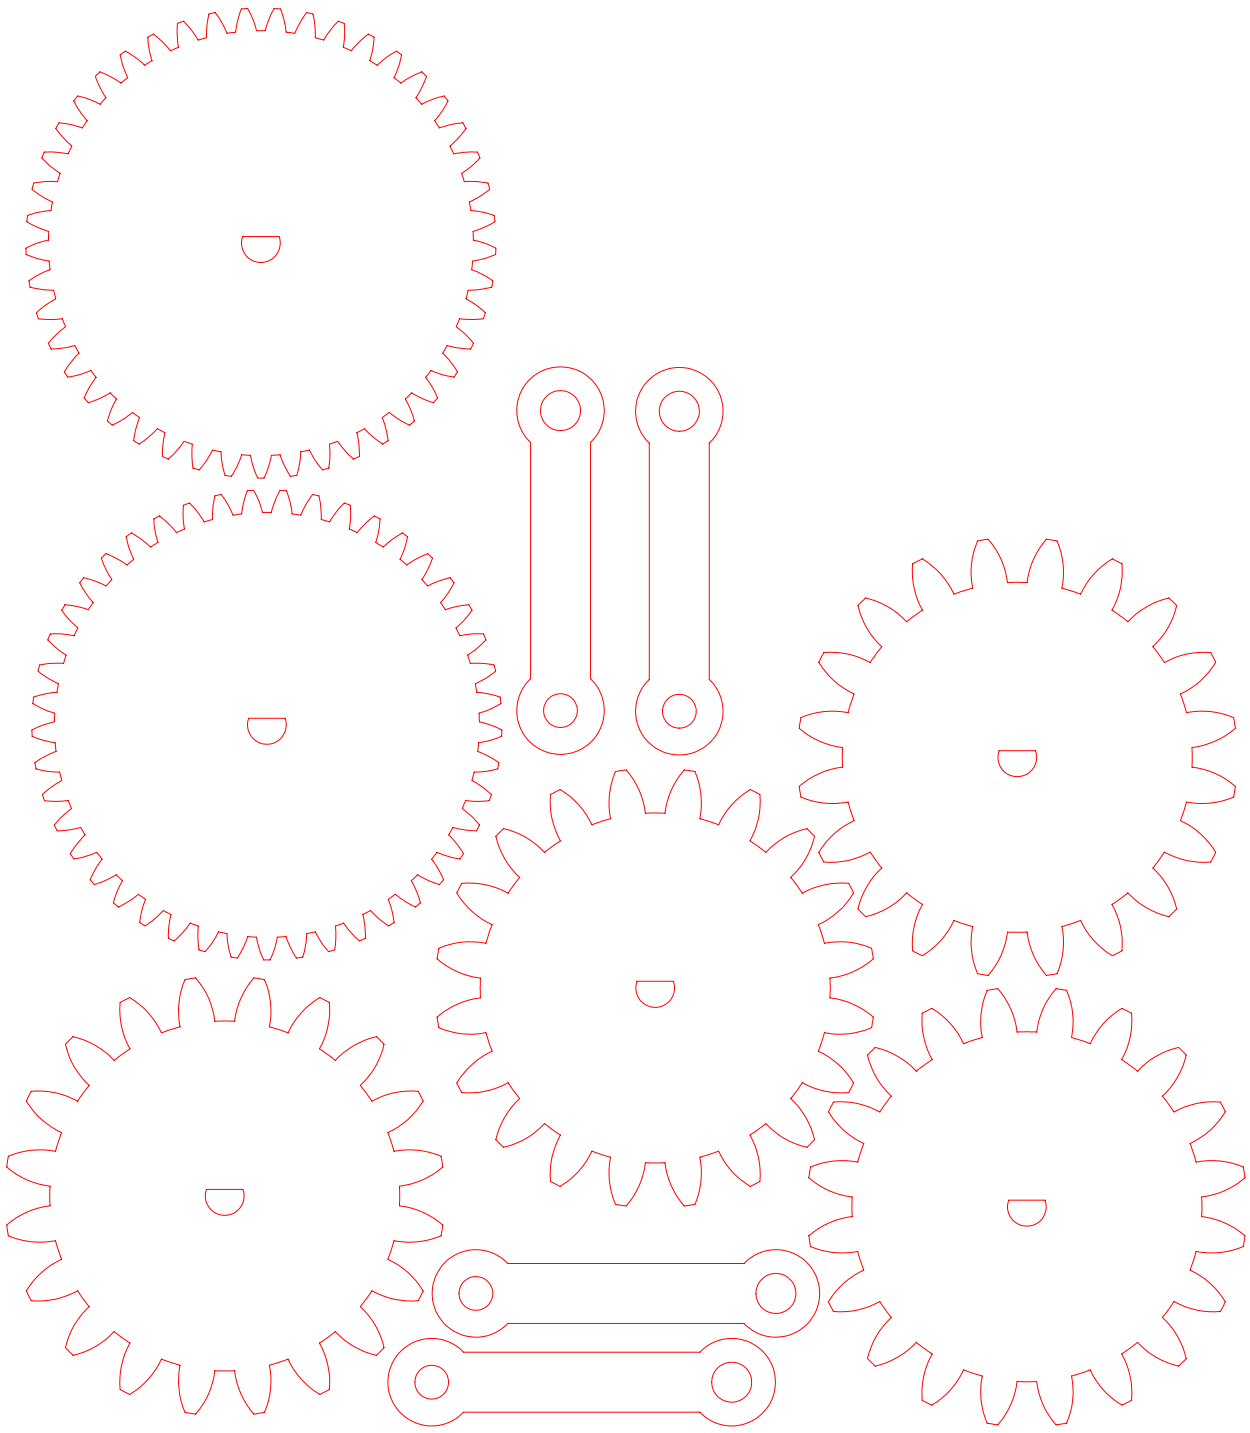
[picture p98: page 1]
