steveamena/ManteSistemas/Planos de corte/Planos_Corte_Nuevo.PDF

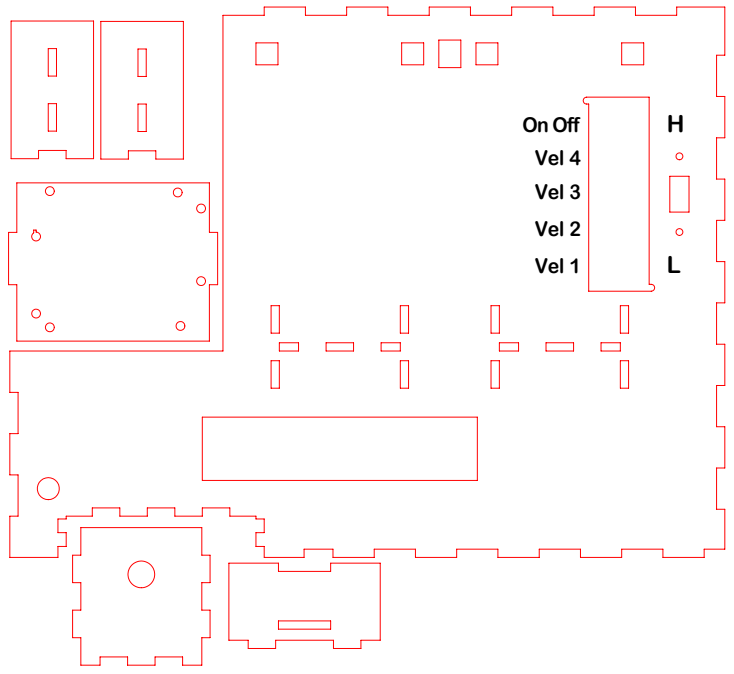
[picture p99: page 1]
On Off

Vel 4 Vel 3 Vel 2 Vel 1
