steveamena/ManteSistemas/Planos de corte/CorteMDF3mmP1.PDF

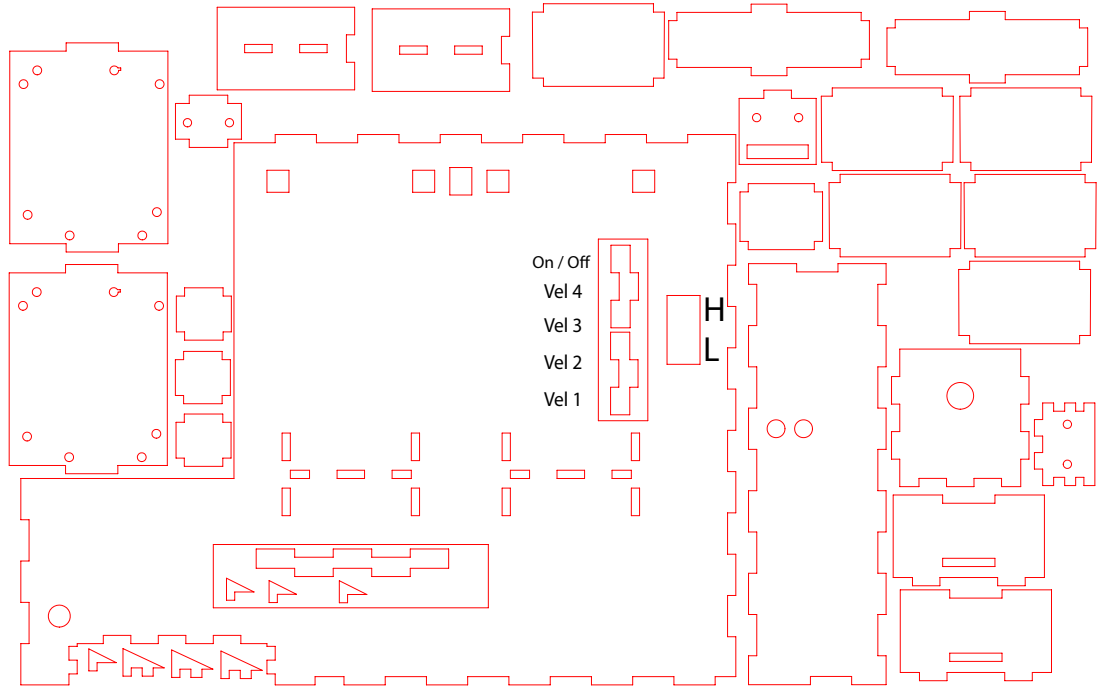
[picture p100: page 1]
Vel 4 Vel 3; Vel 2; Vel 1
