steveamena/ManteSistemas/Planos de corte/CorteMDF3mmP3.PDF

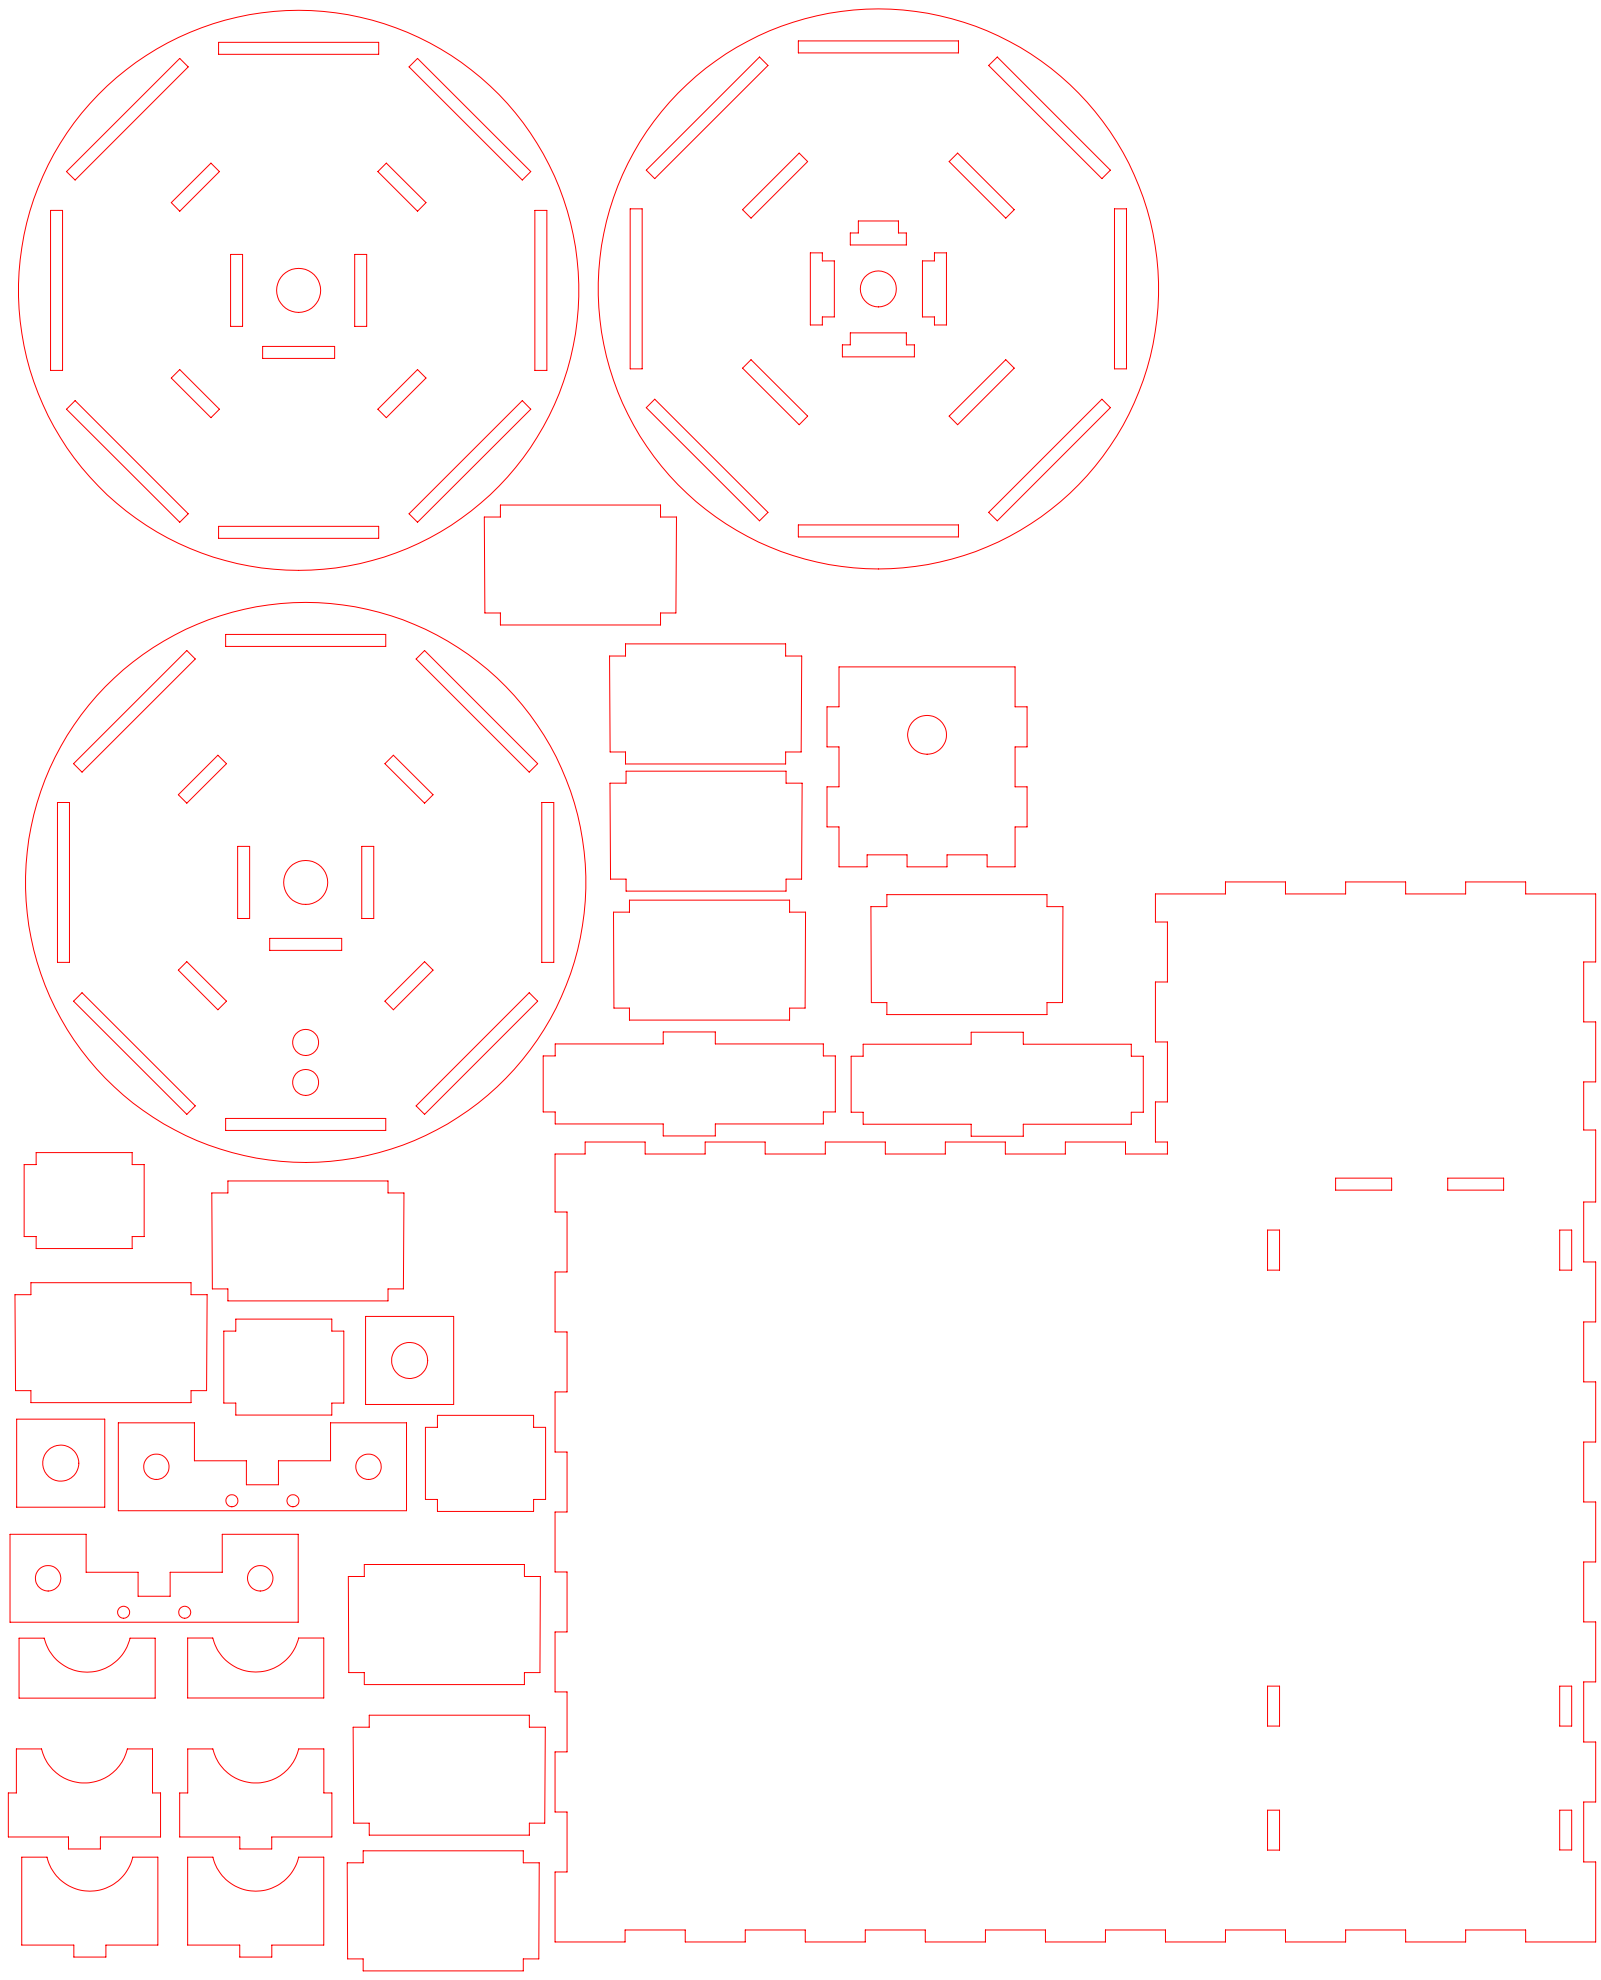
[picture p101: page 1]
