steveamena/ManteSistemas/Planos de corte/CorteAcrilico5_5.PDF

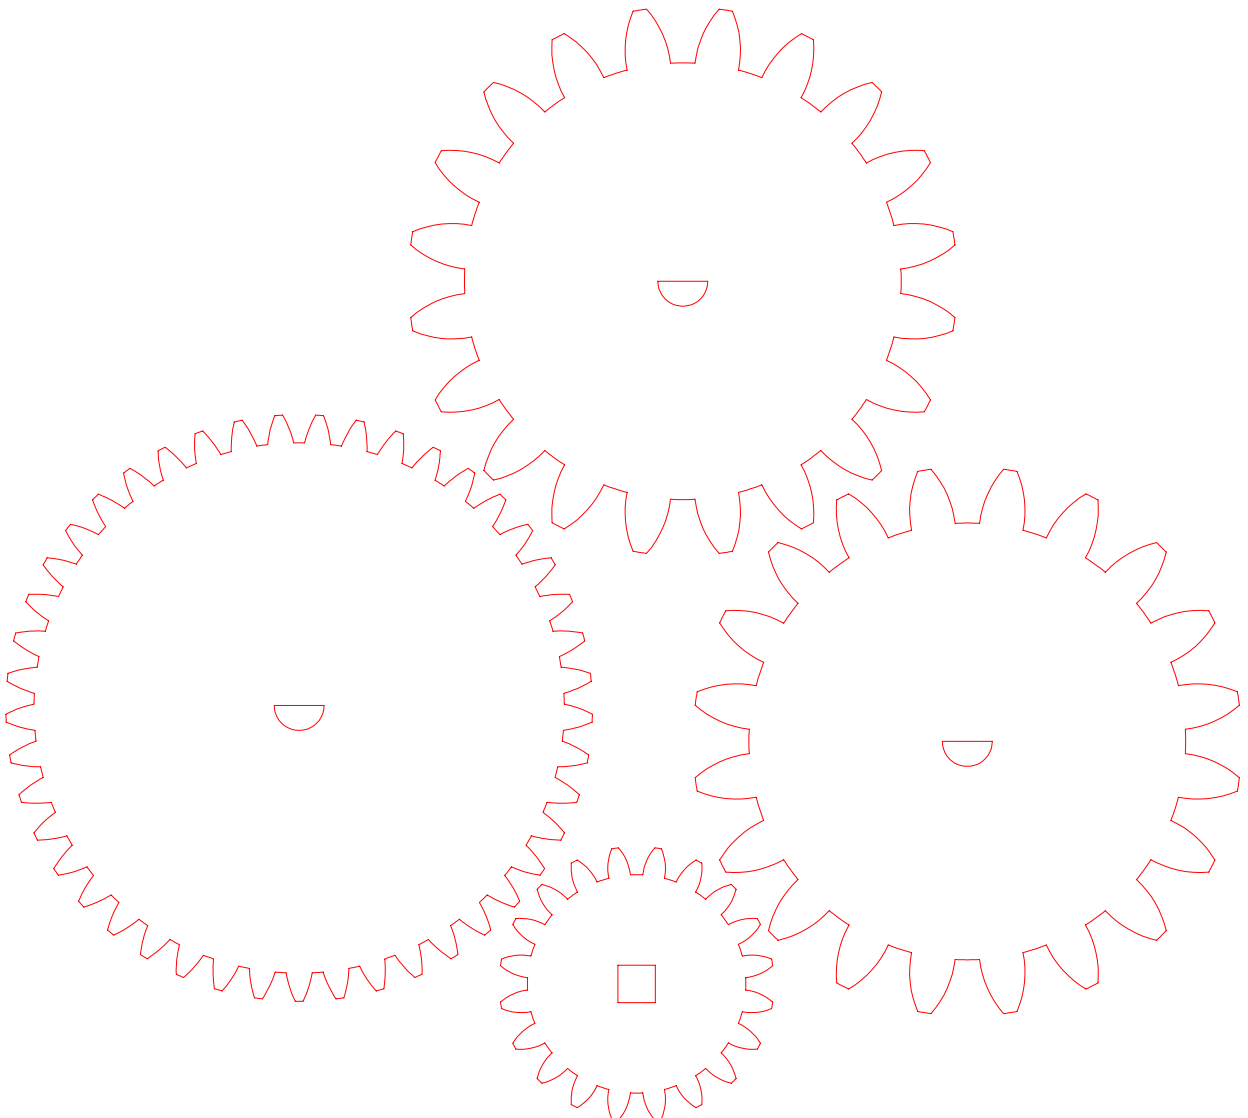
[picture p102: page 1]
