steveamena/ManteSistemas/Planos de corte/Cuarto MDF 5_5 mm.pdf

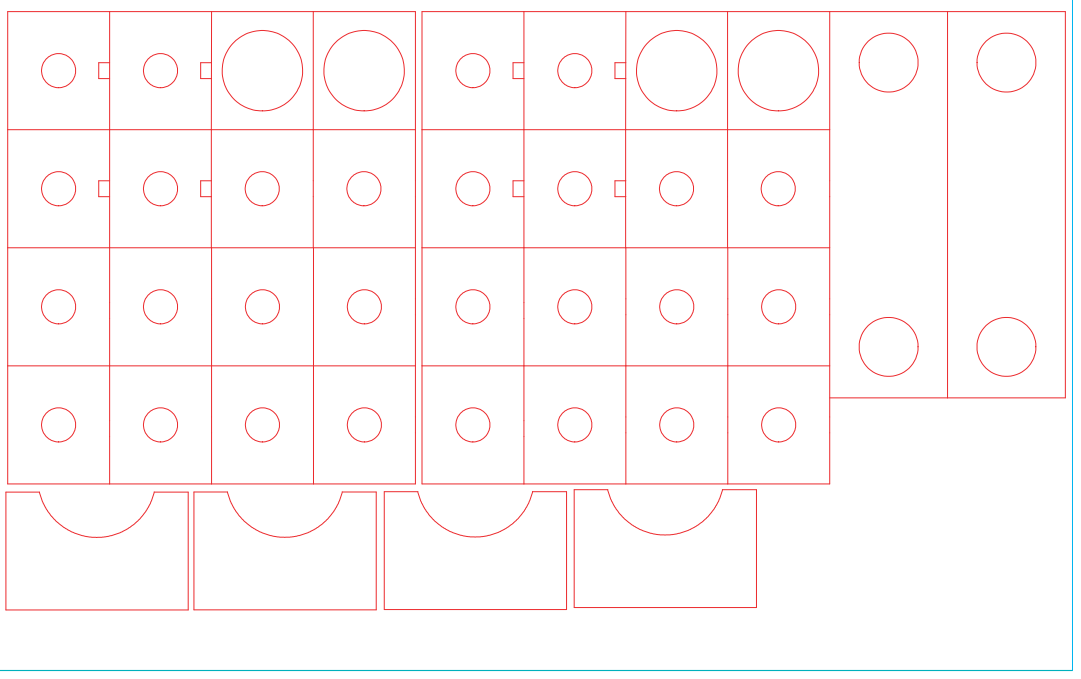
[picture p103: page 1]
