steveamena/ManteSistemas/(commit log)

2018-04-02 Soporte Rol
    Sub ensamblaje del Soporte para el Rol
    [Base_Sensor.SLDPRT, Central_Pieza.SLDPRT, Pieza_Inferior.SLDPRT, Pieza_Superior.SLDPRT, Soporte_Rol.SLDASM]
2018-04-07 modificacion de base
    [Base.SLDPRT]
2018-04-07 eliminar carpeta
    [SoporteEje1.SLDPRT, SoporteEje2.SLDPRT]
2018-04-09 Rol, Electronica y acelerometro
    [Acelerometro.SLDPRT, Acelerometro_Sujecion.SLDPRT, Arduino board.SLDPRT, Base_Sensor.SLDPRT, BreadBoard Large.SLDPRT, Central_Pieza Inferior.SLDPRT, Central_Pieza.SLDPRT, Cojinete SKF 608.SLDPRT]
2018-04-14 Modificacion de los ejes
    [Eje.SLDPRT, Eje_Carga.SLDPRT]
2018-04-17 Ensamble 2 Final
    [Base_Sensor.SLDPRT, Central_Pieza Inferior.SLDPRT, Central_Pieza.SLDPRT, Eje.SLDPRT, Eje_Carga.SLDPRT, EnsamblajeFinal2.SLDASM, Pieza_Inferior.SLDPRT, Pieza_Superior.SLDPRT]
2018-04-17 EnsambleFinal2 Steve
    [Central_Pieza.SLDPRT, EnsamblajeCarga.SLDASM, EnsamblajeFinal2.SLDASM, Pieza_Inferior.SLDPRT, Soporte_Rol.SLDASM]
2018-04-18 Ensamblaje correjido la carga
    [Acelerometro_Sujecion.SLDPRT, Carga2.SLDPRT, Carga2_Acelerometro.SLDPRT, Carga5.SLDPRT, EnsamblajeCarga.SLDASM, EnsamblajeFinal2.SLDASM, Sujecion_Rol_Lateral.SLDPRT]
2018-04-18 Acelerometro corregido
    [Acelerometro.SLDPRT, EnsamblajeCarga.SLDASM, EnsamblajeFinal2.SLDASM]
2018-04-23 Amortizacion deuda
    [Control de Compras y amortizacion.xlsx]
2018-04-23 Acelerometro motor
    [Acelerometro_Motor_1.SLDPRT, Acelerometro_Motor_2.SLDPRT, Sccel_Lat.SLDASM]
2018-04-23 Acelerometro lateral y arreglo de base
    [Base10.SLDPRT, Base11.SLDPRT, Base3_2.SLDPRT, EnsamblajeBase.SLDASM, EnsamblajeFinal2.SLDASM, Pieza_Inferior.SLDPRT, Puntal.SLDPRT, Soporte_Rol.SLDASM]
2018-04-24 Agujeros Base
    [Base11.SLDPRT, EnsamblajeBase.SLDASM, EnsamblajeFinal2.SLDASM, Soporte_Botonera.SLDPRT, Soporte_Rol.SLDASM]
2018-04-25 Hueco base cables motor
    [Base3_2.SLDPRT, EnsamblajeFinal2.SLDASM]
2018-04-25 Huecos base
    [Base11.SLDPRT, EnsamblajeBase.SLDASM, EnsamblajeFinal2.SLDASM, Soporte_Rol.SLDASM, Soporte_Rol_Corte.SLDDRW]
2018-04-25 Plano MDF 5_5
    [Soporte_Rol_Corte.SLDDRW]
2018-04-25 Planos MDF 3 mm
    [CorteAcrilico5_5.SLDDRW, CorteMDF3mm.SLDDRW]
2018-04-25 Hueco arduino
    [Base10.SLDPRT, EnsamblajeBase.SLDASM, EnsamblajeFinal2.SLDASM, Ensamblaje_Electronica.SLDASM, Soporte Izquierda.SLDASM, Soporte_Arduino.SLDPRT]
2018-04-26 Agujeros Arduino
    [Base10.SLDPRT, Base4.SLDPRT, EnsamblajeBase.SLDASM, EnsamblajeFinal2.SLDASM, Ensamblaje_Electronica.SLDASM, Soporte Izquierda.SLDASM, Soporte_Arduino.SLDPRT]
2018-05-01 Nuevos Planos de corte
    [CorteMDF3mmP1.SLDDRW, CorteMDF3mmP2.SLDDRW, CorteMDF3mmP3.SLDDRW]
2018-05-04 Plano de maquinado
    [Eje.SLDPRT, Eje_Carga.SLDPRT, Ejes_Maquinado.SLDDRW, EnsamblajeFinal2.SLDASM]
2018-05-06 Arduino code
    [Ejes_Maquinado.SLDDRW, EnsamblajeFinal2.SLDASM]
2018-05-07 Control de gastos
    [Control de Compras y amortizacion.xlsx]
2018-05-09 Planos nuevos de corte
    [Ejes_Maquinado.SLDDRW, Planos_Corte_Nuevo.SLDDRW, Soporte_Arduino.SLDPRT]
2018-05-09 Planos de orte
    [Base11.SLDPRT, Planos_Corte_Nuevo.SLDDRW]
2018-05-15 Planos Engranes
    [CorteAcrilico3.SLDDRW, Engrane2.SLDPRT, Engrane3y4.SLDPRT, EnsamblajeBase.SLDASM, EnsamblajeFinal2.SLDASM, Ensamblaje_Electronica.SLDASM, Soporte Izquierda.SLDASM]
2018-05-24 Nuevos Cambios
    [Carga1_CAMBIOS1.SLDPRT, Carga1_CAMBIOS2.SLDPRT, Carga3_1_CAMBIOS.SLDPRT, Carga3_1_CAMBIOS2.SLDPRT, Carga6_CAMBIO.SLDPRT, Soportepiezas1.SLDPRT, Soportepiezas2.SLDPRT]
2018-05-24 Planos engranes y carga
    [CorteAcrilico3.SLDDRW, CorteMDF3mm_Carga_01.SLDDRW, CorteMDF3mm_Carga_02.SLDDRW, Engrane2_3_80.SLDPRT, Engrane3_Motor.SLDPRT, Engrane4_Carga.SLDPRT, EnsamblajeFinal2.SLDASM]
2018-05-24 Pieza de soporte
    [Soporte_a_base.SLDPRT]
2018-05-24 Planos Soporte a Base
    [MDF3mm_Soporte_a_base.SLDDRW]
2018-06-04 Resultados experimentos
    [1 Vel Carga.xlsx, Experimento 20.xlsx, Medición de las masas.xlsx, Medición de las velocidades.xlsx]
2018-06-04 Medición de velocidades
    [Medición de las masas.xlsx, Medición de las velocidades.xlsx]
2018-06-08 lista de piezas
    [BasePiezas01.SLDDRW, BasePiezas02.SLDDRW, Ensamblaje6.SLDASM, EnsamblajeBase.SLDASM, EnsamblajeCarga Nuevo.SLDASM, EnsamblajeFinal2 - Backup 7-06-2018.SLDASM, EnsamblajeFinal2.SLDASM, Ensamblaje_Electronica.SLDASM]
2018-06-08 Tornillos base
    [EnsamblajeBase.SLDASM]
2018-06-08 Carga Diego
    [4_PlanoConjuntoCarga.SLDDRW, Acelerometro_Sujecion.SLDPRT, Carga1_1.SLDPRT, Carga1_CAMBIOS1.SLDPRT, Carga1_CAMBIOS2.SLDPRT, Carga2.SLDPRT, Carga2_Acelerometro.SLDPRT, Carga3.SLDPRT]
2018-06-08 Base terminada
    [02_PlanoConjuntoBase.SLDDRW, 05_PlanoExplosionadoBase.SLDDRW, EnsamblajeBase.SLDASM, EnsamblajeCarga.SLDASM, EnsamblajeFinal2.SLDASM, Soporte_Rol.SLDASM]
2018-06-08 Planos finales
    [01_EspecificaciónTécnica.SLDDRW, 02_PlanoConjuntoBase.SLDDRW, 04_PlanoConjuntoBase.SLDDRW, 05_PlanoExplosionadoBase.SLDDRW, 06_PlanoConjuntoSoporte_Rol.SLDDRW, 07_PlanoExplosionadoSoporte_Rol.SLDDRW, EnsamblajeBase.SLDASM, EnsamblajeFinal2.SLDASM]
